actuallysparky/bearamin/field-guide/index.html

BEARAMINFIELD GUIDE / DEVICE EDITOR

YOUR BEARNot connected

USB MIDI or Bluetooth MIDI

Disconnected

Connect your Bearamin ↗

Small bear.
Big possibilities.

FIELD GUIDE / MIDI & GESTURESConnect to get started

LIVE FIELDⅡ

NearFar

X

—

Y

—

Z

—

○ PRESENCE○ SPANK

Connect to see your field.

ON BEIN’ BEAR

Wave a paw.
Bow closer.
Hold still.
Swat the air.

Connect to read your settings.

RevertSave to device ↗

Close
