actuallysparky/bearamin/field-guide/install.html

BEARAMIN / FIELD GUIDE ↗BEARAMIN FAMILY

SMALL BEAR. BIG POSSIBILITIES.

# A little motion. A lot of possibility.

A whole copse of Bearamin friends. Connect yours, find your sound, and make motion yours.

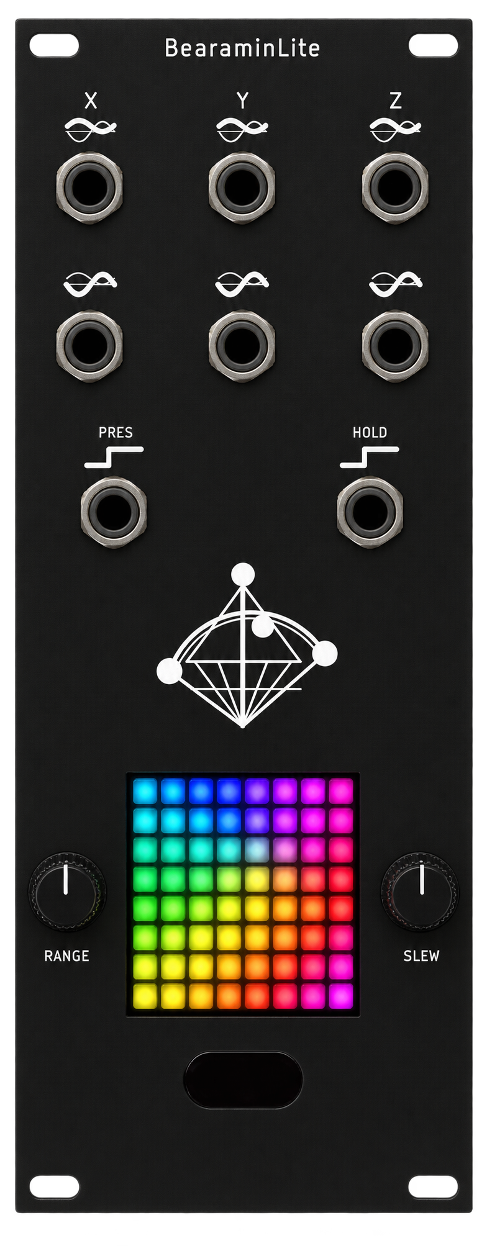
[picture p2: field-guide/panel.png]
Bearamin Lite panel


FIND YOUR FRIEND

## Welcome to the family.

Connect one Bearamin at a time by USB or Bluetooth MIDI, then choose Connect. We’ll find its firmware and show you the steps. For Bluetooth, connect it in your computer’s MIDI settings first.

Connect your Bearamin ↗

First time here?

First firmware update? Choose your Bearamin to get started.

Bearamin LiteBearamin Virtual

RIGHT HERE. READY TO PLAY.

## Your Bearamin is ready.

Let’s play ↗

Need a fresh start? Re-install firmware

LATEST BUILD

## Checking firmware…

Preparing your installation.

1. Open this page in desktop Chrome or Edge and connect Bearamin Lite with a USB data cable.
2. Close any app using its USB connection. Hold BOOT, press and release RESET, then release BOOT if the device does not appear.
3. Choose Install, select your Bearamin’s USB port, and follow the prompts. Keep it powered and connected until installation finishes.
4. Restart your Bearamin, then open Field Guide and choose Connect.

Install Bearamin LiteUse desktop Chrome or Edge to install by USB, or download the firmware below.Open this page using HTTPS to install.Open Field Guide ↗
