actuallysparky/bearamin/bearamin-virtual/hw/bearamin-virtual/Bearamin-Virtual_2040.kicad_pcb

## KiCad design bearamin-virtual/hw/bearamin-virtual/Bearamin-Virtual_2040.kicad_pcb (2026-10-14)

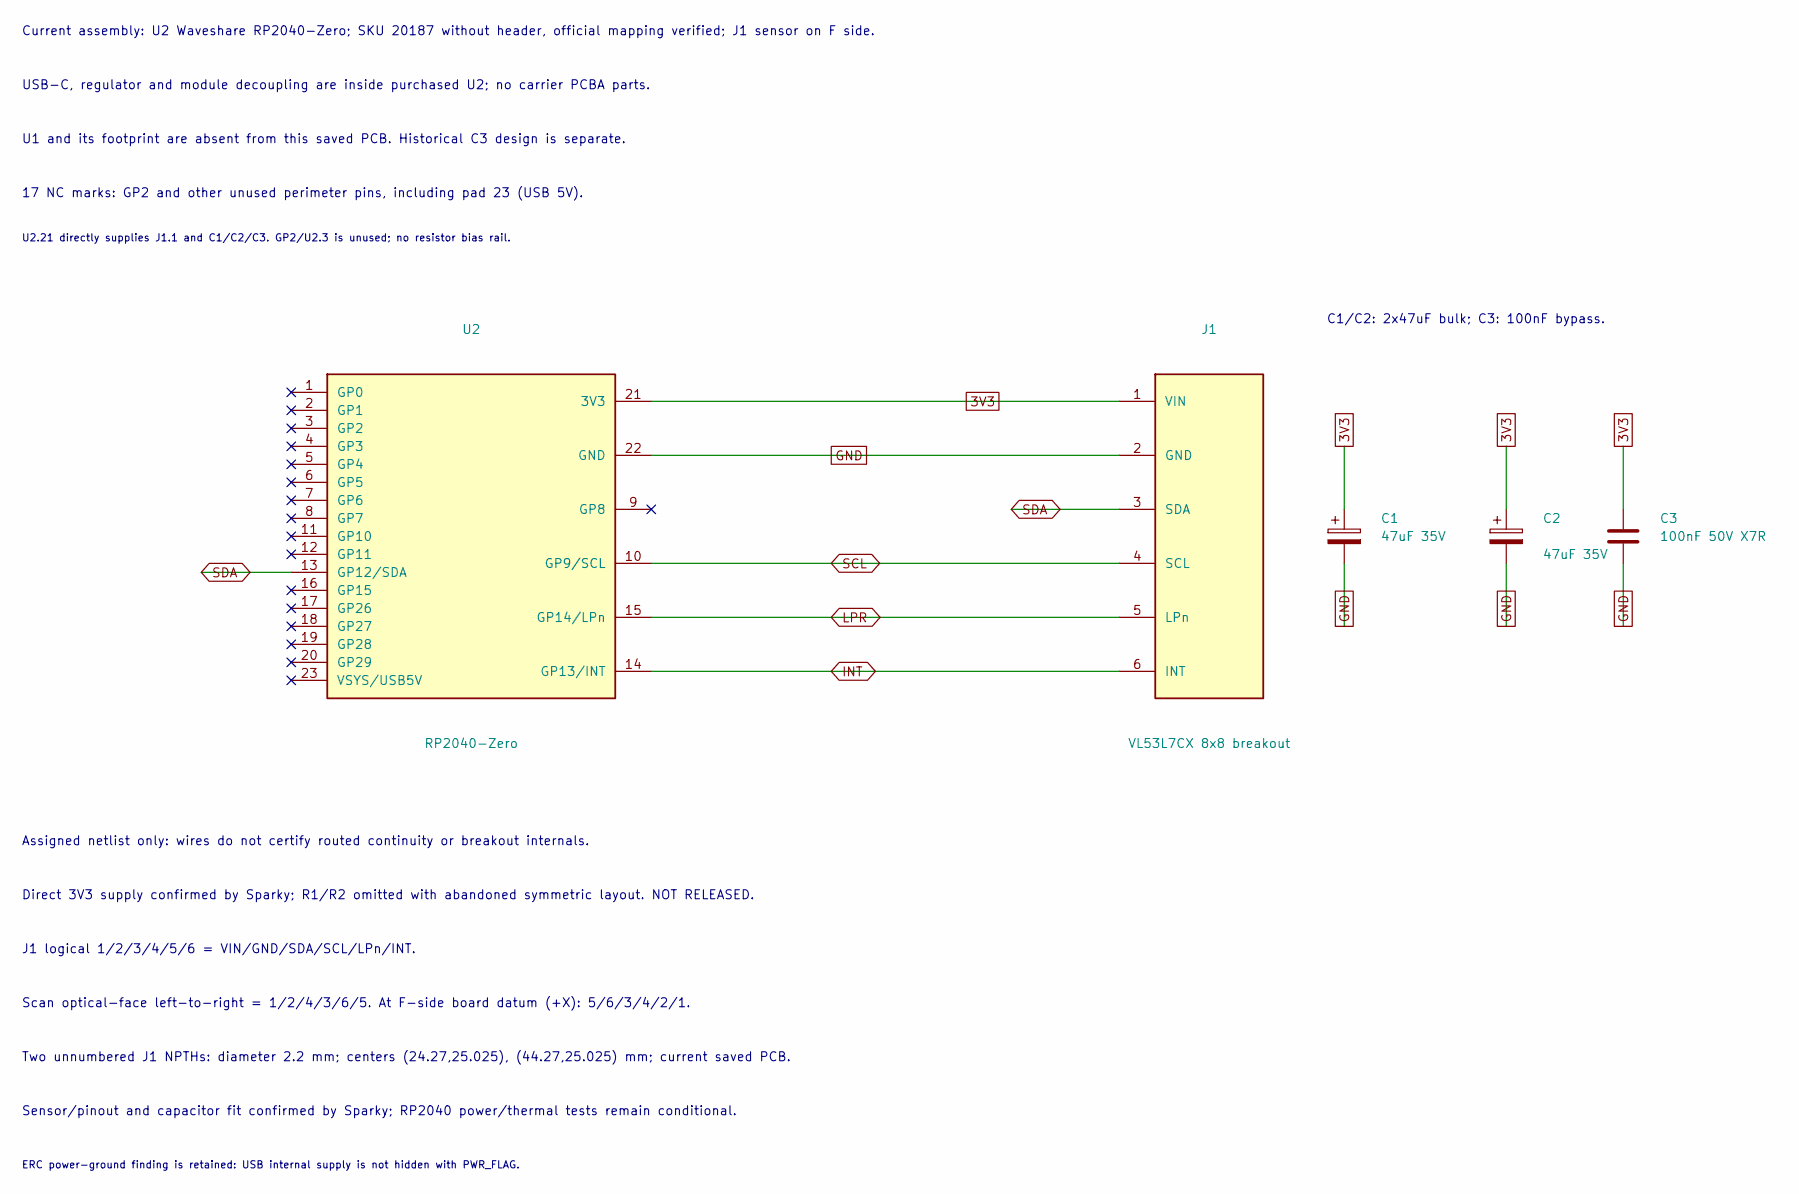
[picture p3: schematic Bearamin-Virtual_2040.kicad_sch, Bearamin Virtual - RP2040 review]

Parts:
C1, C2: 47uF 35V; CP_Radial_D5.0mm_P2.00mm; MPN 35ZLH47MEFC5X11
C3: 100nF 50V X7R; C_Disc_D5.0mm_W2.5mm_P5.00mm; MPN RDER71H104K0M1H03A
J1: VL53L7CX 8x8 breakout; VL53L7CX_8x8_J1_ScanMount
U2: RP2040-Zero; RP2040-Zero_1x23

Connections:
3V3: C1.1, C2.1, C3.1, J1.1 (VIN), U2.21 (3V3)
GND: C1.2, C2.2, C3.2, J1.2 (GND), U2.22 (GND)
INT: J1.6 (INT), U2.14 (GP13/INT)
LPR: J1.5 (LPn), U2.15 (GP14/LPn)
SCL: J1.4 (SCL), U2.10 (GP9/SCL)
SDA: J1.3 (SDA), U2.13 (GP12/SDA)

Notes on the sheet:
Current assembly: U2 Waveshare RP2040-Zero; SKU 20187 without header, official mapping verified; J1 sensor on F side.
USB-C, regulator and module decoupling are inside purchased U2; no carrier PCBA parts.
U1 and its footprint are absent from this saved PCB. Historical C3 design is separate.
17 NC marks: GP2 and other unused perimeter pins, including pad 23 (USB 5V).
Assigned netlist only: wires do not certify routed continuity or breakout internals.
Direct 3V3 supply confirmed by Sparky; R1/R2 omitted with abandoned symmetric layout. NOT RELEASED.
J1 logical 1/2/3/4/5/6 = VIN/GND/SDA/SCL/LPn/INT.
Scan optical-face left-to-right = 1/2/4/3/6/5. At F-side board datum (+X): 5/6/3/4/2/1.
Two unnumbered J1 NPTHs: diameter 2.2 mm; centers (24.27,25.025), (44.27,25.025) mm; current saved PCB.
Sensor/pinout and capacitor fit confirmed by Sparky; RP2040 power/thermal tests remain conditional.
ERC power-ground finding is retained: USB internal supply is not hidden with PWR_FLAG.
C1/C2: 2x47uF bulk; C3: 100nF bypass.
U2.21 directly supplies J1.1 and C1/C2/C3. GP2/U2.3 is unused; no resistor bias rail.

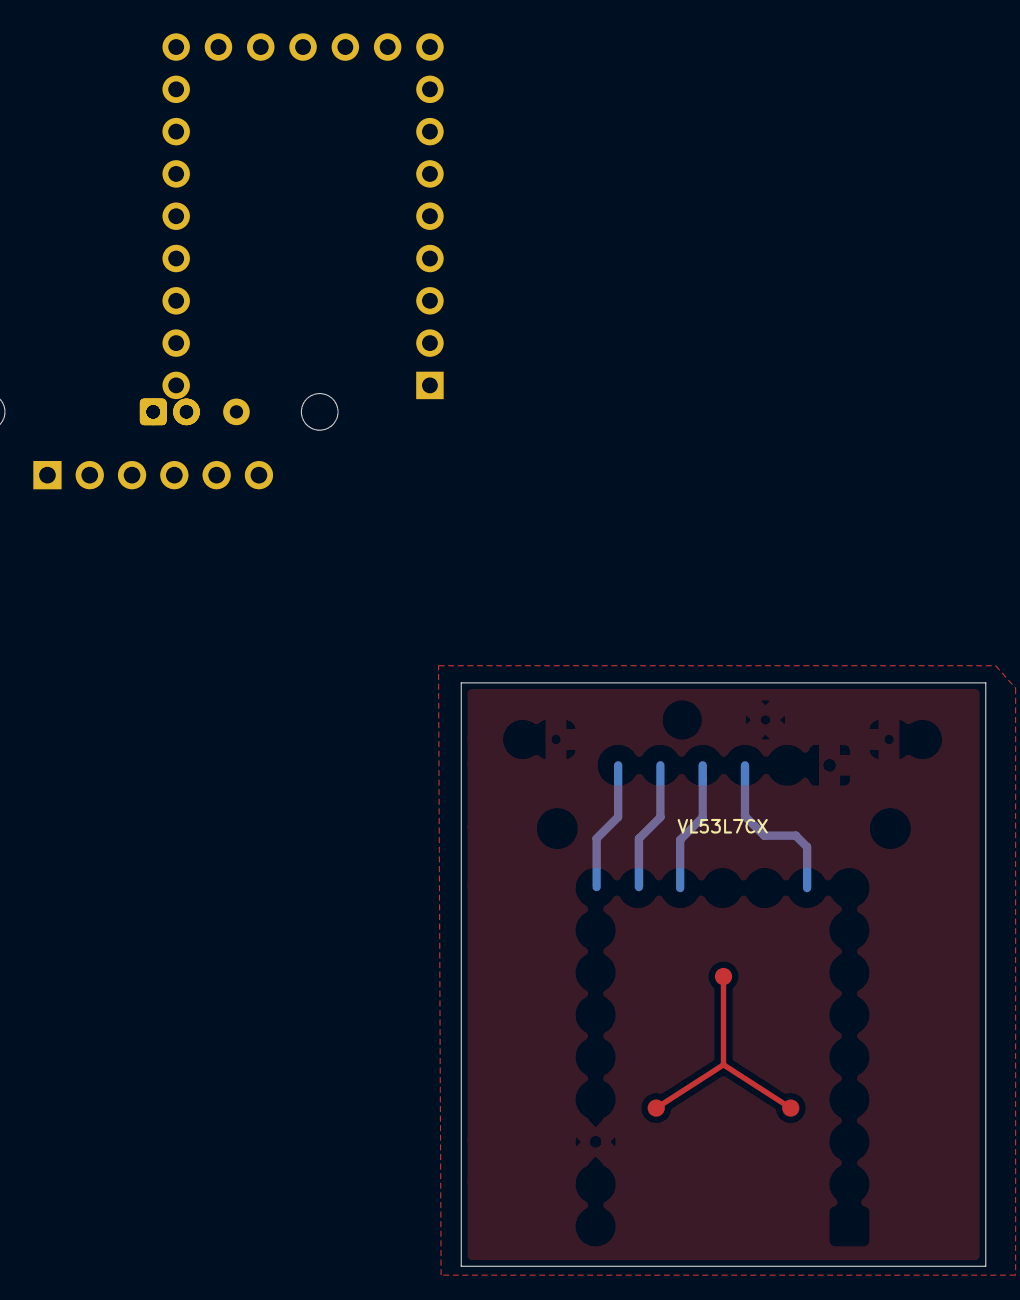
[picture p4: board Bearamin-Virtual_2040.kicad_pcb from above]

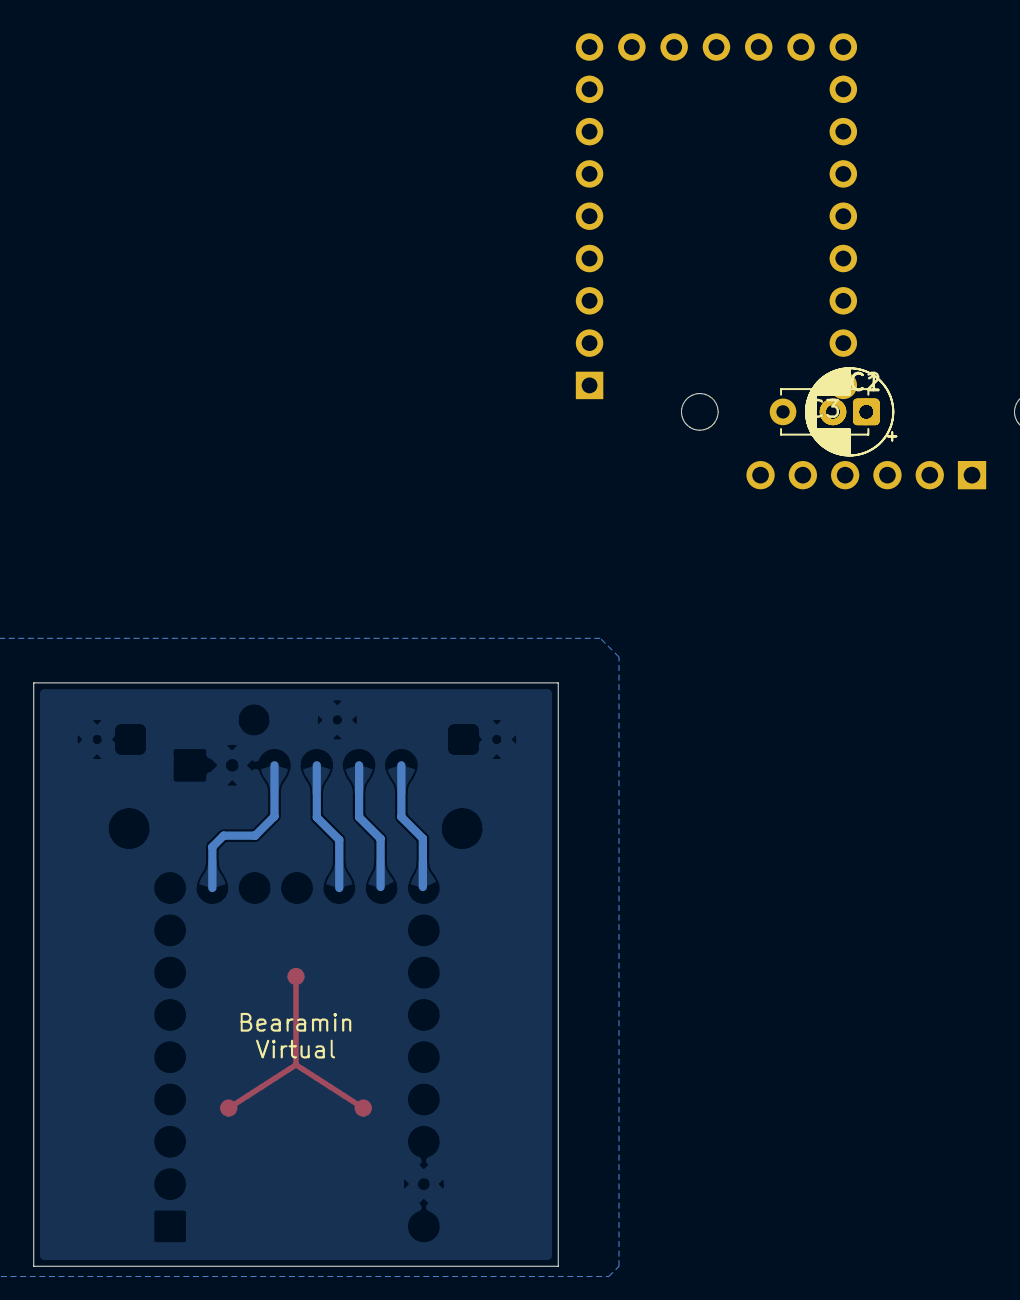
[picture p5: board Bearamin-Virtual_2040.kicad_pcb from below]

Board: 2 copper layers, 31.5 x 35.0 mm, 5 parts (4 on the bottom side), 6 nets.
