actuallysparky/bearamin/bearamin-lite/hw/bearcv-10hp/bearcv-10hp-main_dualMCP4728_routed_DRC_pinremap_revc.kicad_pcb

## KiCad design bearamin-lite/hw/bearcv-10hp/bearcv-10hp-main_dualMCP4728_routed_DRC_pinremap_revc.kicad_pcb (2026-10-14)

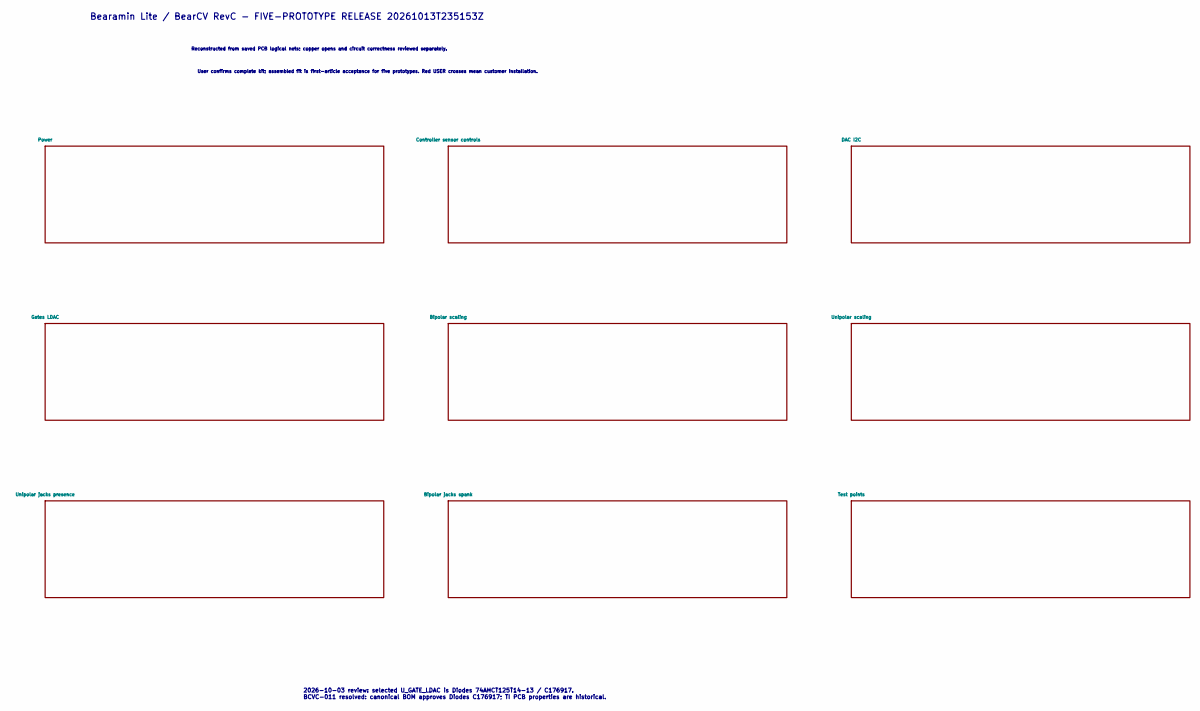
[picture p6: schematic bearcv-10hp-main_dualMCP4728_routed_DRC_pinremap_revc.kicad_sch]

Notes on the sheet:
Bearamin Lite / BearCV RevC - FIVE-PROTOTYPE RELEASE 20261013T235153Z
Reconstructed from saved PCB logical nets; copper opens and circuit correctness reviewed separately.
User confirms complete kit; assembled fit is first-article acceptance for five prototypes. Red USER crosses mean customer installation.
2026-10-03 review: selected U_GATE_LDAC is Diodes 74AHCT125T14-13 / C176917. BCVC-011 resolved: canonical BOM approves Diodes C176917; TI PCB properties are historical.

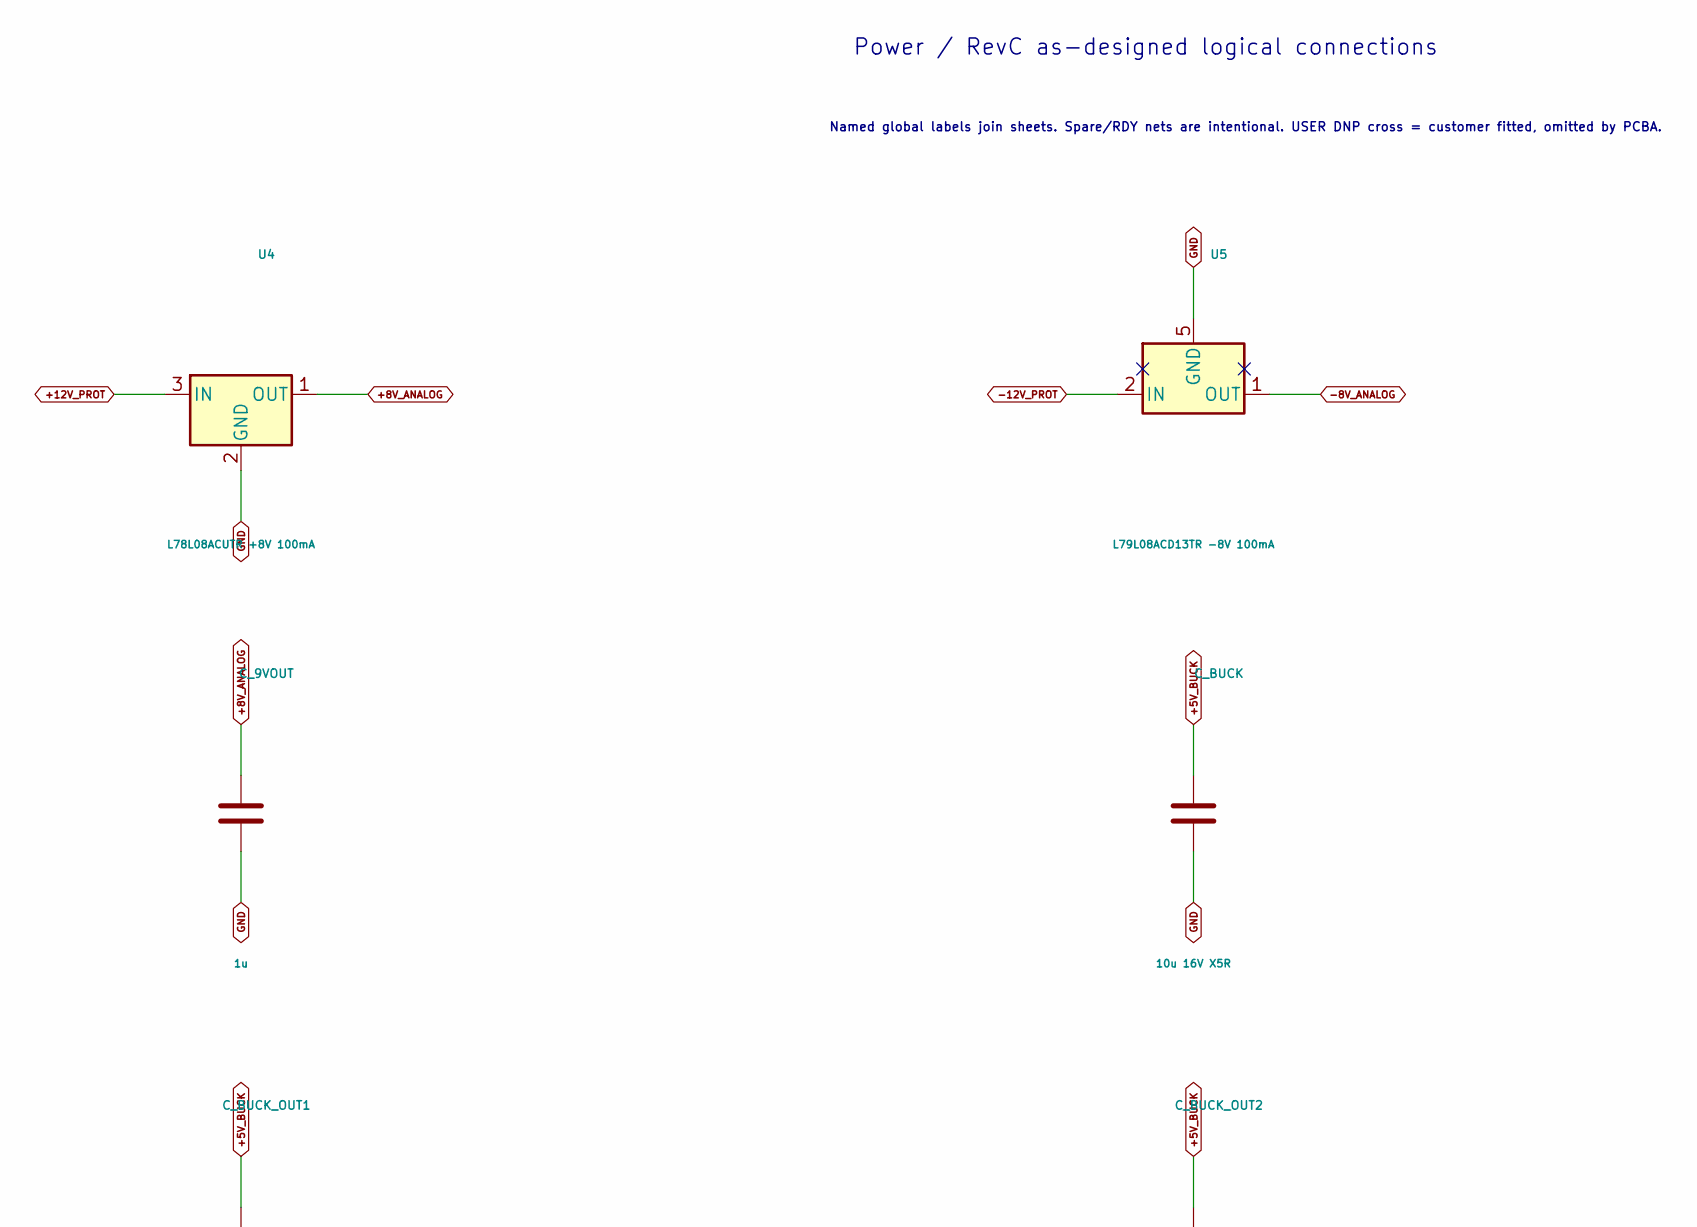
[picture p7: schematic bearcv-10hp-main_dualMCP4728_routed_DRC_pinremap_revc_Power.kicad_sch, part in row 1, column 1]

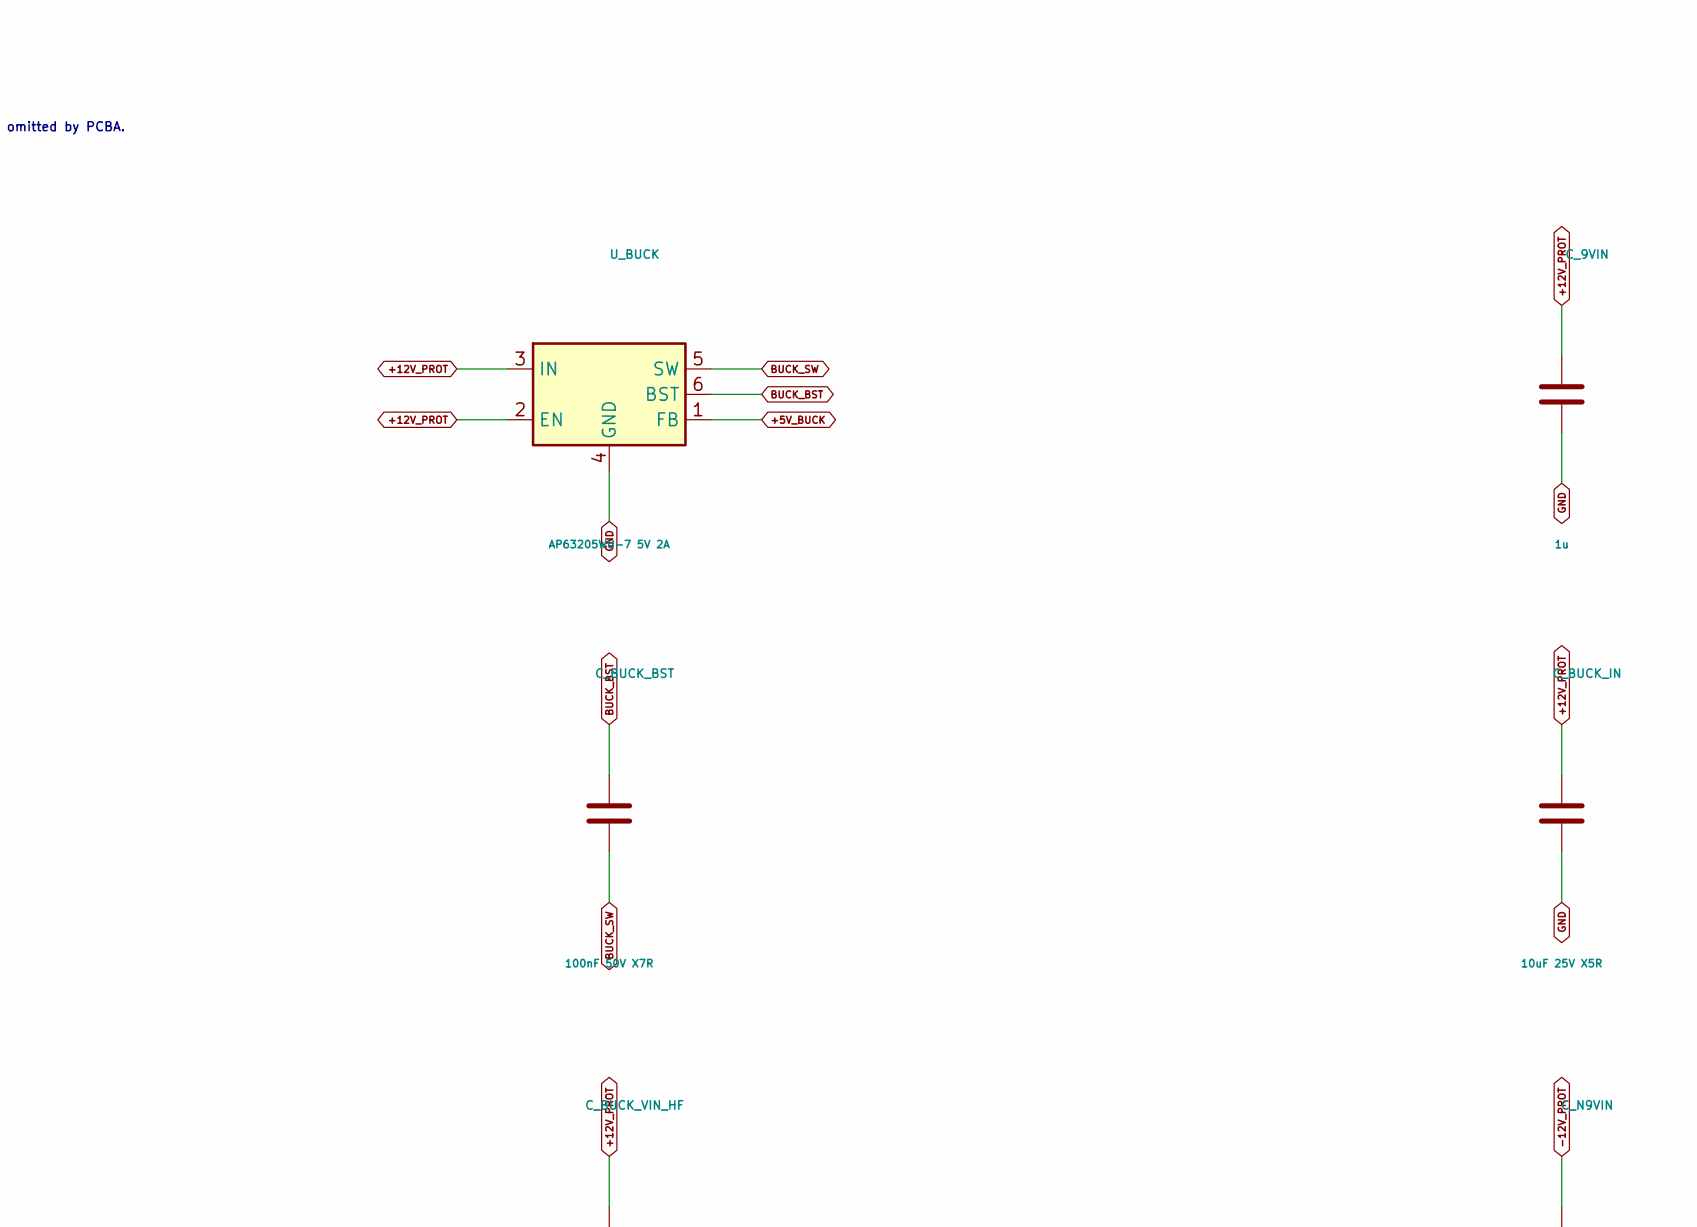
[picture p8: schematic bearcv-10hp-main_dualMCP4728_routed_DRC_pinremap_revc_Power.kicad_sch, part in row 1, column 2]

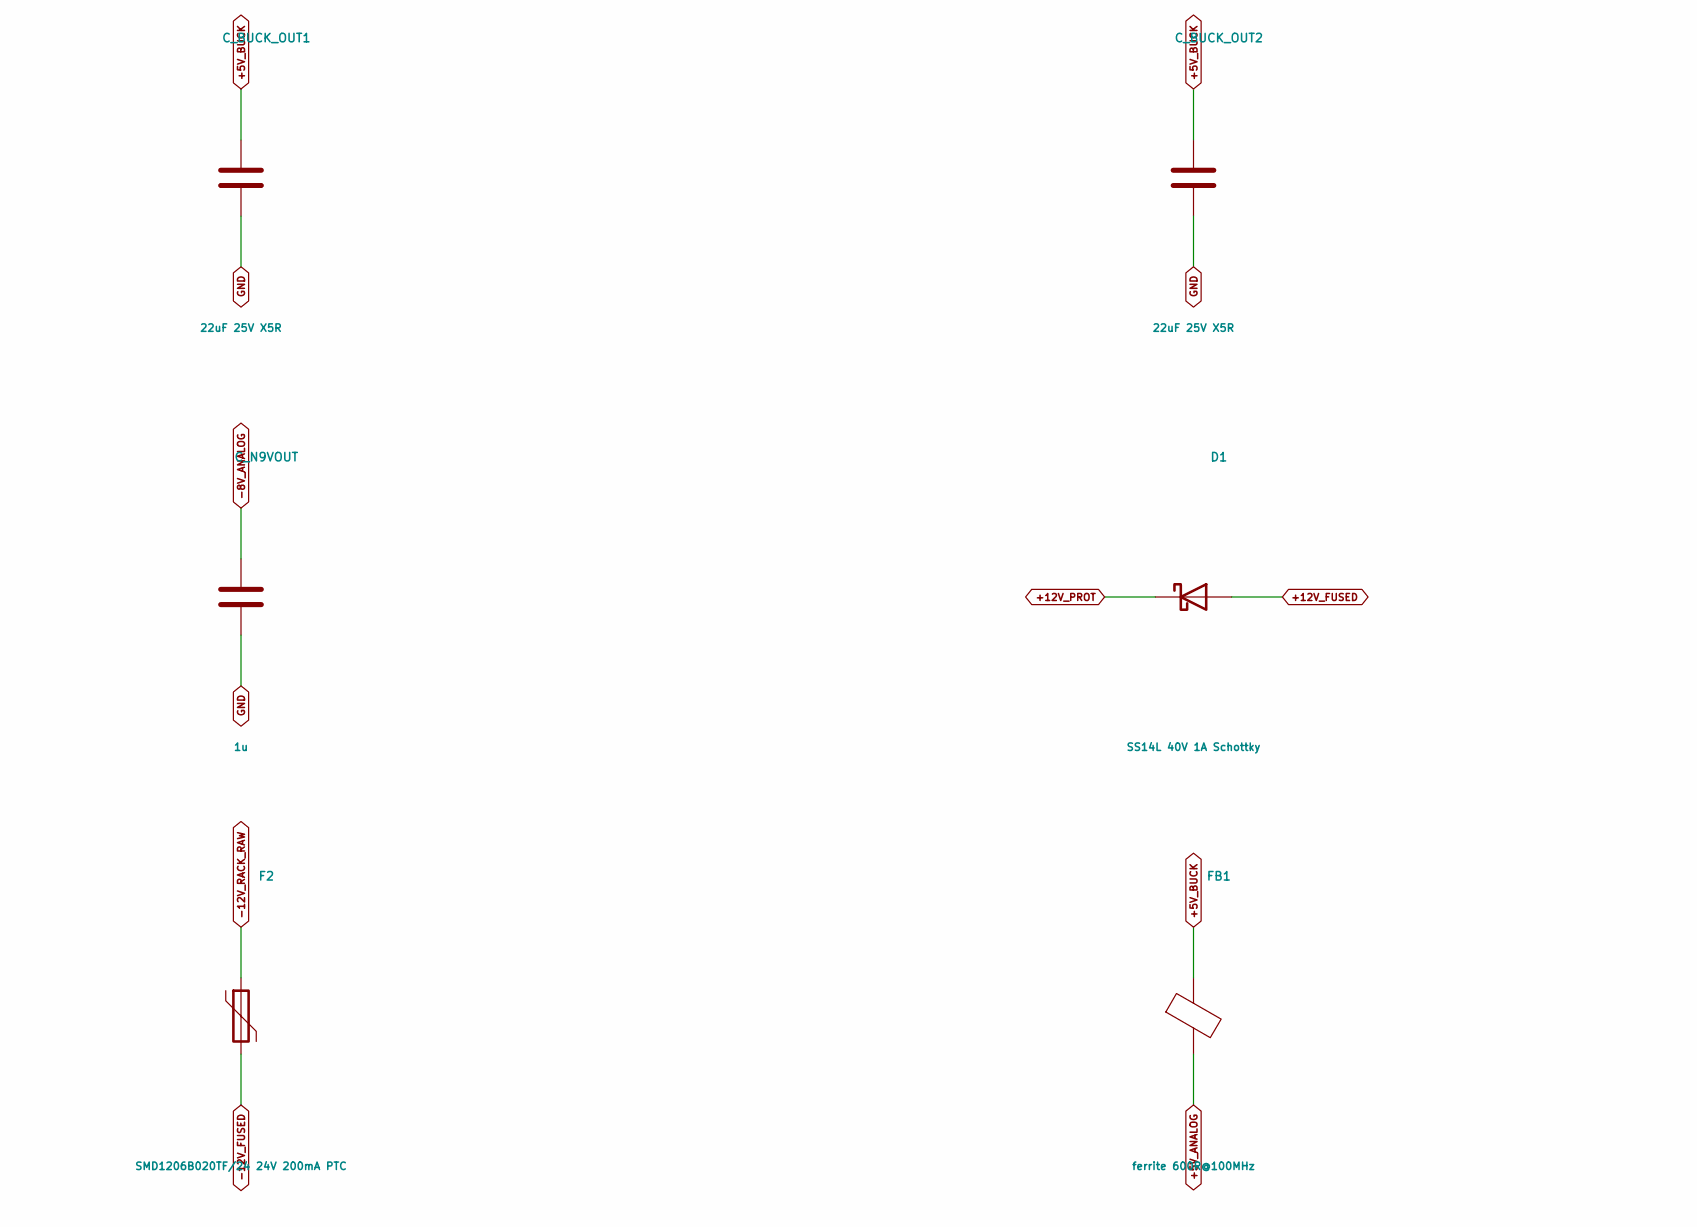
[picture p9: schematic bearcv-10hp-main_dualMCP4728_routed_DRC_pinremap_revc_Power.kicad_sch, part in row 2, column 1]

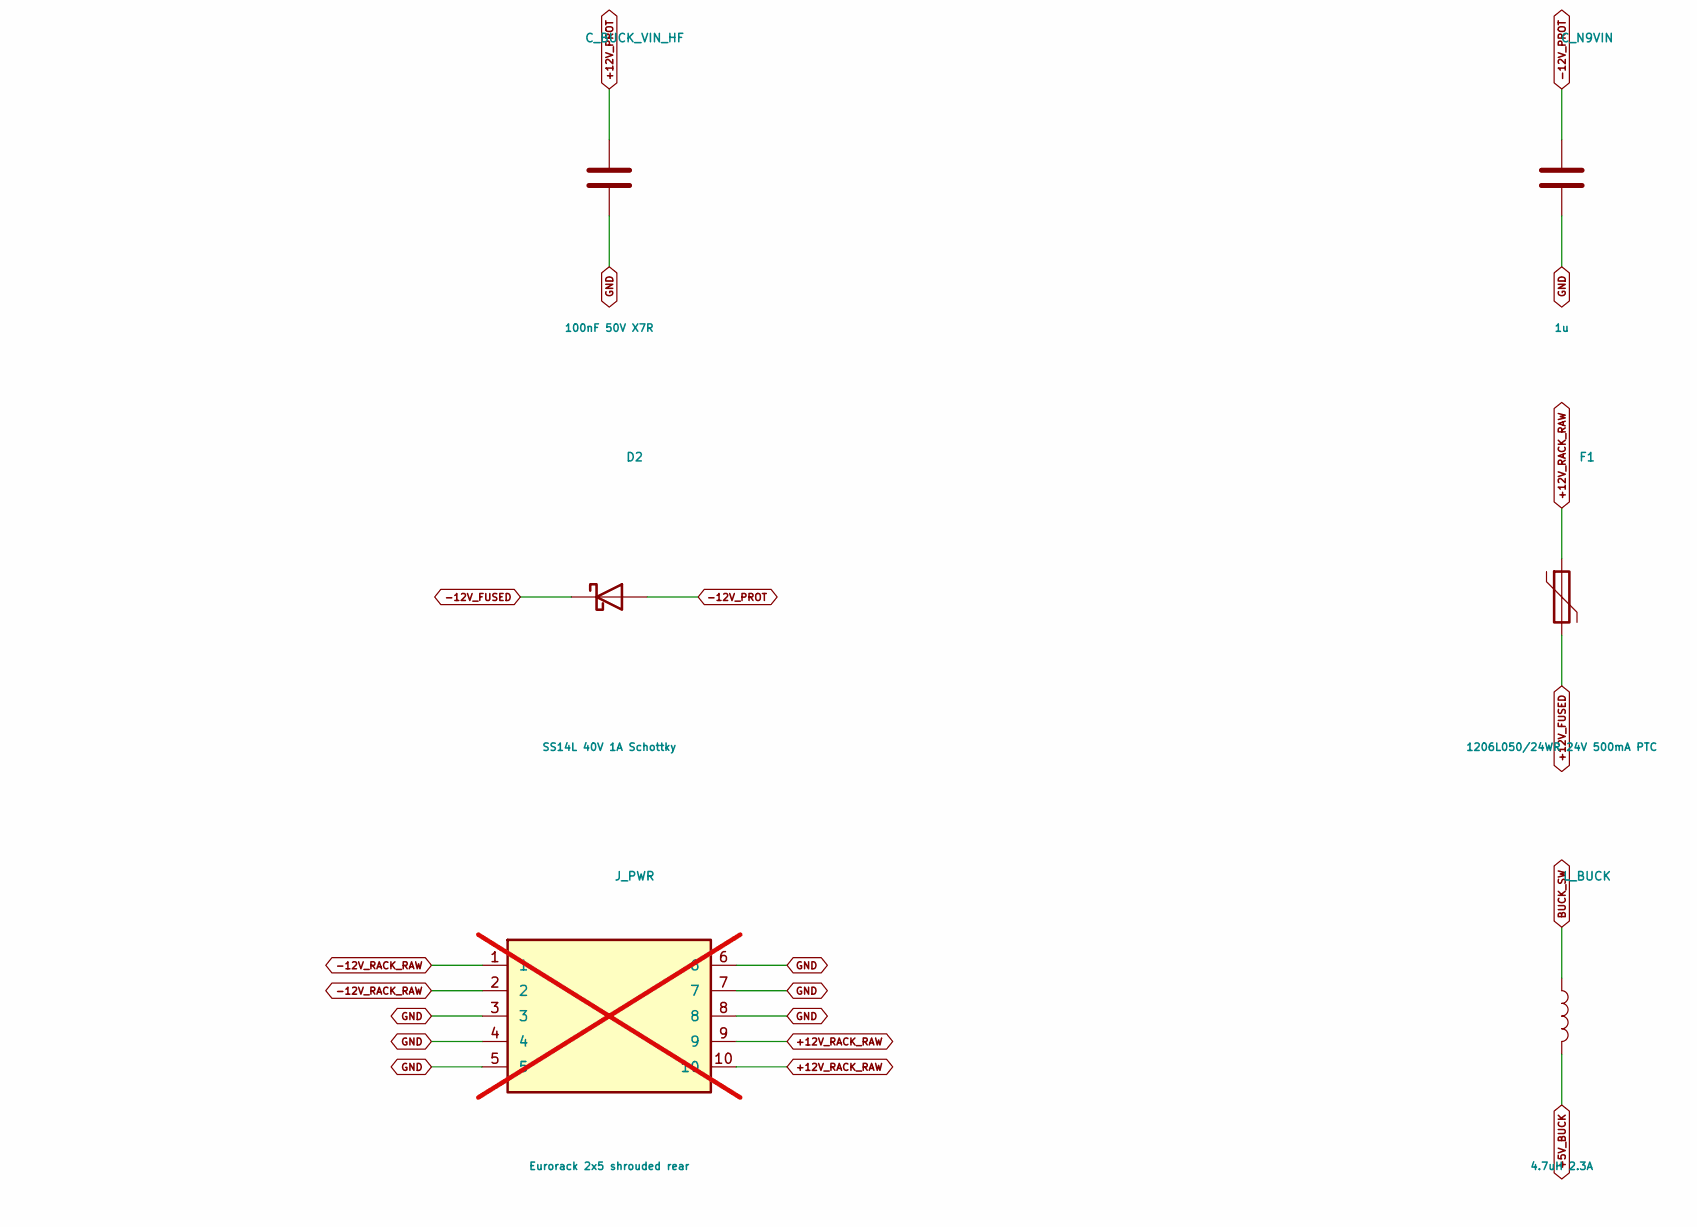
[picture p10: schematic bearcv-10hp-main_dualMCP4728_routed_DRC_pinremap_revc_Power.kicad_sch, part in row 2, column 2]

Parts:
C_9VIN, C_9VOUT: 1u; MPN CL10A105KB8NNNC; JLCPCB Part C15849
C_BUCK: 10u 16V X5R; MPN CL10A106MA8NRNC; JLCPCB Part C96446
C_BUCK_BST: 100nF 50V X7R; MPN CC0603KRX7R9BB104; JLCPCB Part C14663
C_BUCK_IN: 10uF 25V X5R; MPN CL21A106KAYNNNE; JLCPCB Part C15850
C_BUCK_OUT1, C_BUCK_OUT2: 22uF 25V X5R; MPN CL21A226MAQNNNE; JLCPCB Part C45783
C_BUCK_VIN_HF: 100nF 50V X7R; MPN CC0603KRX7R9BB104; JLCPCB Part C14663
C_N9VIN, C_N9VOUT: 1u; MPN CL10A105KB8NNNC; JLCPCB Part C15849
D1, D2: SS14L 40V 1A Schottky; MPN SS14L; JLCPCB Library Extended
F1: 1206L050/24WR 24V 500mA PTC; MPN 1206L050/24WR; JLCPCB Library Extended
F2: SMD1206B020TF/24 24V 200mA PTC; MPN SMD1206B020TF/24; JLCPCB Library Extended
FB1: ferrite 600R@100MHz; MPN GZ1608D601TF; JLCPCB Part C1002
J_PWR: Eurorack 2x5 shrouded rear; IDC-Header_2x05_P2.54mm_Vertical; MPN DNP; not fitted
L_BUCK: 4.7uH 2.3A; MPN SLW4020P4R7MST; JLCPCB Part C207886
U4: L78L08ACUTR +8V 100mA; MPN L78L08ACUTR; JLCPCB Library Extended
U5: L79L08ACD13TR -8V 100mA; MPN L79L08ACD13TR; JLCPCB Library Extended
U_BUCK: AP63205WU-7 5V 2A; MPN AP63205WU-7; JLCPCB Part C2071056

Connections:
+5V_ANALOG: FB1.2; also elsewhere on the board
+5V_BUCK: C_BUCK.1, C_BUCK_OUT1.1, C_BUCK_OUT2.1, FB1.1, L_BUCK.2, U_BUCK.1 (FB); also elsewhere on the board
+8V_ANALOG: C_9VOUT.1, U4.1 (OUT); also elsewhere on the board
+12V_FUSED: D1.2 (A), F1.2
+12V_PROT: C_9VIN.1, C_BUCK_IN.1, C_BUCK_VIN_HF.1, D1.1 (K), U4.3 (IN), U_BUCK.2 (EN), U_BUCK.3 (IN); also elsewhere on the board
+12V_RACK_RAW: F1.1, J_PWR.9, J_PWR.10
-8V_ANALOG: C_N9VOUT.1, U5.1 (OUT); also elsewhere on the board
-12V_FUSED: D2.1 (K), F2.2
-12V_PROT: C_N9VIN.1, D2.2 (A), U5.2 (IN), U5.3 (IN), U5.6 (IN), U5.7 (IN); also elsewhere on the board
-12V_RACK_RAW: F2.1, J_PWR.1, J_PWR.2
BUCK_BST: C_BUCK_BST.1, U_BUCK.6 (BST)
BUCK_SW: C_BUCK_BST.2, L_BUCK.1, U_BUCK.5 (SW)
GND: C_9VIN.2, C_9VOUT.2, C_BUCK.2, C_BUCK_IN.2, C_BUCK_OUT1.2, C_BUCK_OUT2.2, C_BUCK_VIN_HF.2, C_N9VIN.2, C_N9VOUT.2, J_PWR.3, J_PWR.4, J_PWR.5, J_PWR.6, J_PWR.7, J_PWR.8, U4.2 (GND), U5.5 (GND), U_BUCK.4 (GND); also elsewhere on the board

Notes on the sheet:
Power / RevC as-designed logical connections
Named global labels join sheets. Spare/RDY nets are intentional. USER DNP cross = customer fitted, omitted by PCBA.

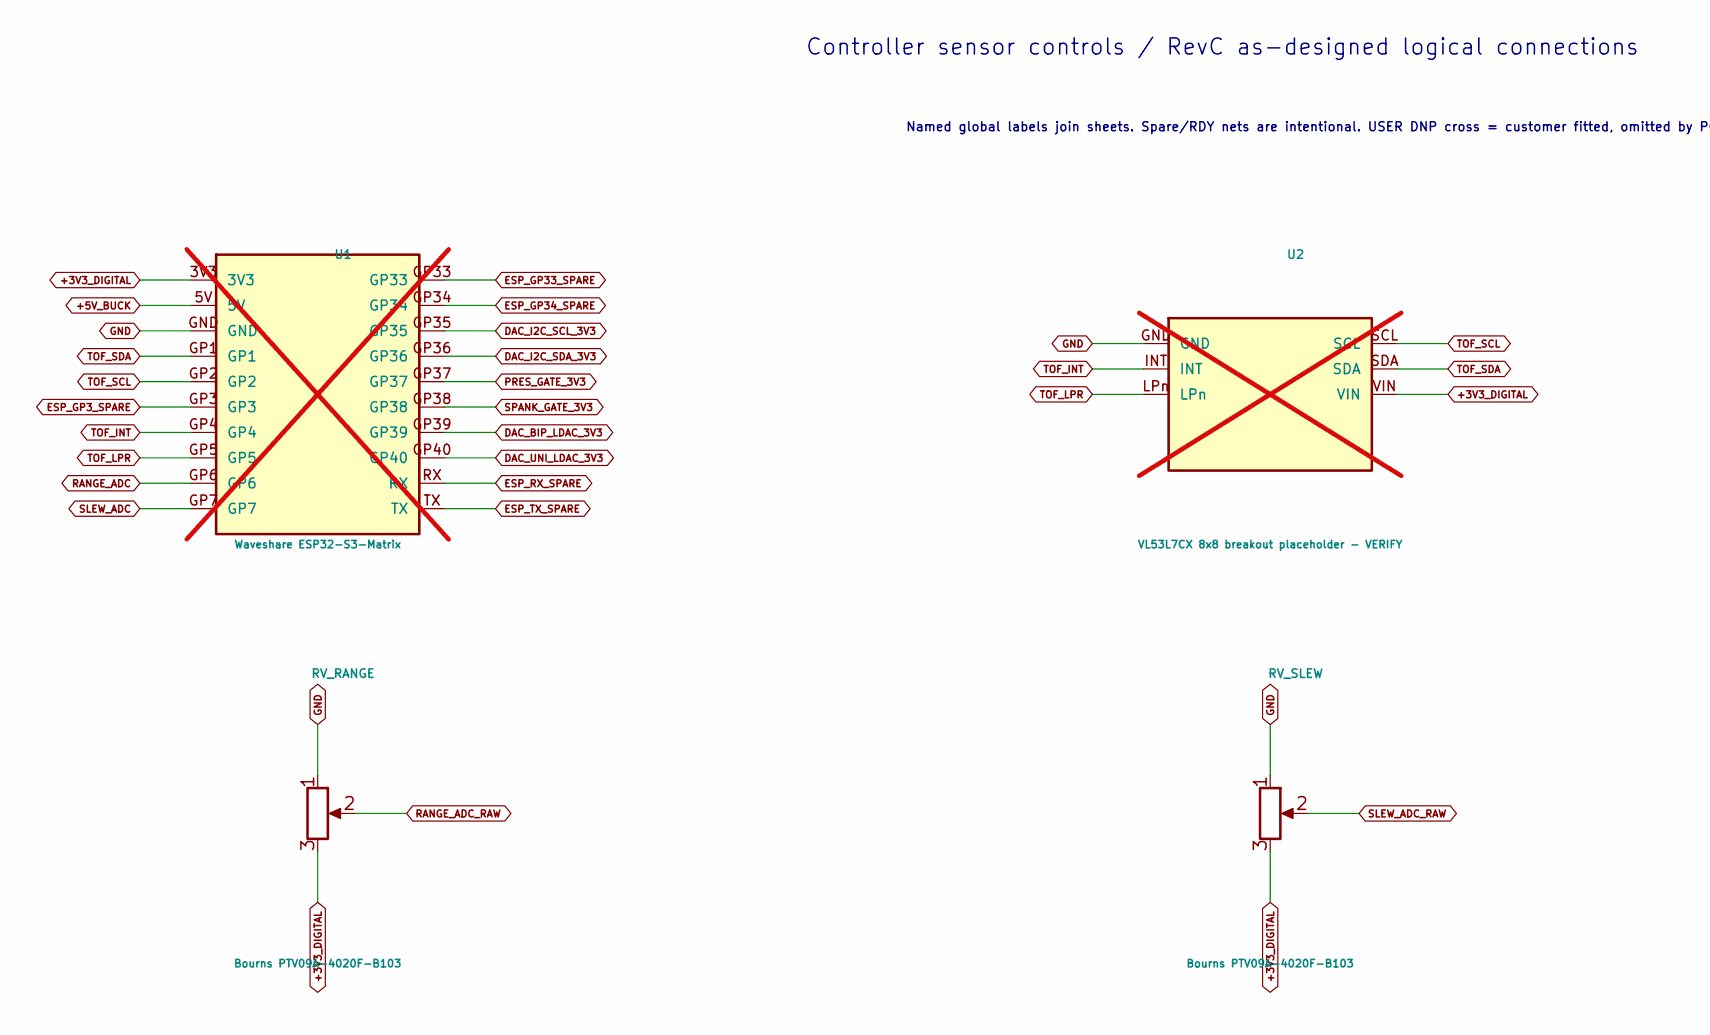
[picture p11: schematic bearcv-10hp-main_dualMCP4728_routed_DRC_pinremap_revc_Controller_sensor_controls.kicad_sch, part in row 1, column 1]

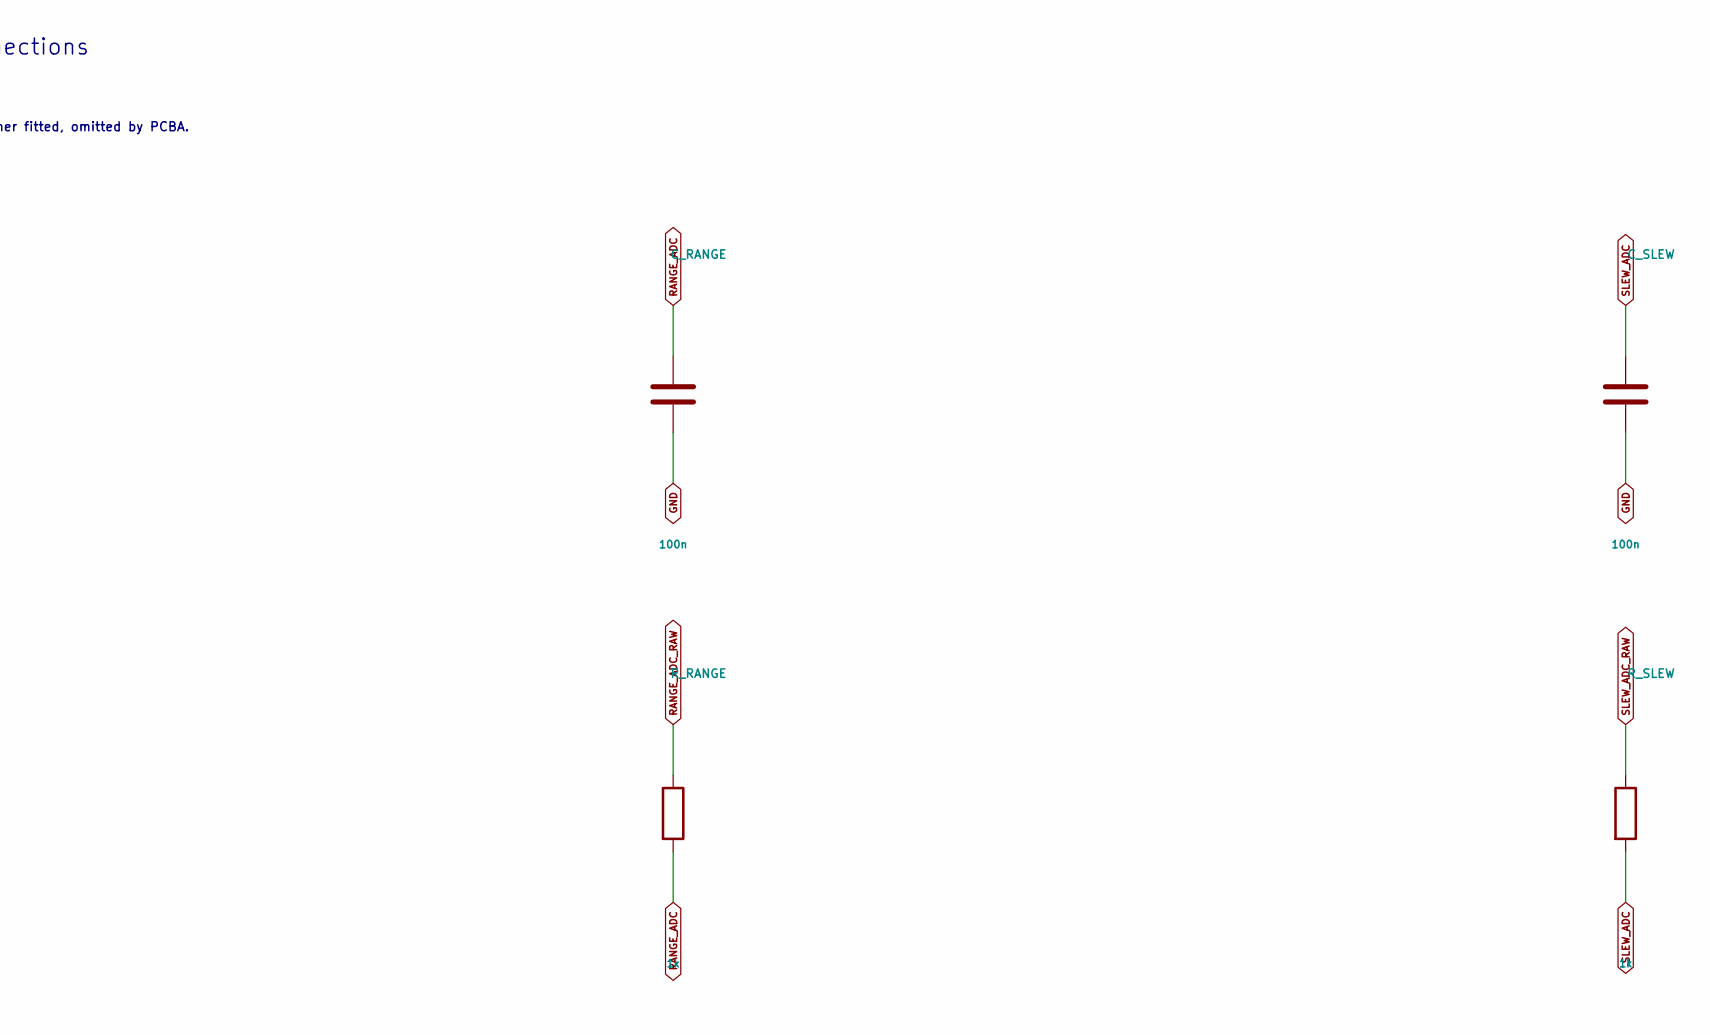
[picture p12: schematic bearcv-10hp-main_dualMCP4728_routed_DRC_pinremap_revc_Controller_sensor_controls.kicad_sch, part in row 1, column 2]

Parts:
C_RANGE: 100n; MPN CC0603KRX7R9BB104; JLCPCB Part C14663
C_SLEW: 100n; MPN CC0603KRX7R9BB104; JLCPCB Part C14663
RV_RANGE: Bourns PTV09A-4020F-B103; Potentiometer_Bourns_PTV09A-4F_L20mm_Horizontal_Rear; MPN PTV09A-4020F-B103
RV_SLEW: Bourns PTV09A-4020F-B103; Potentiometer_Bourns_PTV09A-4F_L20mm_Horizontal_Rear; MPN PTV09A-4020F-B103
R_RANGE: 1k; MPN 0603WAF1001T5E; JLCPCB Part C21190
R_SLEW: 1k; MPN 0603WAF1001T5E; JLCPCB Part C21190
U1: Waveshare ESP32-S3-Matrix; MPN DNP; not fitted
U2: VL53L7CX 8x8 breakout placeholder - VERIFY; MPN DNP; not fitted

Connections:
+3V3_DIGITAL: RV_RANGE.3, RV_SLEW.3, U1.3V3, U2.VIN; also elsewhere on the board
+5V_BUCK: U1.5V; also elsewhere on the board
DAC_BIP_LDAC_3V3: U1.GP39; also elsewhere on the board
DAC_I2C_SCL_3V3: U1.GP35; also elsewhere on the board
DAC_I2C_SDA_3V3: U1.GP36; also elsewhere on the board
DAC_UNI_LDAC_3V3: U1.GP40; also elsewhere on the board
ESP_GP3_SPARE: U1.GP3
ESP_GP33_SPARE: U1.GP33
ESP_GP34_SPARE: U1.GP34
ESP_RX_SPARE: U1.RX
ESP_TX_SPARE: U1.TX
GND: C_RANGE.2, C_SLEW.2, RV_RANGE.1, RV_SLEW.1, U1.GND, U2.GND; also elsewhere on the board
PRES_GATE_3V3: U1.GP37; also elsewhere on the board
RANGE_ADC: C_RANGE.1, R_RANGE.2, U1.GP6
RANGE_ADC_RAW: RV_RANGE.2, R_RANGE.1
SLEW_ADC: C_SLEW.1, R_SLEW.2, U1.GP7
SLEW_ADC_RAW: RV_SLEW.2, R_SLEW.1
SPANK_GATE_3V3: U1.GP38; also elsewhere on the board
TOF_INT: U1.GP4, U2.INT
TOF_LPR: U1.GP5, U2.LPn
TOF_SCL: U1.GP2, U2.SCL
TOF_SDA: U1.GP1, U2.SDA

Notes on the sheet:
Controller sensor controls / RevC as-designed logical connections
Named global labels join sheets. Spare/RDY nets are intentional. USER DNP cross = customer fitted, omitted by PCBA.
