actuallysparky/bearamin/bearamin-lite/hw/bearcv-10hp/bearcv-10hp-main_dualMCP4728_routed_DRC_pinremap_revc.kicad_pcb

## KiCad design bearamin-lite/hw/bearcv-10hp/bearcv-10hp-main_dualMCP4728_routed_DRC_pinremap_revc.kicad_pcb (continued)

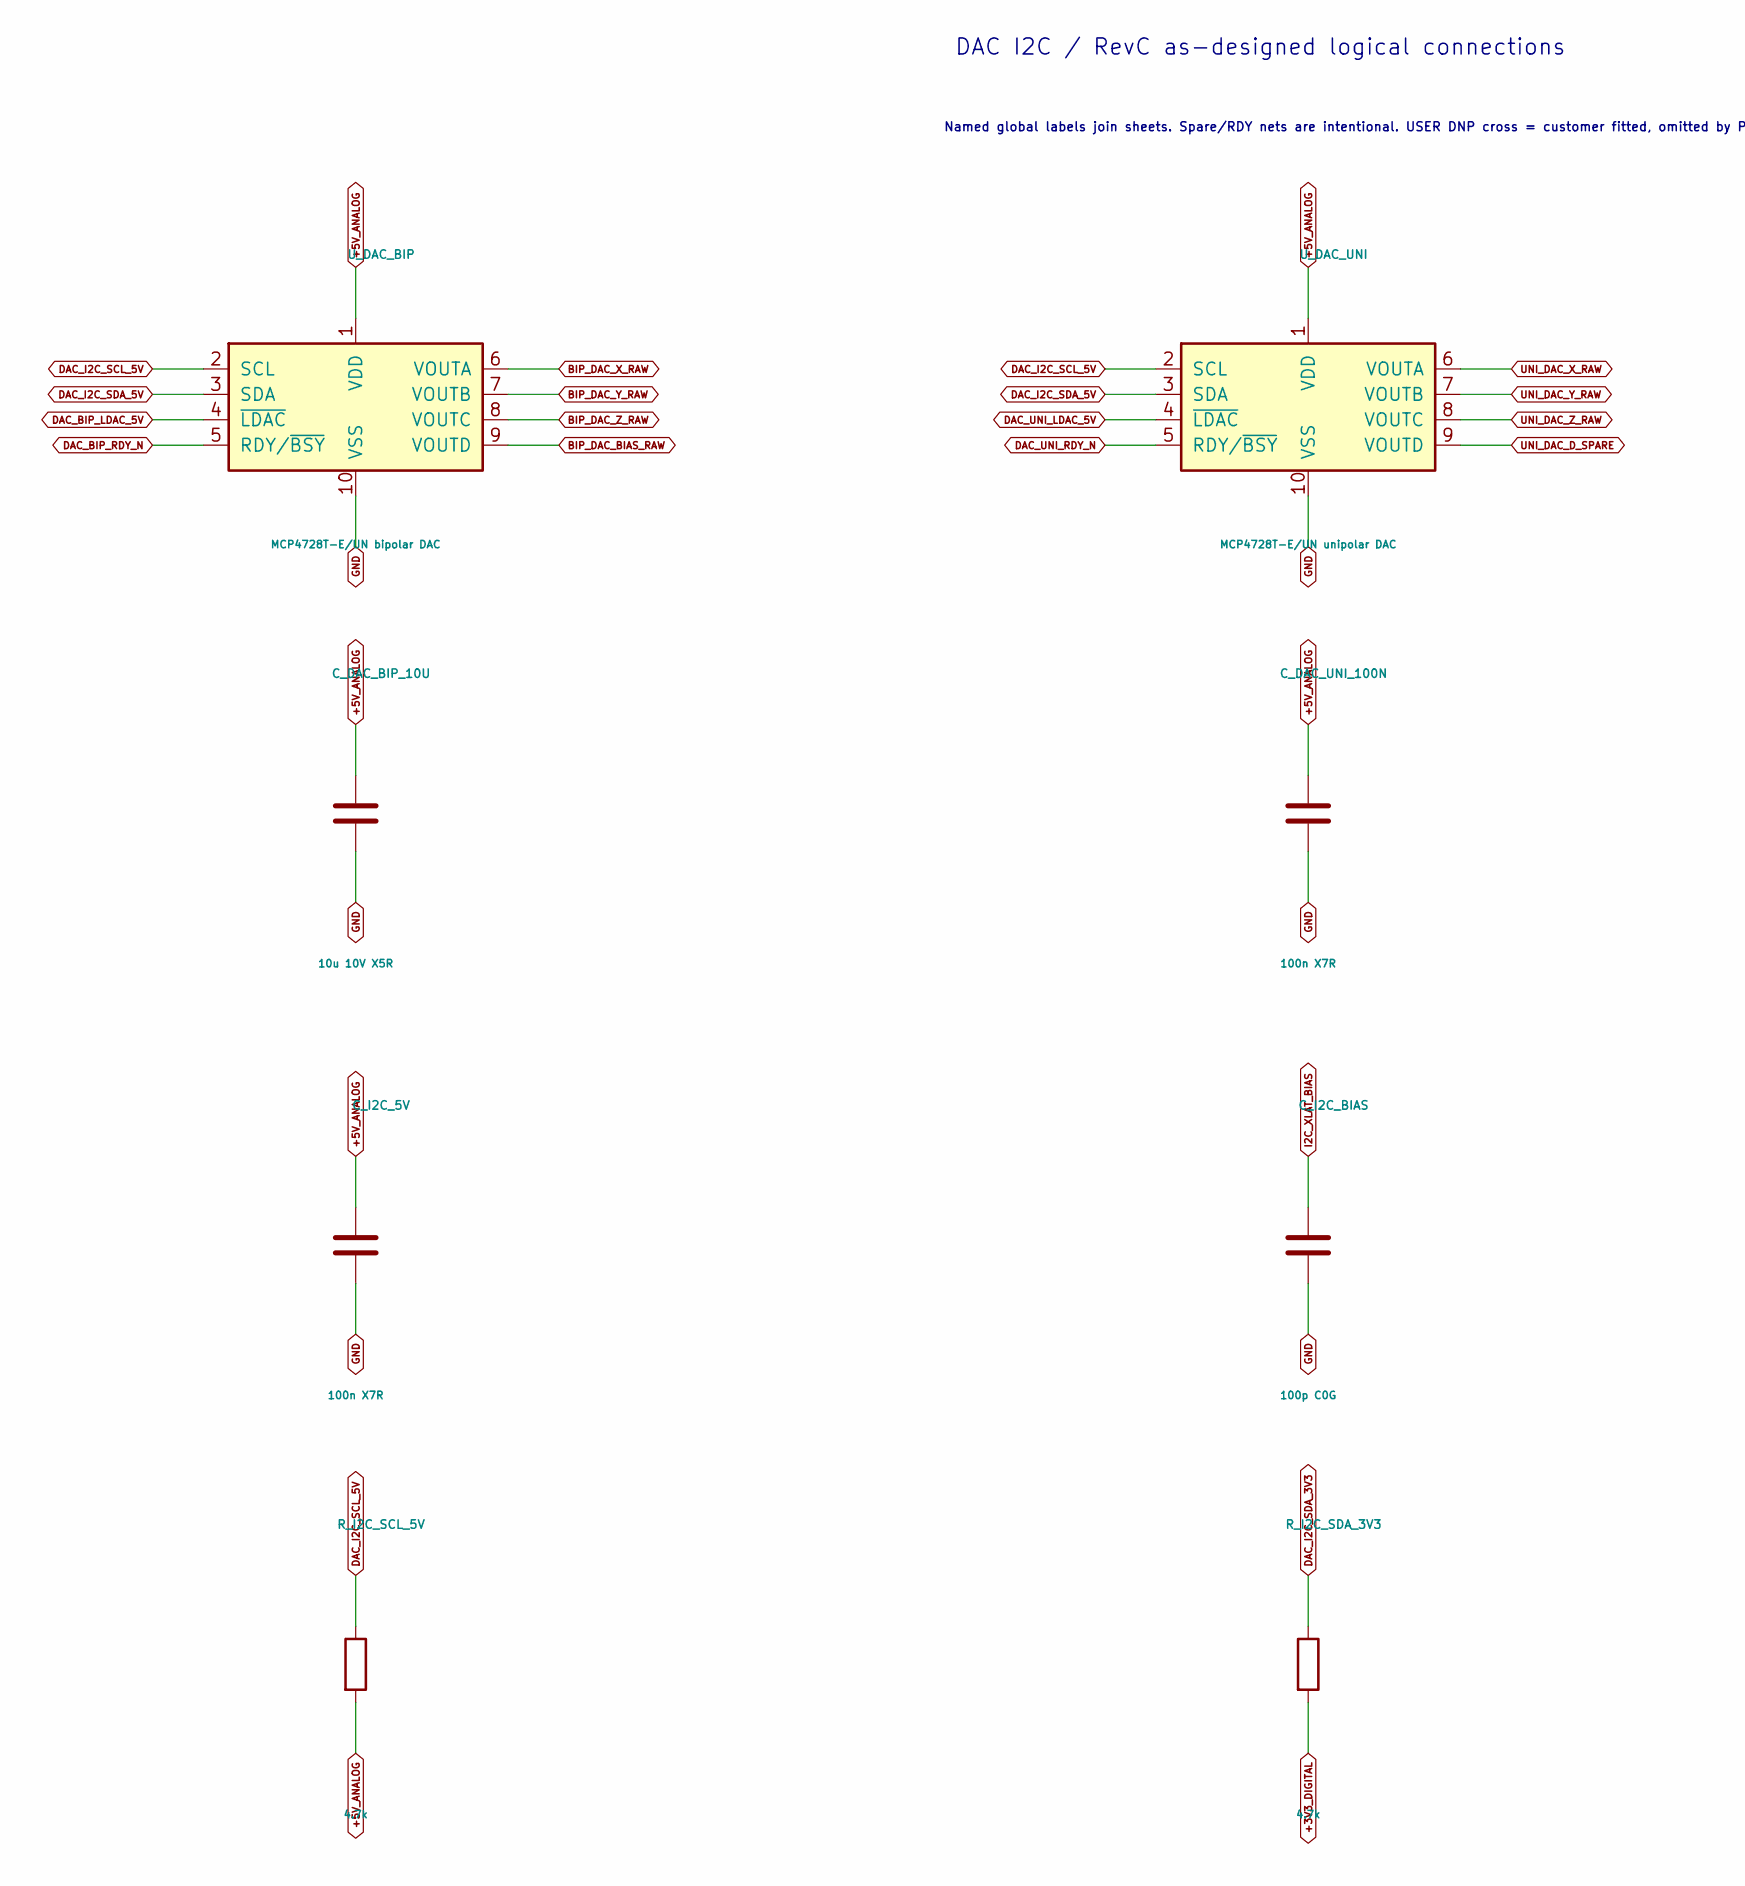
[picture p13: schematic bearcv-10hp-main_dualMCP4728_routed_DRC_pinremap_revc_DAC_I2C.kicad_sch, part in row 1, column 1]

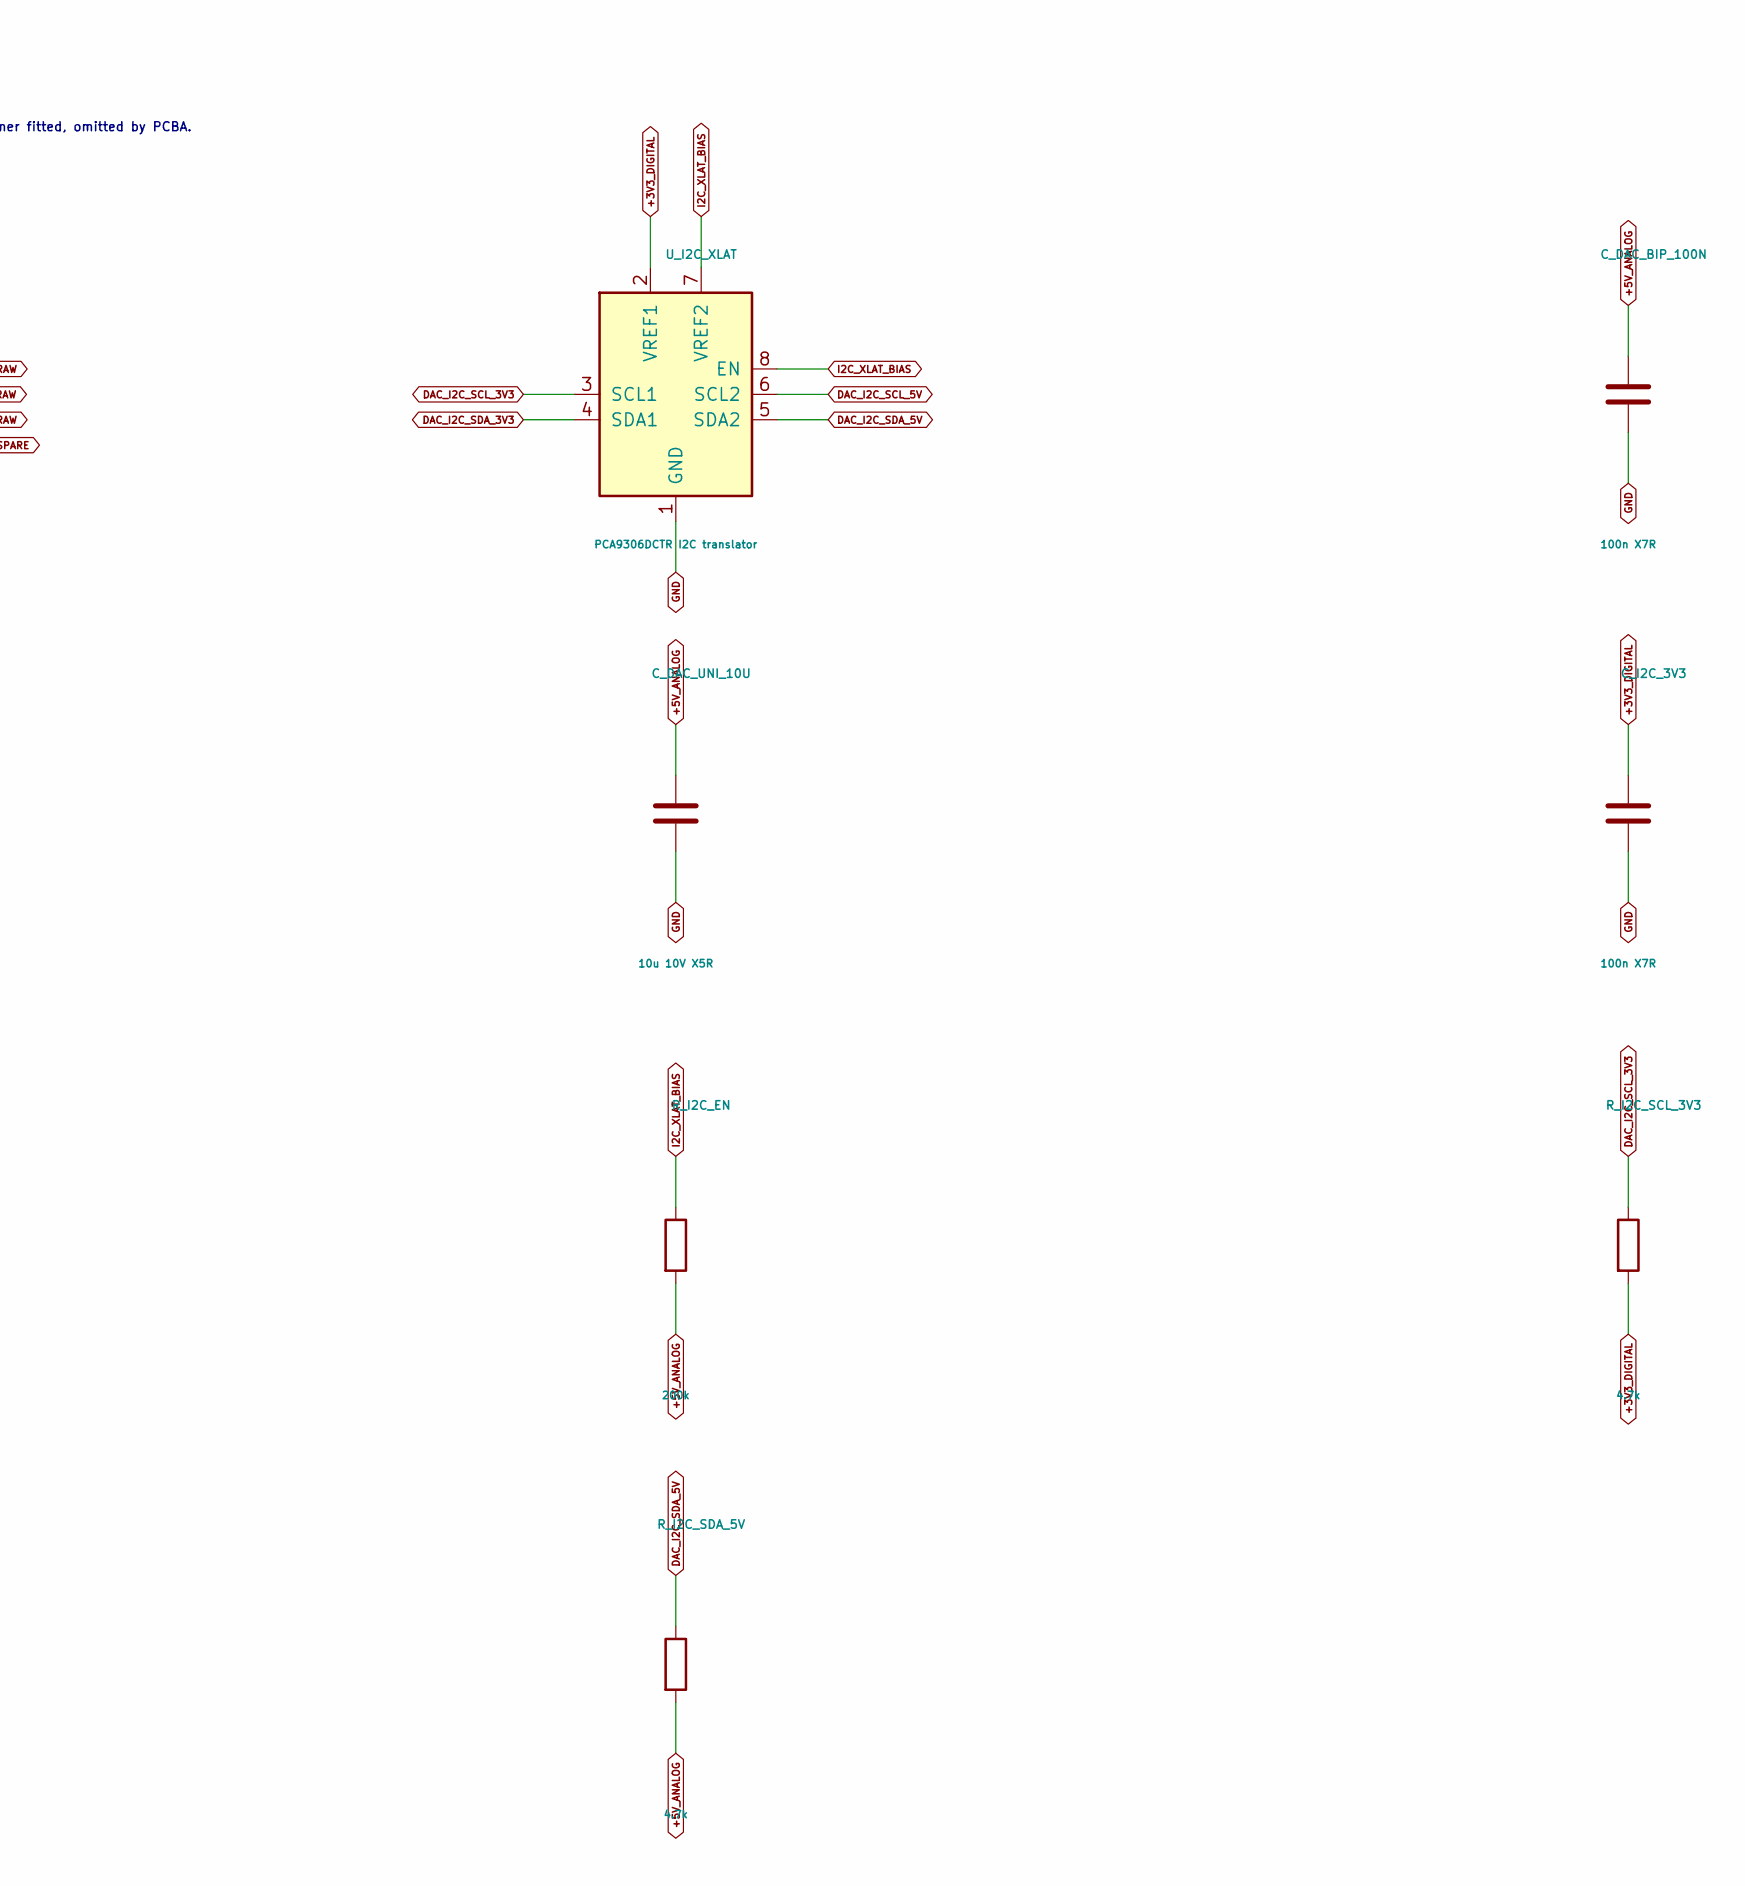
[picture p14: schematic bearcv-10hp-main_dualMCP4728_routed_DRC_pinremap_revc_DAC_I2C.kicad_sch, part in row 1, column 2]

Parts:
C_DAC_BIP_10U: 10u 10V X5R; MPN CL10A106MA8NRNC; JLCPCB Part C96446
C_DAC_BIP_100N: 100n X7R; MPN CC0603KRX7R9BB104; JLCPCB Part C14663
C_DAC_UNI_10U: 10u 10V X5R; MPN CL10A106MA8NRNC; JLCPCB Part C96446
C_DAC_UNI_100N: 100n X7R; MPN CC0603KRX7R9BB104; JLCPCB Part C14663
C_I2C_3V3, C_I2C_5V: 100n X7R; MPN CC0603KRX7R9BB104; JLCPCB Part C14663
C_I2C_BIAS: 100p C0G; MPN CL10C101JB8NNNC; JLCPCB Part C14858
R_I2C_EN: 200k; MPN 0603WAF2003T5E; JLCPCB Part C25811
R_I2C_SCL_3V3, R_I2C_SCL_5V, R_I2C_SDA_3V3, R_I2C_SDA_5V: 4.7k; MPN 0603WAF4701T5E; JLCPCB Part C23162
U_DAC_BIP: MCP4728T-E/UN bipolar DAC; MPN MCP4728T-E/UN; JLCPCB Part C478093
U_DAC_UNI: MCP4728T-E/UN unipolar DAC; MPN MCP4728T-E/UN; JLCPCB Part C478093
U_I2C_XLAT: PCA9306DCTR I2C translator; MPN PCA9306DCTR; JLCPCB Part C123752

Connections:
+3V3_DIGITAL: C_I2C_3V3.1, R_I2C_SCL_3V3.2, R_I2C_SDA_3V3.2, U_I2C_XLAT.2 (VREF1); also elsewhere on the board
+5V_ANALOG: C_DAC_BIP_10U.1, C_DAC_BIP_100N.1, C_DAC_UNI_10U.1, C_DAC_UNI_100N.1, C_I2C_5V.1, R_I2C_EN.2, R_I2C_SCL_5V.2, R_I2C_SDA_5V.2, U_DAC_BIP.1 (VDD), U_DAC_UNI.1 (VDD); also elsewhere on the board
BIP_DAC_BIAS_RAW: U_DAC_BIP.9 (VOUTD); also elsewhere on the board
BIP_DAC_X_RAW: U_DAC_BIP.6 (VOUTA); also elsewhere on the board
BIP_DAC_Y_RAW: U_DAC_BIP.7 (VOUTB); also elsewhere on the board
BIP_DAC_Z_RAW: U_DAC_BIP.8 (VOUTC); also elsewhere on the board
DAC_BIP_LDAC_5V: U_DAC_BIP.4 (~LDAC); also elsewhere on the board
DAC_BIP_RDY_N: U_DAC_BIP.5 (RDY/~BSY)
DAC_I2C_SCL_3V3: R_I2C_SCL_3V3.1, U_I2C_XLAT.3 (SCL1); also elsewhere on the board
DAC_I2C_SCL_5V: R_I2C_SCL_5V.1, U_DAC_BIP.2 (SCL), U_DAC_UNI.2 (SCL), U_I2C_XLAT.6 (SCL2); also elsewhere on the board
DAC_I2C_SDA_3V3: R_I2C_SDA_3V3.1, U_I2C_XLAT.4 (SDA1); also elsewhere on the board
DAC_I2C_SDA_5V: R_I2C_SDA_5V.1, U_DAC_BIP.3 (SDA), U_DAC_UNI.3 (SDA), U_I2C_XLAT.5 (SDA2); also elsewhere on the board
DAC_UNI_LDAC_5V: U_DAC_UNI.4 (~LDAC); also elsewhere on the board
DAC_UNI_RDY_N: U_DAC_UNI.5 (RDY/~BSY)
GND: C_DAC_BIP_10U.2, C_DAC_BIP_100N.2, C_DAC_UNI_10U.2, C_DAC_UNI_100N.2, C_I2C_3V3.2, C_I2C_5V.2, C_I2C_BIAS.2, U_DAC_BIP.10 (VSS), U_DAC_UNI.10 (VSS), U_I2C_XLAT.1 (GND); also elsewhere on the board
I2C_XLAT_BIAS: C_I2C_BIAS.1, R_I2C_EN.1, U_I2C_XLAT.7 (VREF2), U_I2C_XLAT.8 (EN)
UNI_DAC_D_SPARE: U_DAC_UNI.9 (VOUTD); also elsewhere on the board
UNI_DAC_X_RAW: U_DAC_UNI.6 (VOUTA); also elsewhere on the board
UNI_DAC_Y_RAW: U_DAC_UNI.7 (VOUTB); also elsewhere on the board
UNI_DAC_Z_RAW: U_DAC_UNI.8 (VOUTC); also elsewhere on the board

Notes on the sheet:
DAC I2C / RevC as-designed logical connections
Named global labels join sheets. Spare/RDY nets are intentional. USER DNP cross = customer fitted, omitted by PCBA.

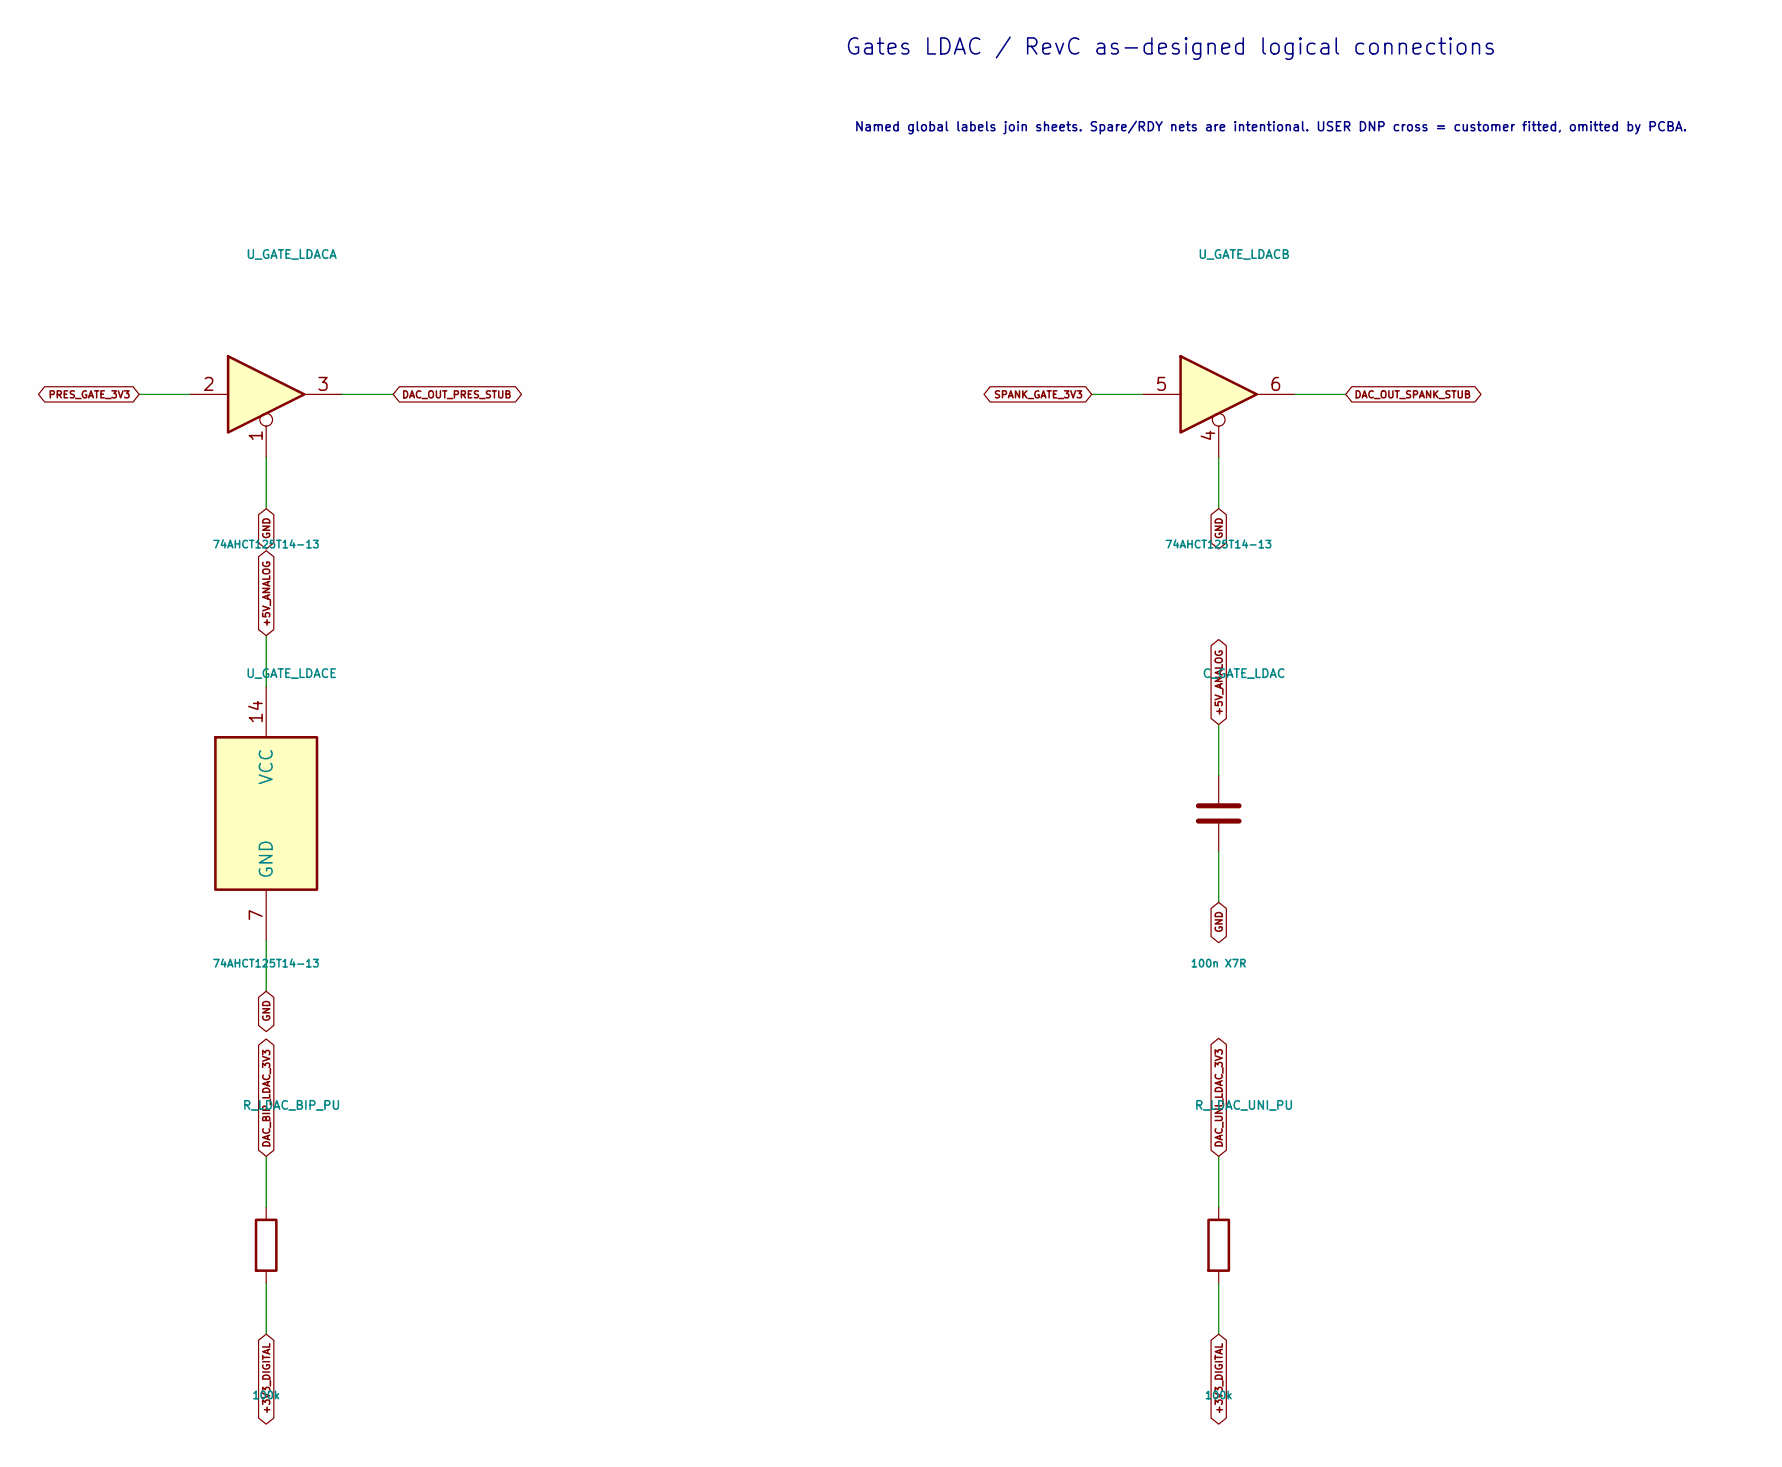
[picture p15: schematic bearcv-10hp-main_dualMCP4728_routed_DRC_pinremap_revc_Gates_LDAC.kicad_sch, part in row 1, column 1]

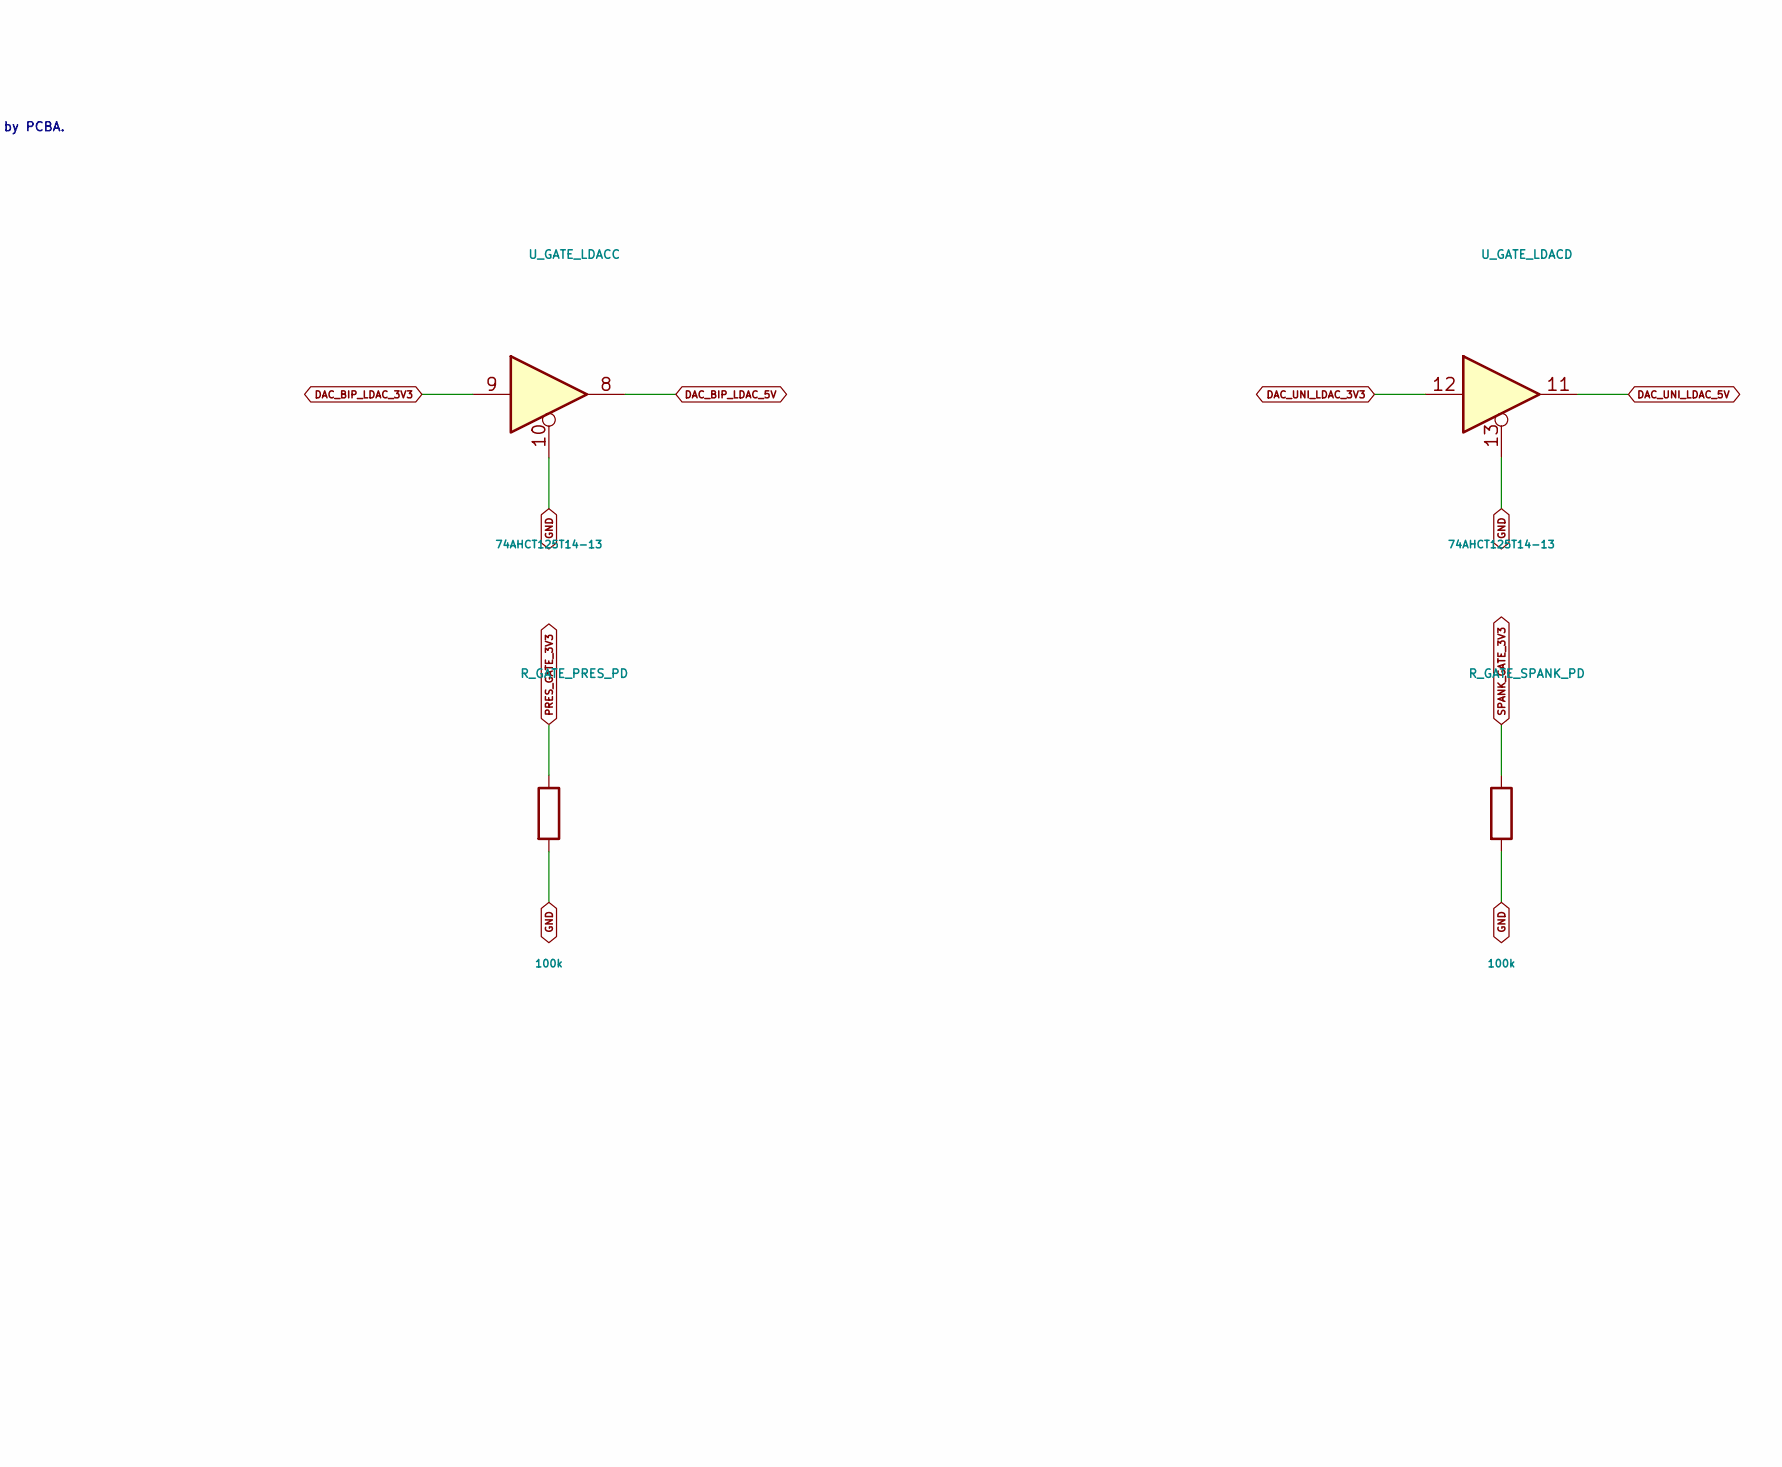
[picture p16: schematic bearcv-10hp-main_dualMCP4728_routed_DRC_pinremap_revc_Gates_LDAC.kicad_sch, part in row 1, column 2]

Parts:
C_GATE_LDAC: 100n X7R; MPN CC0603KRX7R9BB104; JLCPCB Part C14663
R_GATE_PRES_PD: 100k; MPN 0603WAF1003T5E; JLCPCB Part C25803
R_GATE_SPANK_PD: 100k; MPN 0603WAF1003T5E; JLCPCB Part C25803
R_LDAC_BIP_PU: 100k; MPN 0603WAF1003T5E; JLCPCB Part C25803
R_LDAC_UNI_PU: 100k; MPN 0603WAF1003T5E; JLCPCB Part C25803
U_GATE_LDAC: 74AHCT125T14-13; MPN 74AHCT125T14-13; JLCPCB Part C176917

Connections:
+3V3_DIGITAL: R_LDAC_BIP_PU.2, R_LDAC_UNI_PU.2; also elsewhere on the board
+5V_ANALOG: C_GATE_LDAC.1, U_GATE_LDAC.14 (VCC); also elsewhere on the board
DAC_BIP_LDAC_3V3: R_LDAC_BIP_PU.1, U_GATE_LDAC.9; also elsewhere on the board
DAC_BIP_LDAC_5V: U_GATE_LDAC.8; also elsewhere on the board
DAC_OUT_PRES_STUB: U_GATE_LDAC.3; also elsewhere on the board
DAC_OUT_SPANK_STUB: U_GATE_LDAC.6; also elsewhere on the board
DAC_UNI_LDAC_3V3: R_LDAC_UNI_PU.1, U_GATE_LDAC.12; also elsewhere on the board
DAC_UNI_LDAC_5V: U_GATE_LDAC.11; also elsewhere on the board
GND: C_GATE_LDAC.2, R_GATE_PRES_PD.2, R_GATE_SPANK_PD.2, U_GATE_LDAC.1, U_GATE_LDAC.4, U_GATE_LDAC.7 (GND), U_GATE_LDAC.10, U_GATE_LDAC.13; also elsewhere on the board
PRES_GATE_3V3: R_GATE_PRES_PD.1, U_GATE_LDAC.2; also elsewhere on the board
SPANK_GATE_3V3: R_GATE_SPANK_PD.1, U_GATE_LDAC.5; also elsewhere on the board

Notes on the sheet:
Gates LDAC / RevC as-designed logical connections
Named global labels join sheets. Spare/RDY nets are intentional. USER DNP cross = customer fitted, omitted by PCBA.
