actuallysparky/bearamin/bearamin-lite/hw/bearcv-10hp/bearcv-10hp-main_dualMCP4728_routed_DRC_pinremap_revc.kicad_pcb

## KiCad design bearamin-lite/hw/bearcv-10hp/bearcv-10hp-main_dualMCP4728_routed_DRC_pinremap_revc.kicad_pcb (continued)

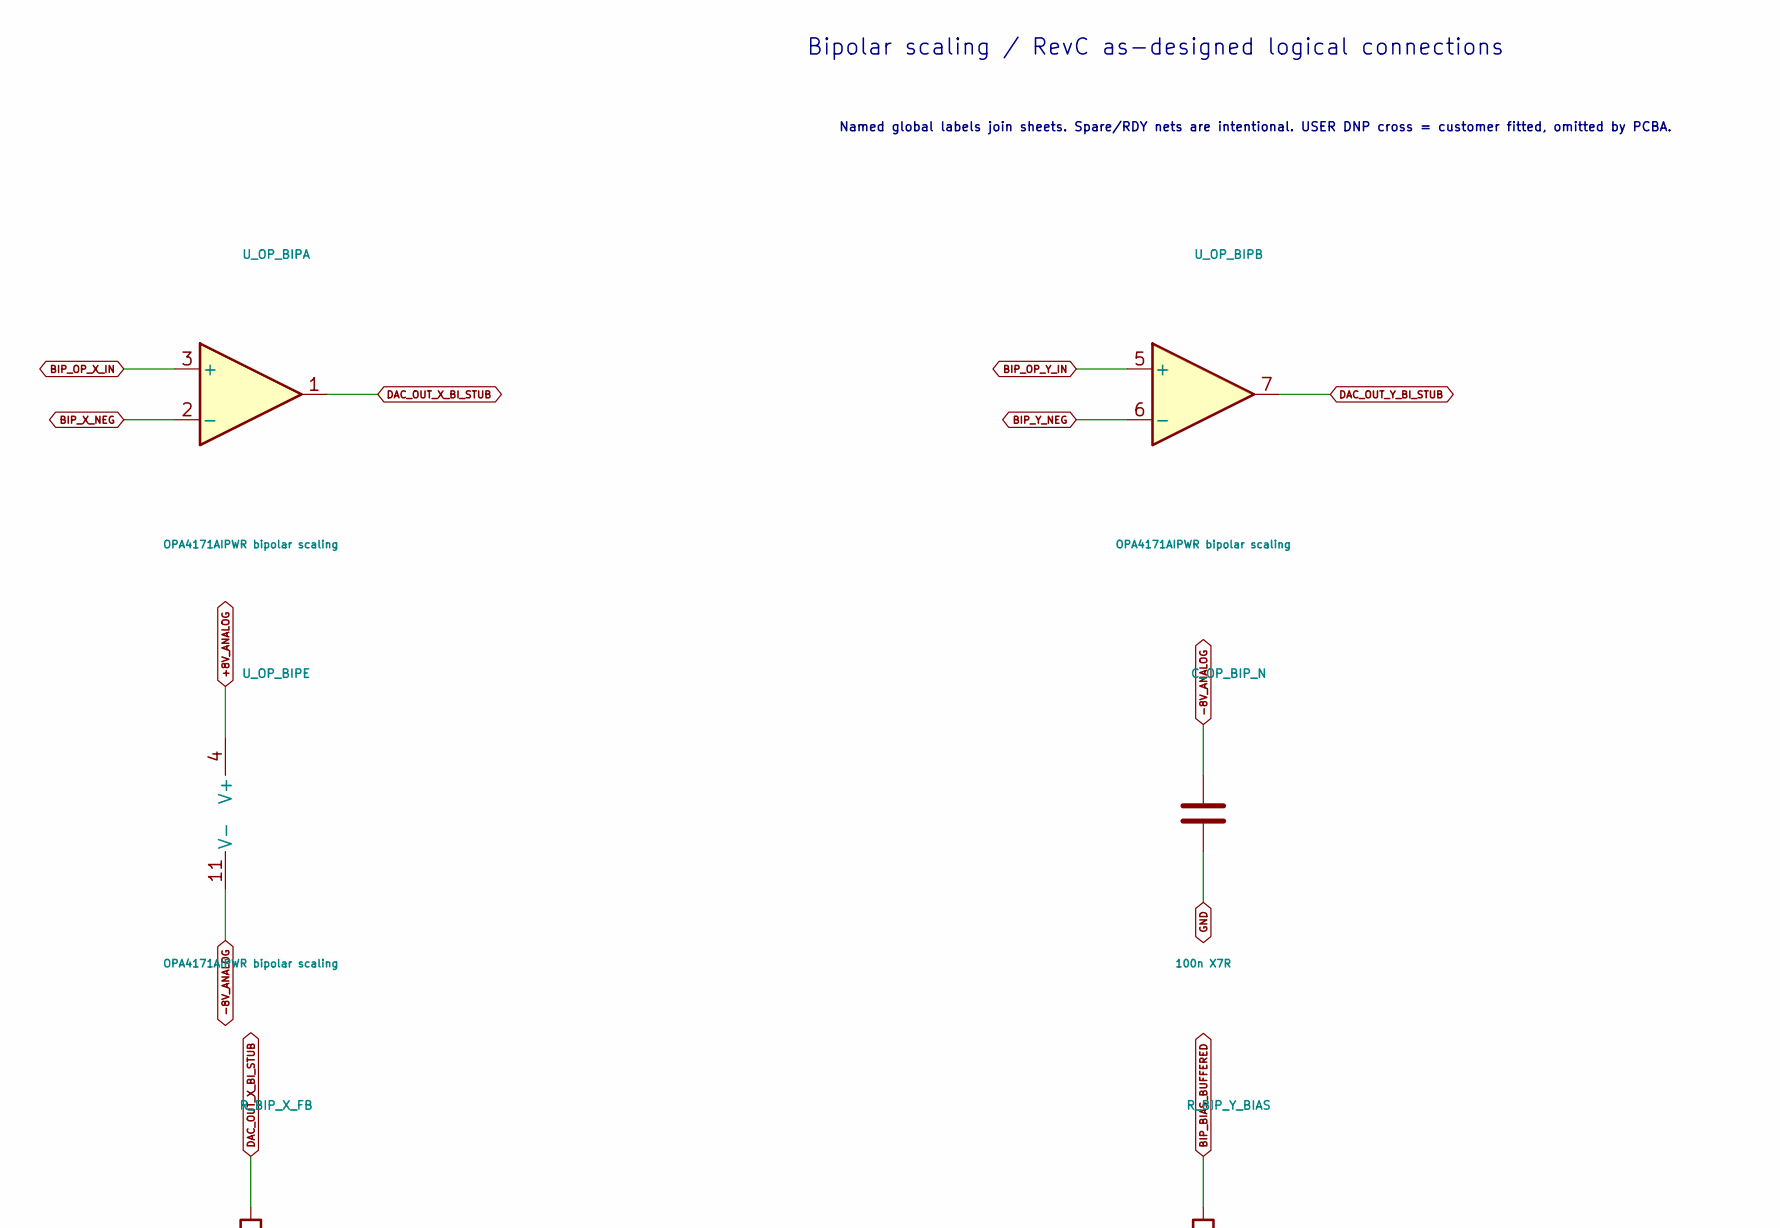
[picture p17: schematic bearcv-10hp-main_dualMCP4728_routed_DRC_pinremap_revc_Bipolar_scaling.kicad_sch, part in row 1, column 1]

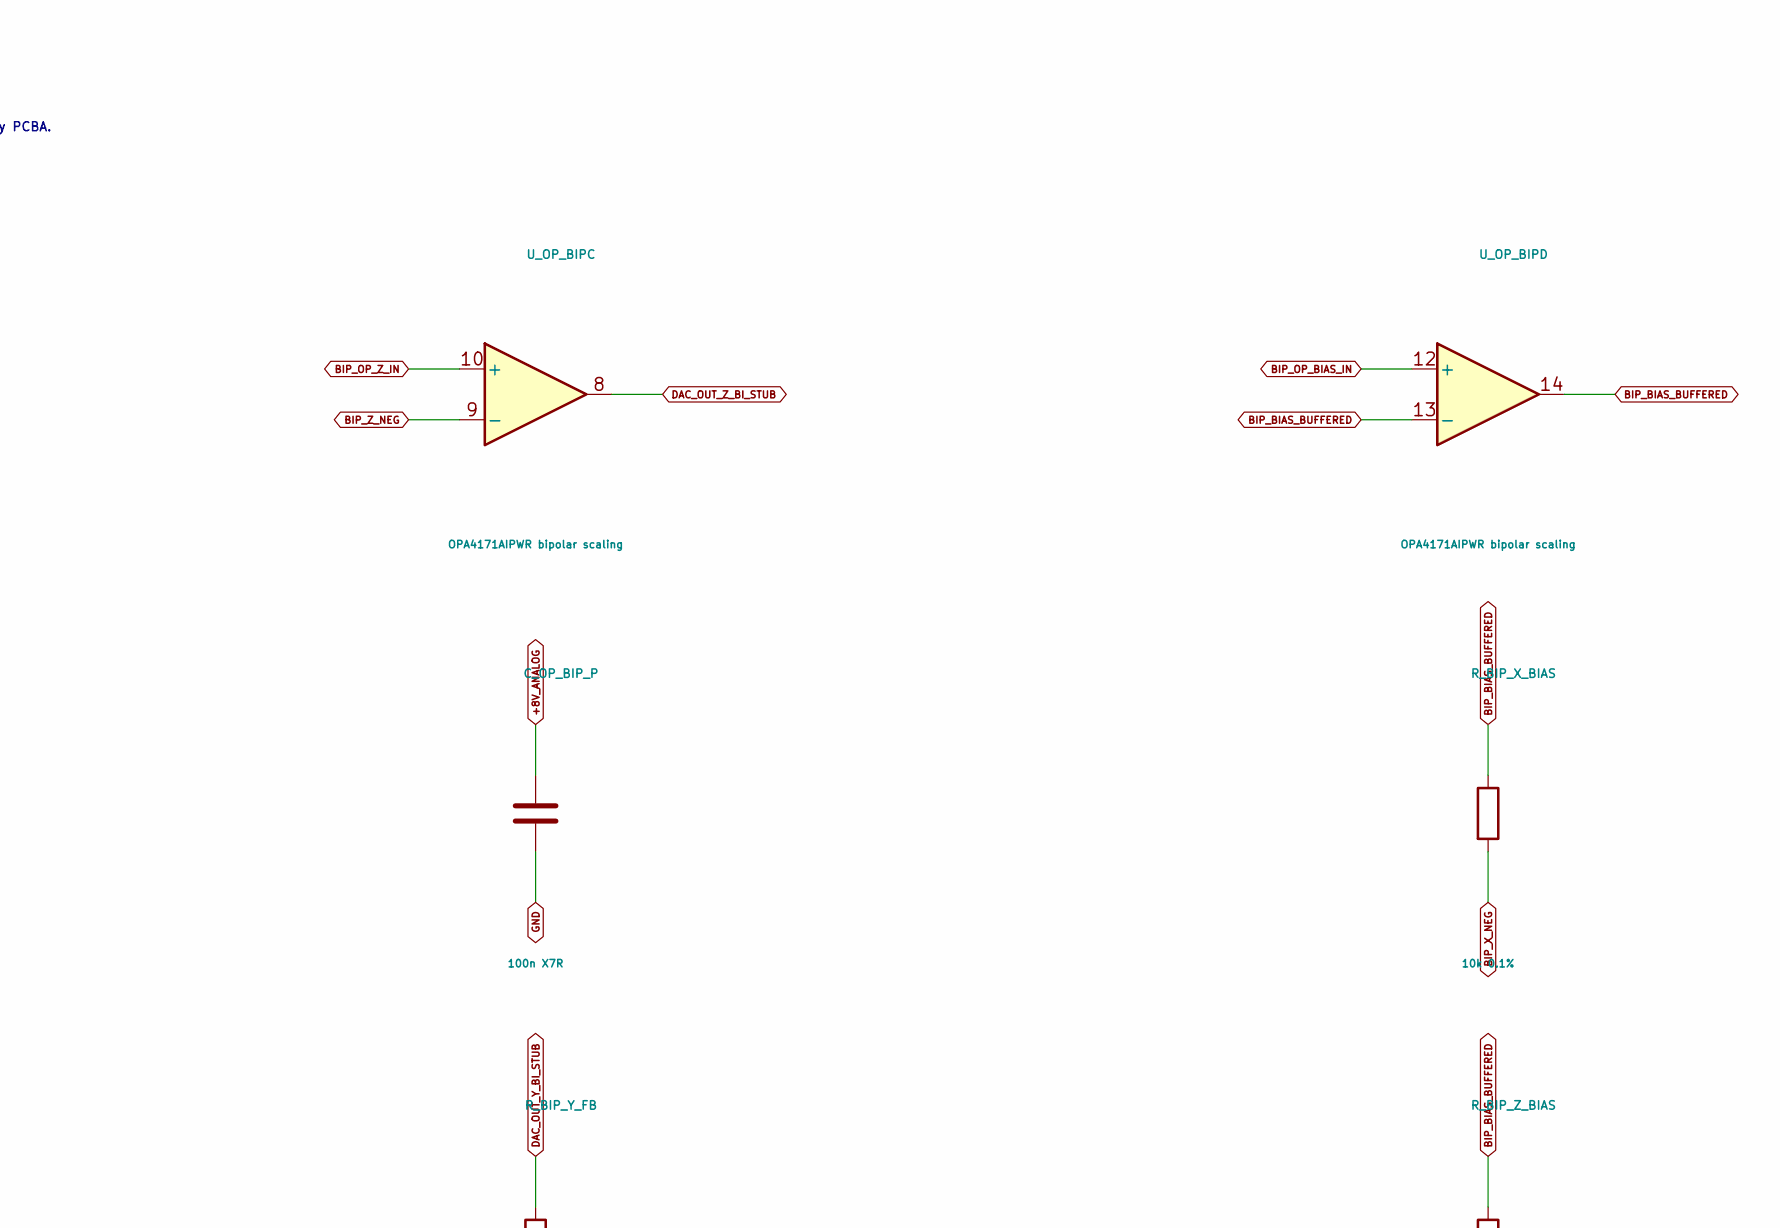
[picture p18: schematic bearcv-10hp-main_dualMCP4728_routed_DRC_pinremap_revc_Bipolar_scaling.kicad_sch, part in row 1, column 2]

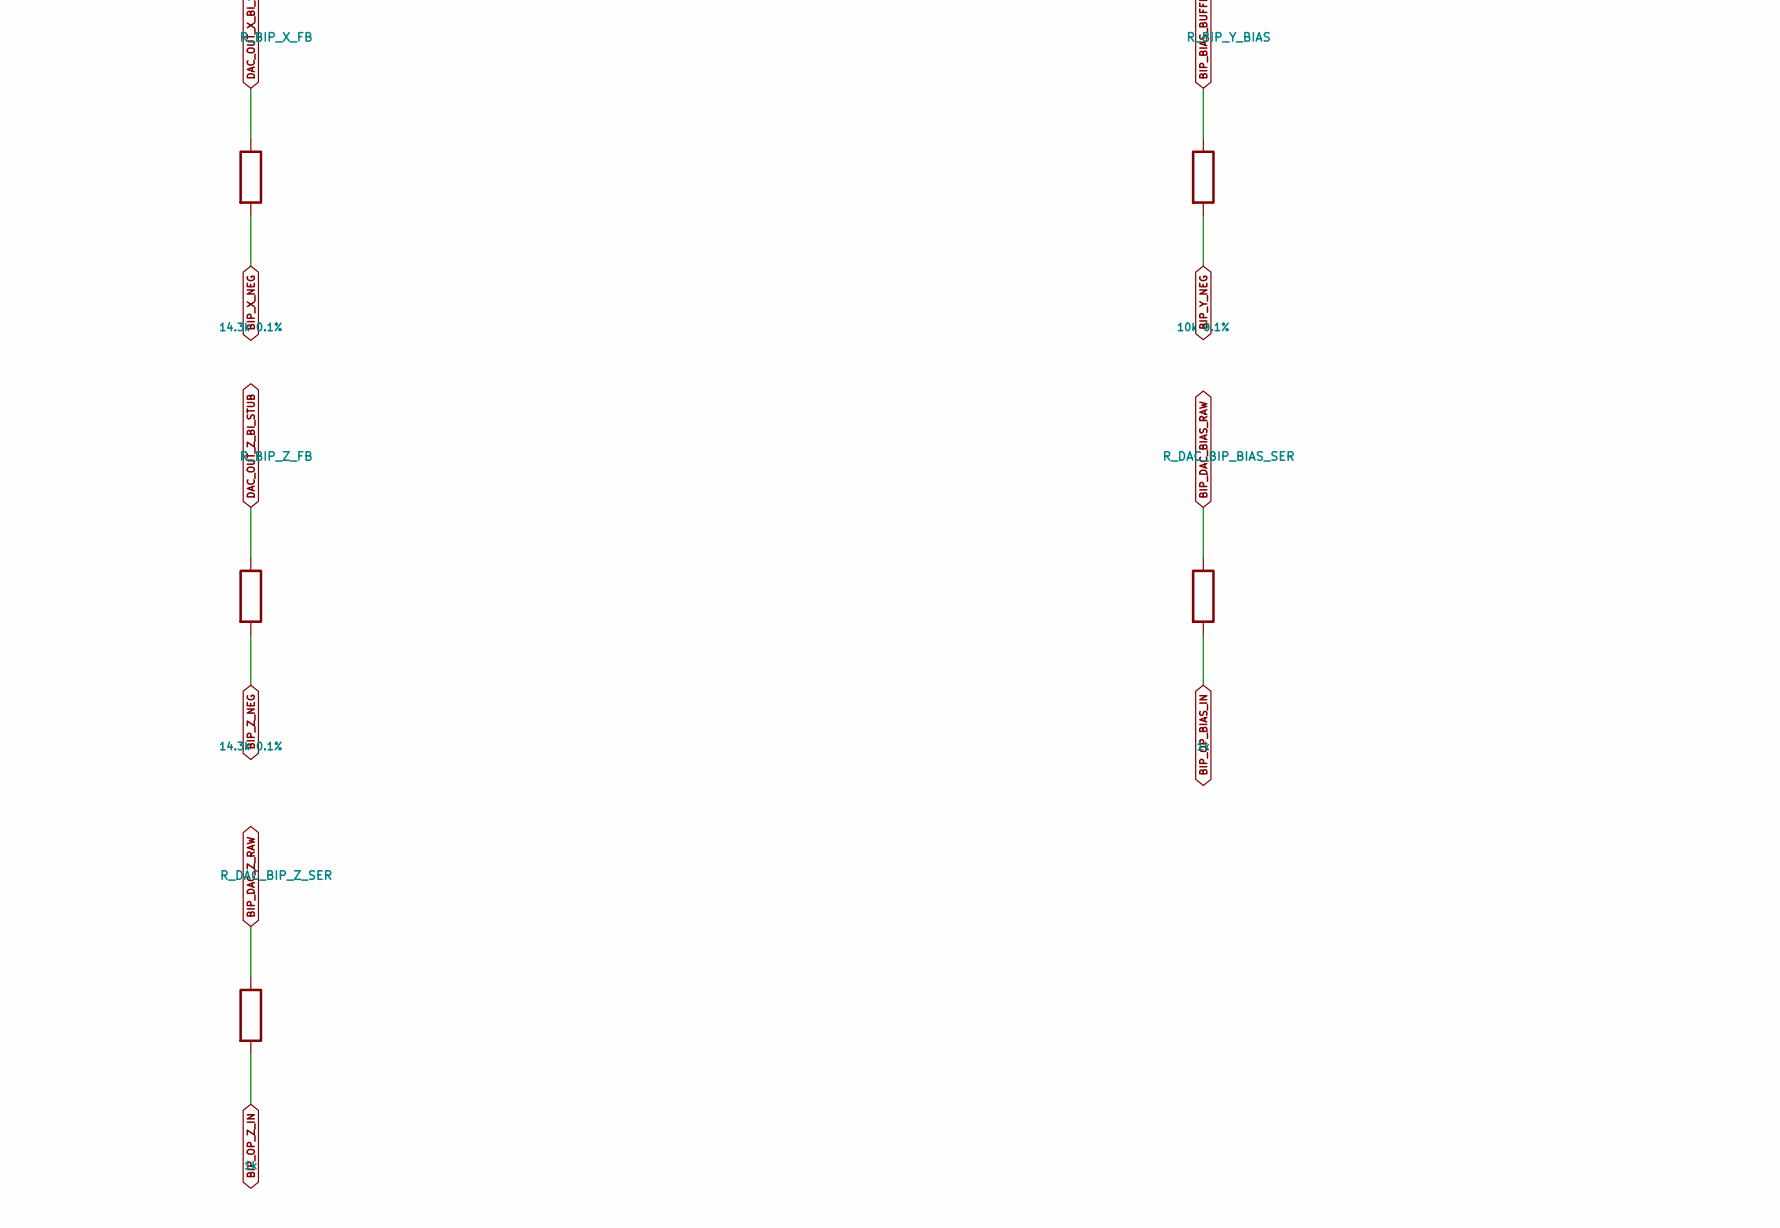
[picture p19: schematic bearcv-10hp-main_dualMCP4728_routed_DRC_pinremap_revc_Bipolar_scaling.kicad_sch, part in row 2, column 1]

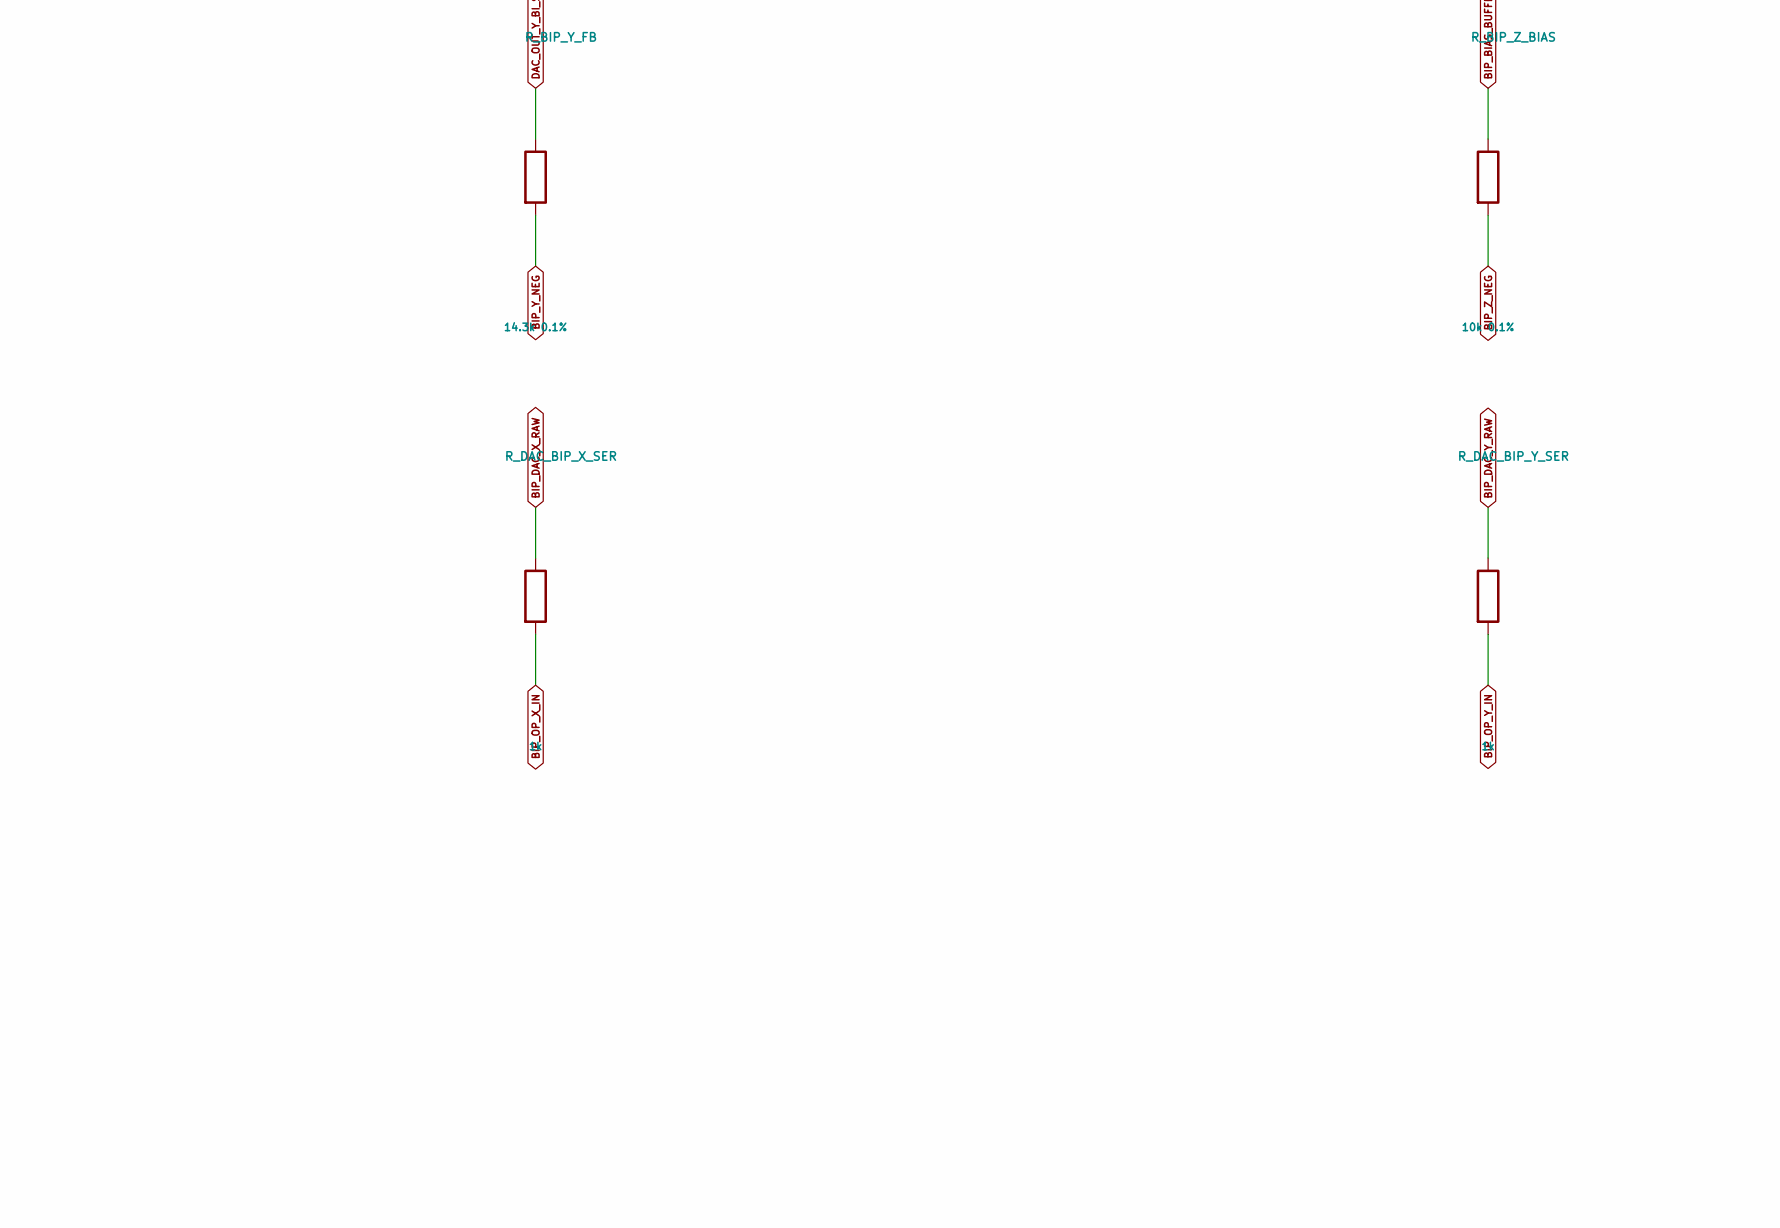
[picture p20: schematic bearcv-10hp-main_dualMCP4728_routed_DRC_pinremap_revc_Bipolar_scaling.kicad_sch, part in row 2, column 2]

Parts:
C_OP_BIP_N: 100n X7R; MPN CC0603KRX7R9BB104; JLCPCB Part C14663
C_OP_BIP_P: 100n X7R; MPN CC0603KRX7R9BB104; JLCPCB Part C14663
R_BIP_X_BIAS: 10k 0.1%; MPN RT0603BRD0710KL; JLCPCB Library Extended
R_BIP_X_FB: 14.3k 0.1%; MPN RT0603BRE0714K3L; JLCPCB Library Extended
R_BIP_Y_BIAS: 10k 0.1%; MPN RT0603BRD0710KL; JLCPCB Library Extended
R_BIP_Y_FB: 14.3k 0.1%; MPN RT0603BRE0714K3L; JLCPCB Library Extended
R_BIP_Z_BIAS: 10k 0.1%; MPN RT0603BRD0710KL; JLCPCB Library Extended
R_BIP_Z_FB: 14.3k 0.1%; MPN RT0603BRE0714K3L; JLCPCB Library Extended
R_DAC_BIP_BIAS_SER: 1k; MPN 0603WAF1001T5E; JLCPCB Part C21190
R_DAC_BIP_X_SER: 1k; MPN 0603WAF1001T5E; JLCPCB Part C21190
R_DAC_BIP_Y_SER: 1k; MPN 0603WAF1001T5E; JLCPCB Part C21190
R_DAC_BIP_Z_SER: 1k; MPN 0603WAF1001T5E; JLCPCB Part C21190
U_OP_BIP: OPA4171AIPWR bipolar scaling; MPN OPA4171AIPWR; JLCPCB Part C529553

Connections:
+8V_ANALOG: C_OP_BIP_P.1, U_OP_BIP.4 (V+); also elsewhere on the board
-8V_ANALOG: C_OP_BIP_N.1, U_OP_BIP.11 (V-); also elsewhere on the board
BIP_BIAS_BUFFERED: R_BIP_X_BIAS.1, R_BIP_Y_BIAS.1, R_BIP_Z_BIAS.1, U_OP_BIP.13 (-), U_OP_BIP.14
BIP_DAC_BIAS_RAW: R_DAC_BIP_BIAS_SER.1; also elsewhere on the board
BIP_DAC_X_RAW: R_DAC_BIP_X_SER.1; also elsewhere on the board
BIP_DAC_Y_RAW: R_DAC_BIP_Y_SER.1; also elsewhere on the board
BIP_DAC_Z_RAW: R_DAC_BIP_Z_SER.1; also elsewhere on the board
BIP_OP_BIAS_IN: R_DAC_BIP_BIAS_SER.2, U_OP_BIP.12 (+)
BIP_OP_X_IN: R_DAC_BIP_X_SER.2, U_OP_BIP.3 (+)
BIP_OP_Y_IN: R_DAC_BIP_Y_SER.2, U_OP_BIP.5 (+)
BIP_OP_Z_IN: R_DAC_BIP_Z_SER.2, U_OP_BIP.10 (+)
BIP_X_NEG: R_BIP_X_BIAS.2, R_BIP_X_FB.2, U_OP_BIP.2 (-)
BIP_Y_NEG: R_BIP_Y_BIAS.2, R_BIP_Y_FB.2, U_OP_BIP.6 (-)
BIP_Z_NEG: R_BIP_Z_BIAS.2, R_BIP_Z_FB.2, U_OP_BIP.9 (-)
DAC_OUT_X_BI_STUB: R_BIP_X_FB.1, U_OP_BIP.1; also elsewhere on the board
DAC_OUT_Y_BI_STUB: R_BIP_Y_FB.1, U_OP_BIP.7; also elsewhere on the board
DAC_OUT_Z_BI_STUB: R_BIP_Z_FB.1, U_OP_BIP.8; also elsewhere on the board
GND: C_OP_BIP_N.2, C_OP_BIP_P.2; also elsewhere on the board

Notes on the sheet:
Bipolar scaling / RevC as-designed logical connections
Named global labels join sheets. Spare/RDY nets are intentional. USER DNP cross = customer fitted, omitted by PCBA.

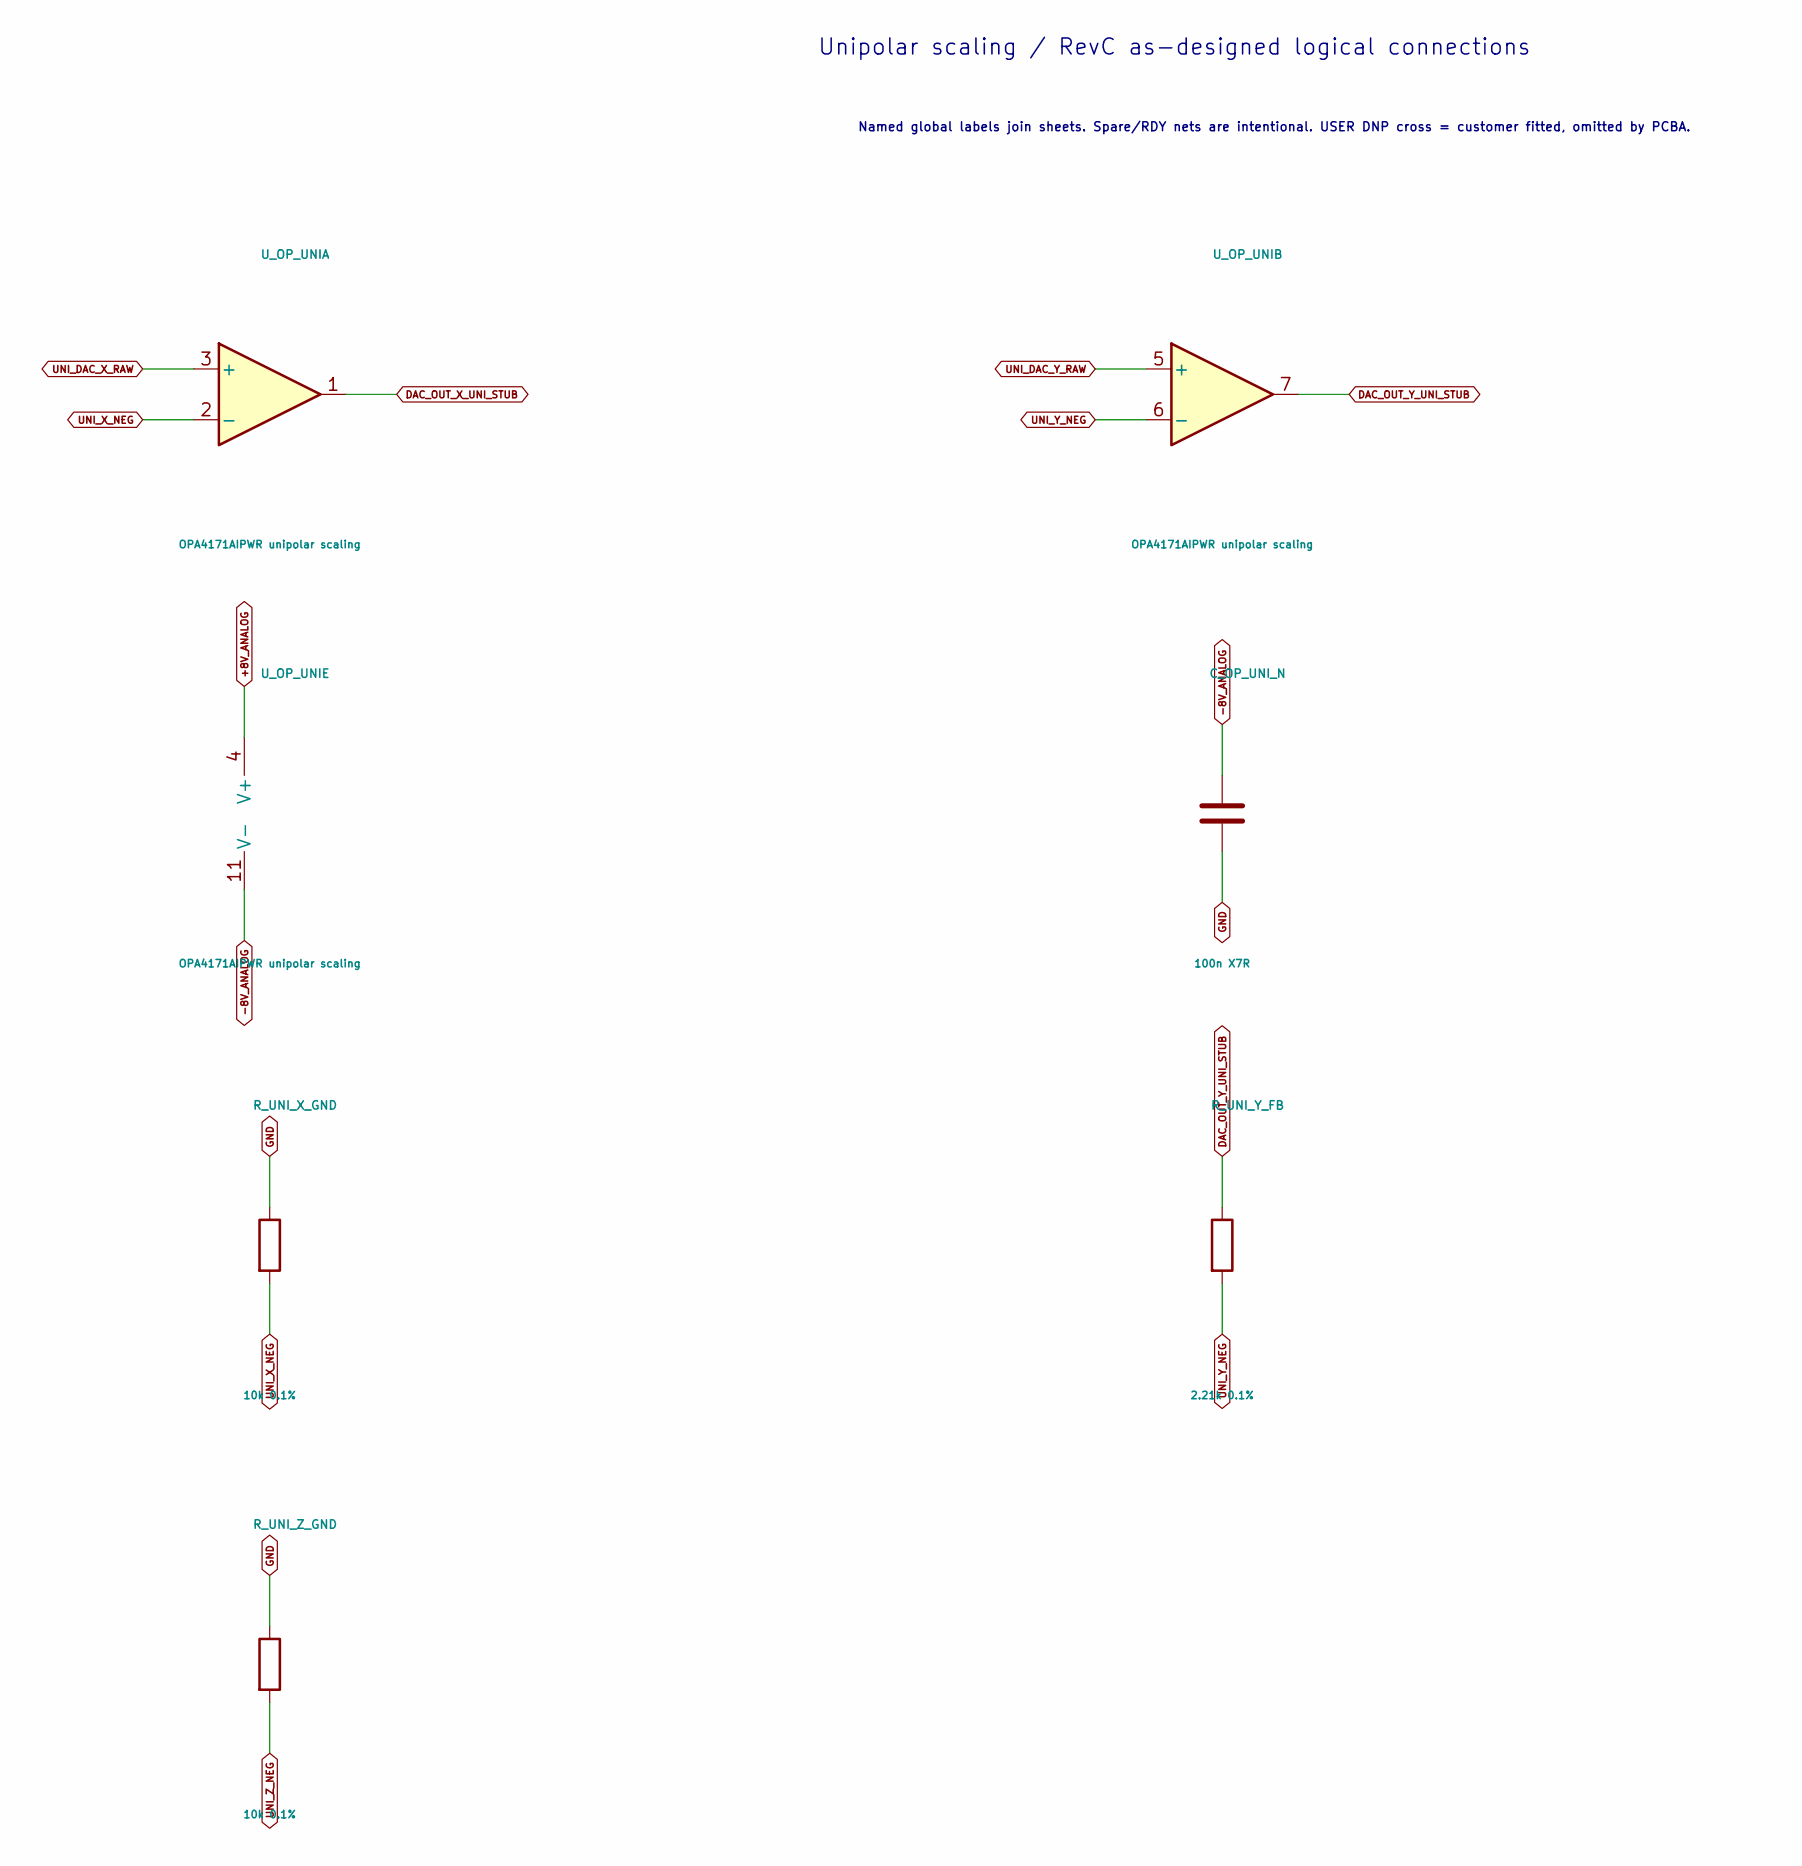
[picture p21: schematic bearcv-10hp-main_dualMCP4728_routed_DRC_pinremap_revc_Unipolar_scaling.kicad_sch, part in row 1, column 1]

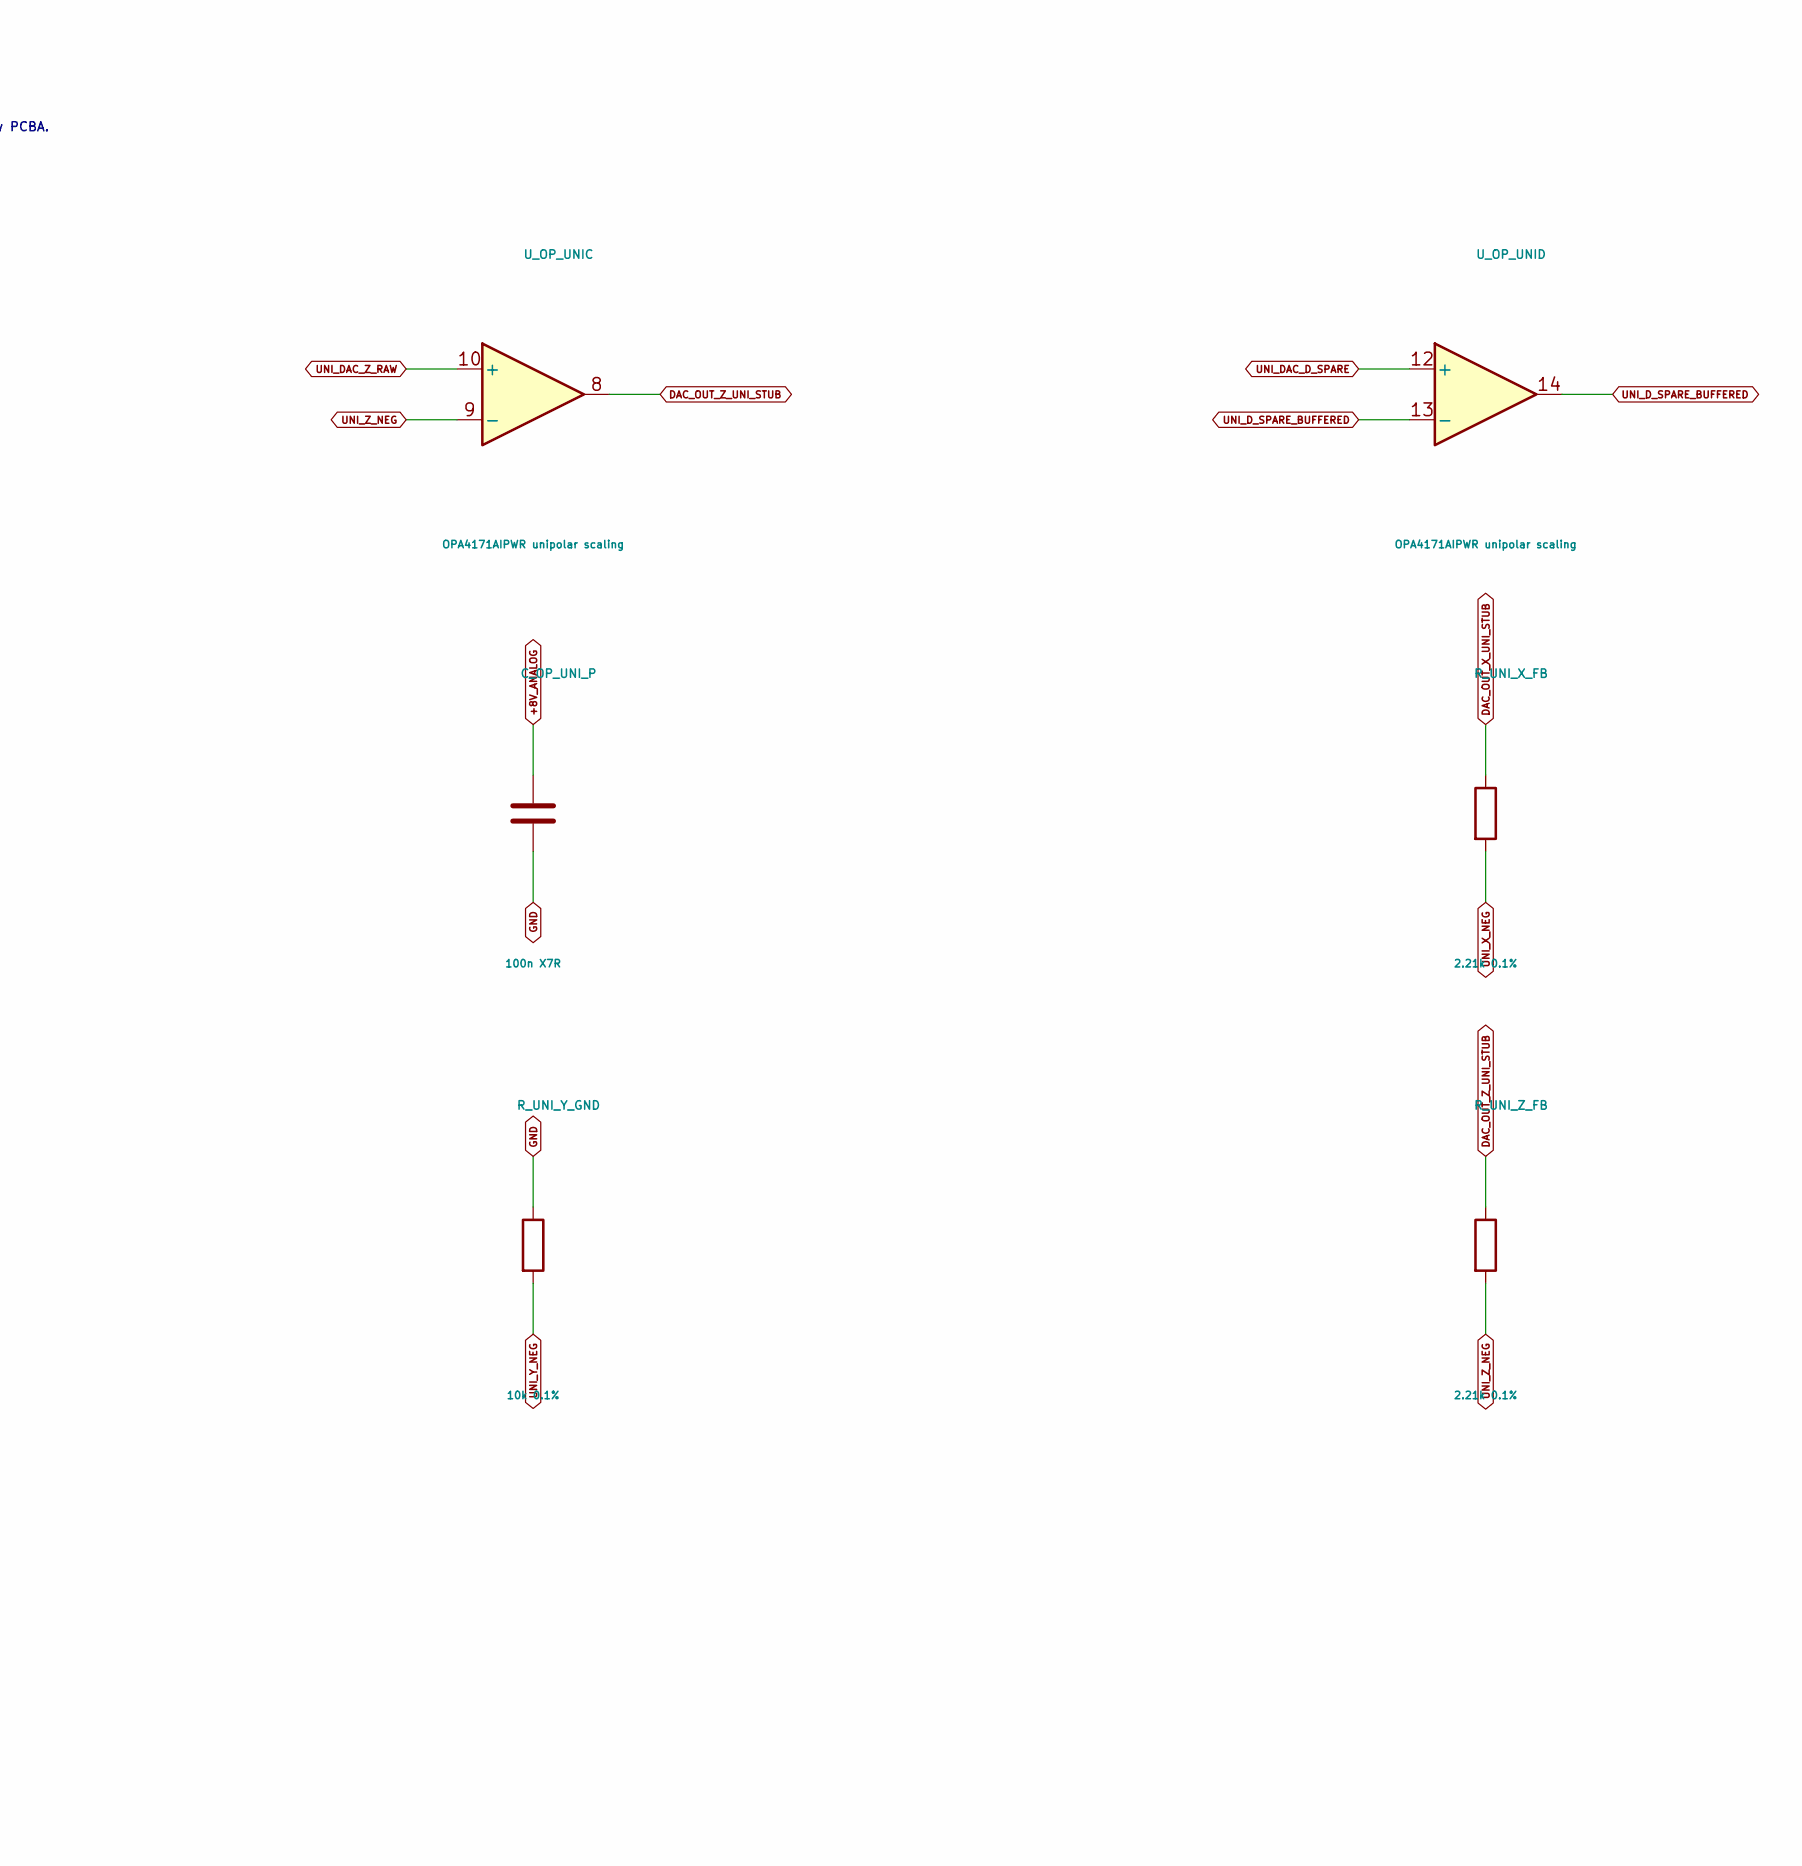
[picture p22: schematic bearcv-10hp-main_dualMCP4728_routed_DRC_pinremap_revc_Unipolar_scaling.kicad_sch, part in row 1, column 2]

Parts:
C_OP_UNI_N: 100n X7R; MPN CC0603KRX7R9BB104; JLCPCB Part C14663
C_OP_UNI_P: 100n X7R; MPN CC0603KRX7R9BB104; JLCPCB Part C14663
R_UNI_X_FB: 2.21k 0.1%; MPN RT0603BRD072K21L; JLCPCB Library Extended
R_UNI_X_GND: 10k 0.1%; MPN RT0603BRD0710KL; JLCPCB Library Extended
R_UNI_Y_FB: 2.21k 0.1%; MPN RT0603BRD072K21L; JLCPCB Library Extended
R_UNI_Y_GND: 10k 0.1%; MPN RT0603BRD0710KL; JLCPCB Library Extended
R_UNI_Z_FB: 2.21k 0.1%; MPN RT0603BRD072K21L; JLCPCB Library Extended
R_UNI_Z_GND: 10k 0.1%; MPN RT0603BRD0710KL; JLCPCB Library Extended
U_OP_UNI: OPA4171AIPWR unipolar scaling; MPN OPA4171AIPWR; JLCPCB Part C529553

Connections:
+8V_ANALOG: C_OP_UNI_P.1, U_OP_UNI.4 (V+); also elsewhere on the board
-8V_ANALOG: C_OP_UNI_N.1, U_OP_UNI.11 (V-); also elsewhere on the board
DAC_OUT_X_UNI_STUB: R_UNI_X_FB.1, U_OP_UNI.1; also elsewhere on the board
DAC_OUT_Y_UNI_STUB: R_UNI_Y_FB.1, U_OP_UNI.7; also elsewhere on the board
DAC_OUT_Z_UNI_STUB: R_UNI_Z_FB.1, U_OP_UNI.8; also elsewhere on the board
GND: C_OP_UNI_N.2, C_OP_UNI_P.2, R_UNI_X_GND.1, R_UNI_Y_GND.1, R_UNI_Z_GND.1; also elsewhere on the board
UNI_DAC_D_SPARE: U_OP_UNI.12 (+); also elsewhere on the board
UNI_DAC_X_RAW: U_OP_UNI.3 (+); also elsewhere on the board
UNI_DAC_Y_RAW: U_OP_UNI.5 (+); also elsewhere on the board
UNI_DAC_Z_RAW: U_OP_UNI.10 (+); also elsewhere on the board
UNI_D_SPARE_BUFFERED: U_OP_UNI.13 (-), U_OP_UNI.14
UNI_X_NEG: R_UNI_X_FB.2, R_UNI_X_GND.2, U_OP_UNI.2 (-)
UNI_Y_NEG: R_UNI_Y_FB.2, R_UNI_Y_GND.2, U_OP_UNI.6 (-)
UNI_Z_NEG: R_UNI_Z_FB.2, R_UNI_Z_GND.2, U_OP_UNI.9 (-)

Notes on the sheet:
Unipolar scaling / RevC as-designed logical connections
Named global labels join sheets. Spare/RDY nets are intentional. USER DNP cross = customer fitted, omitted by PCBA.
