actuallysparky/bearamin/bearamin-lite/hw/bearcv-10hp/bearcv-10hp-main_dualMCP4728_routed_DRC_pinremap_revc.kicad_pcb

## KiCad design bearamin-lite/hw/bearcv-10hp/bearcv-10hp-main_dualMCP4728_routed_DRC_pinremap_revc.kicad_pcb (continued)

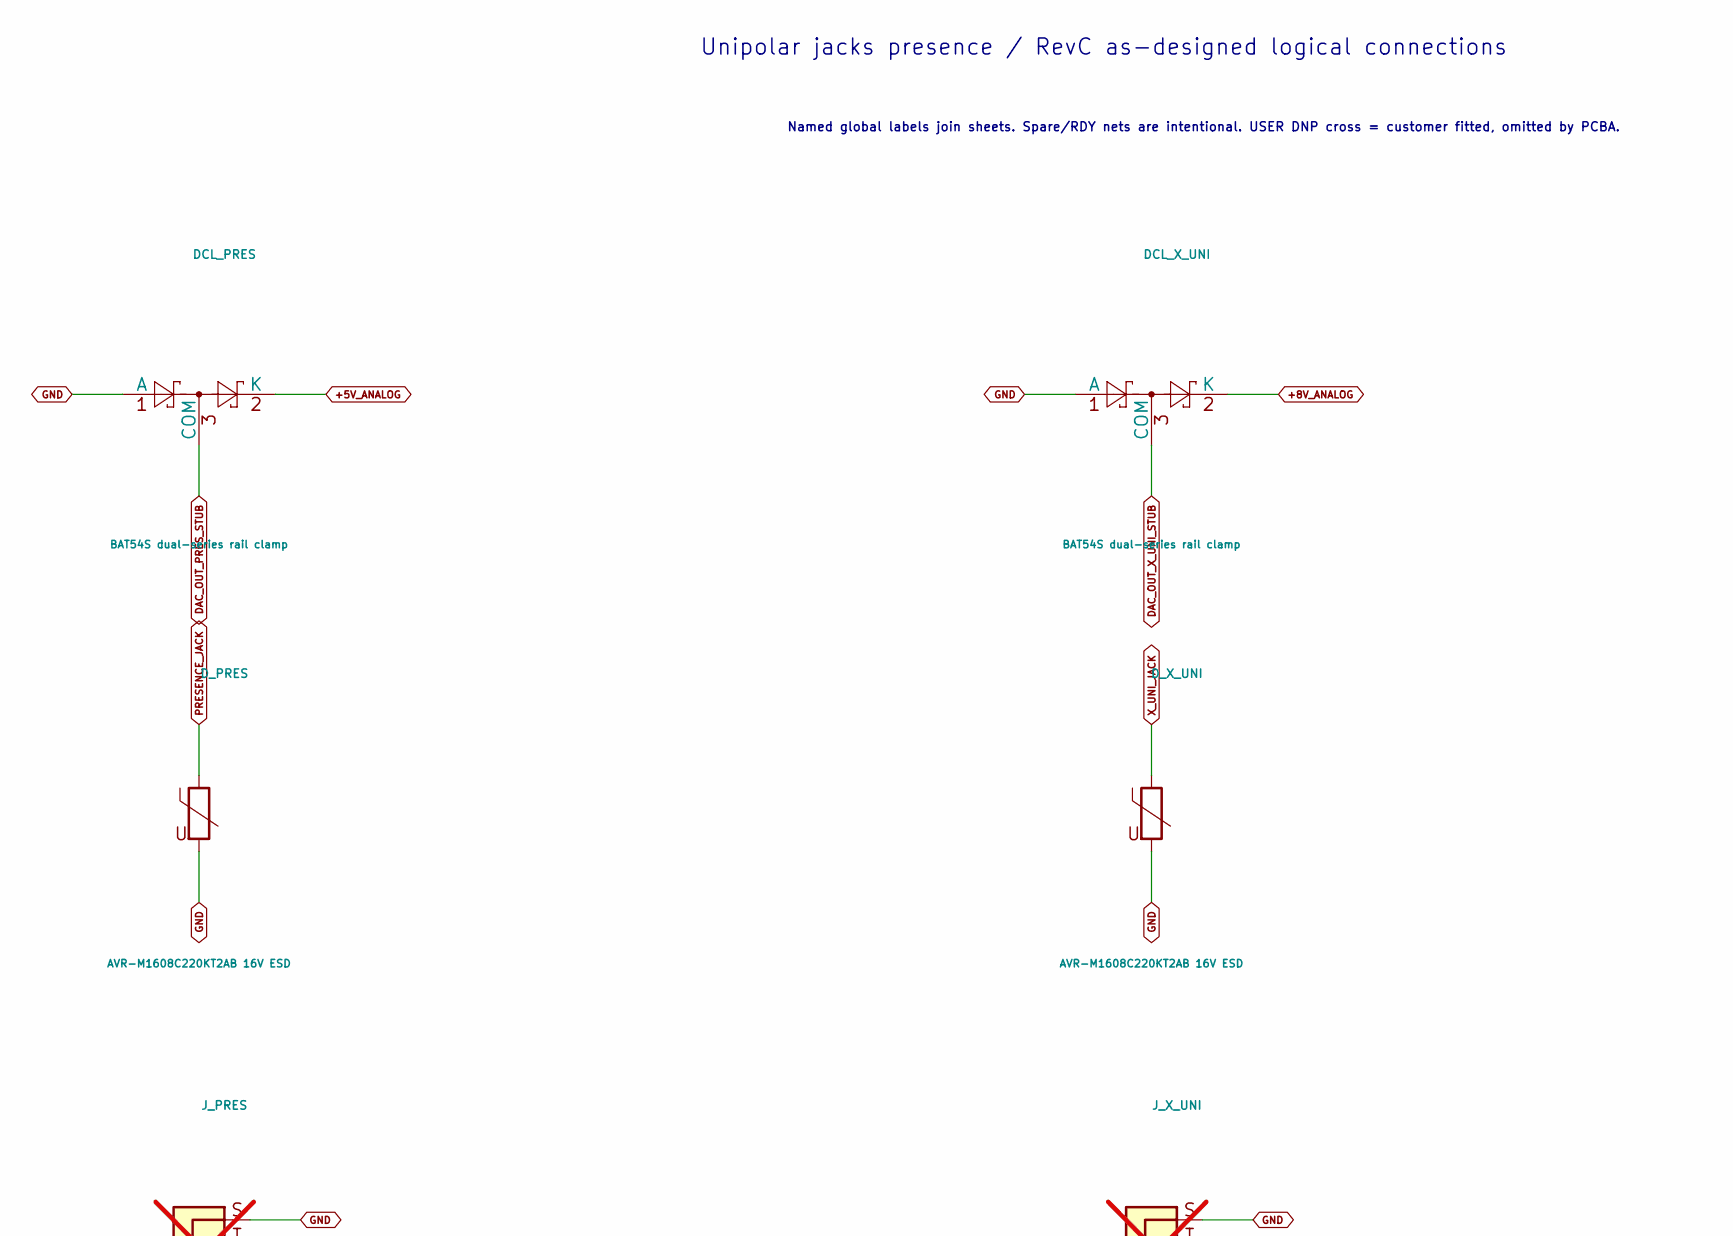
[picture p23: schematic bearcv-10hp-main_dualMCP4728_routed_DRC_pinremap_revc_Unipolar_jacks_presence.kicad_sch, part in row 1, column 1]

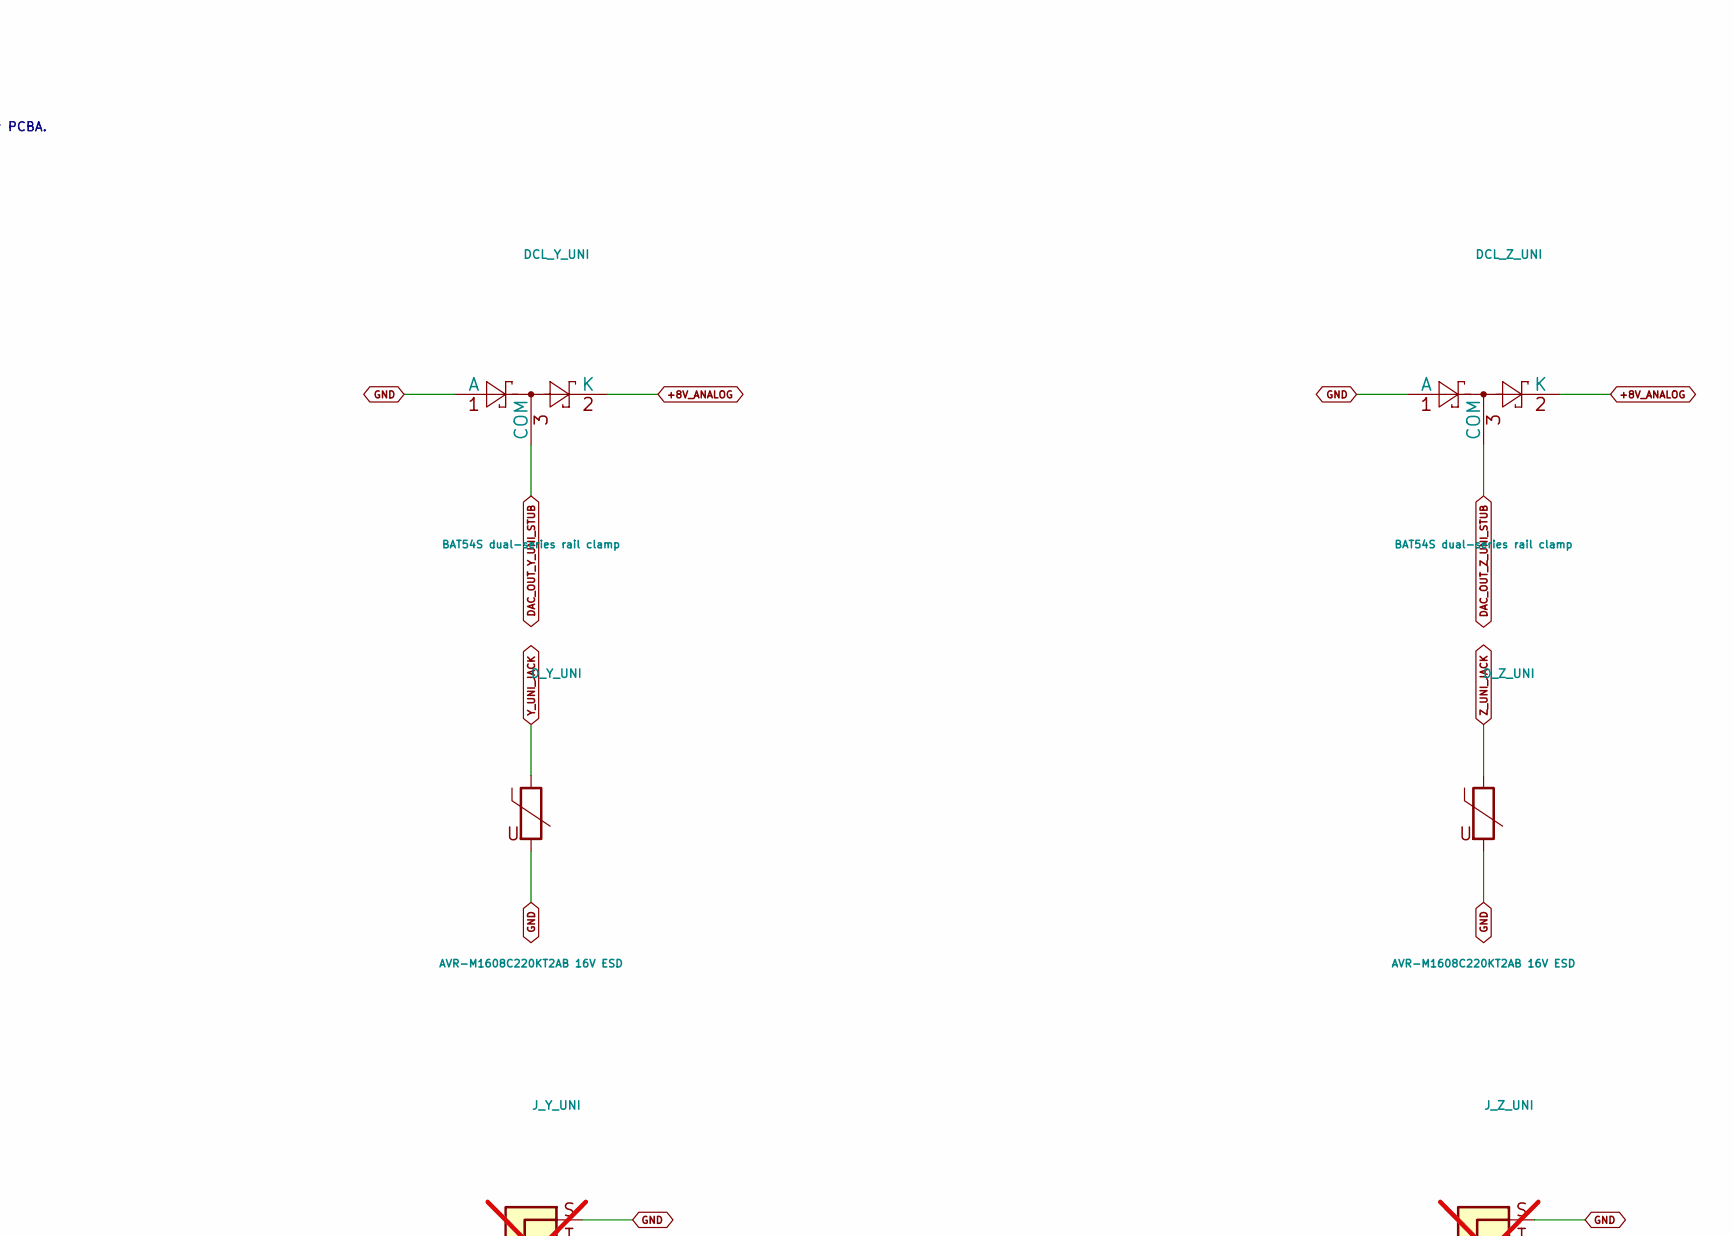
[picture p24: schematic bearcv-10hp-main_dualMCP4728_routed_DRC_pinremap_revc_Unipolar_jacks_presence.kicad_sch, part in row 1, column 2]

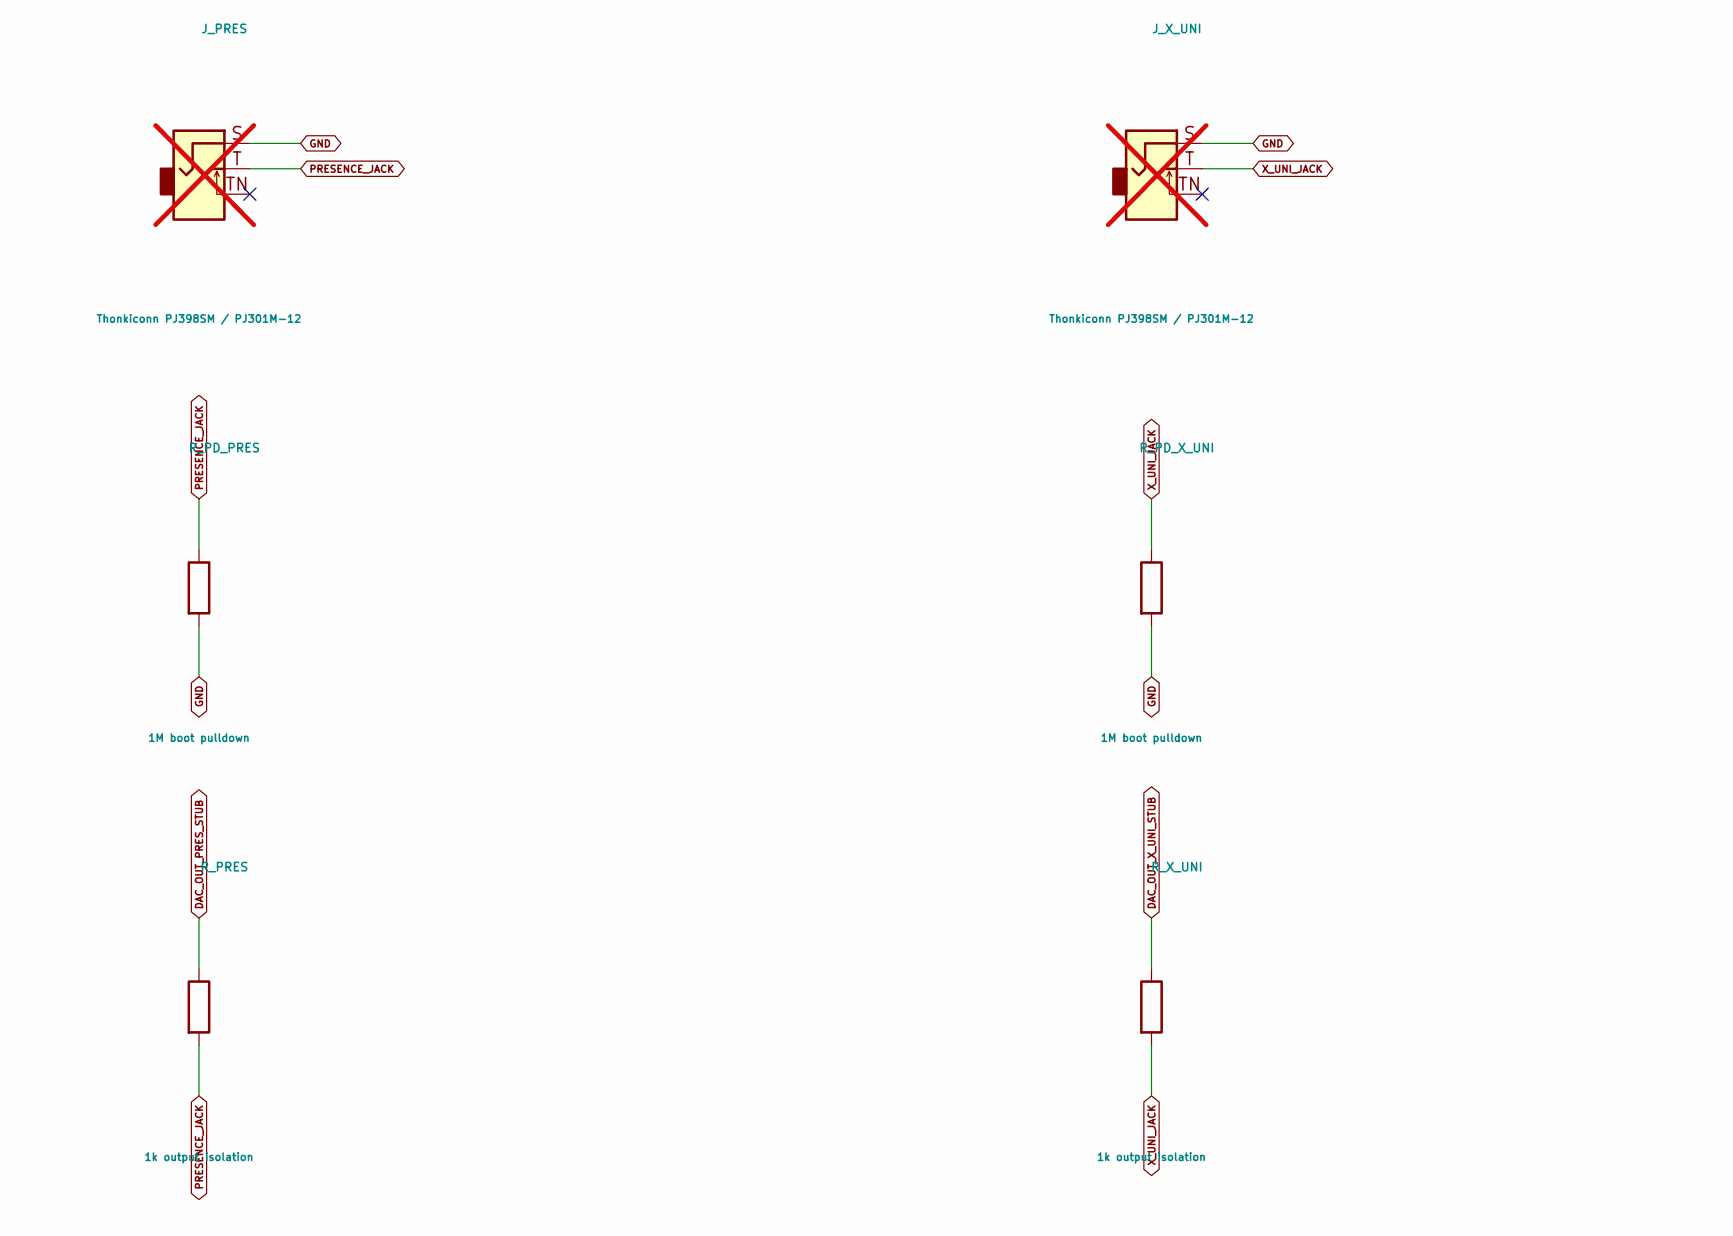
[picture p25: schematic bearcv-10hp-main_dualMCP4728_routed_DRC_pinremap_revc_Unipolar_jacks_presence.kicad_sch, part in row 2, column 1]

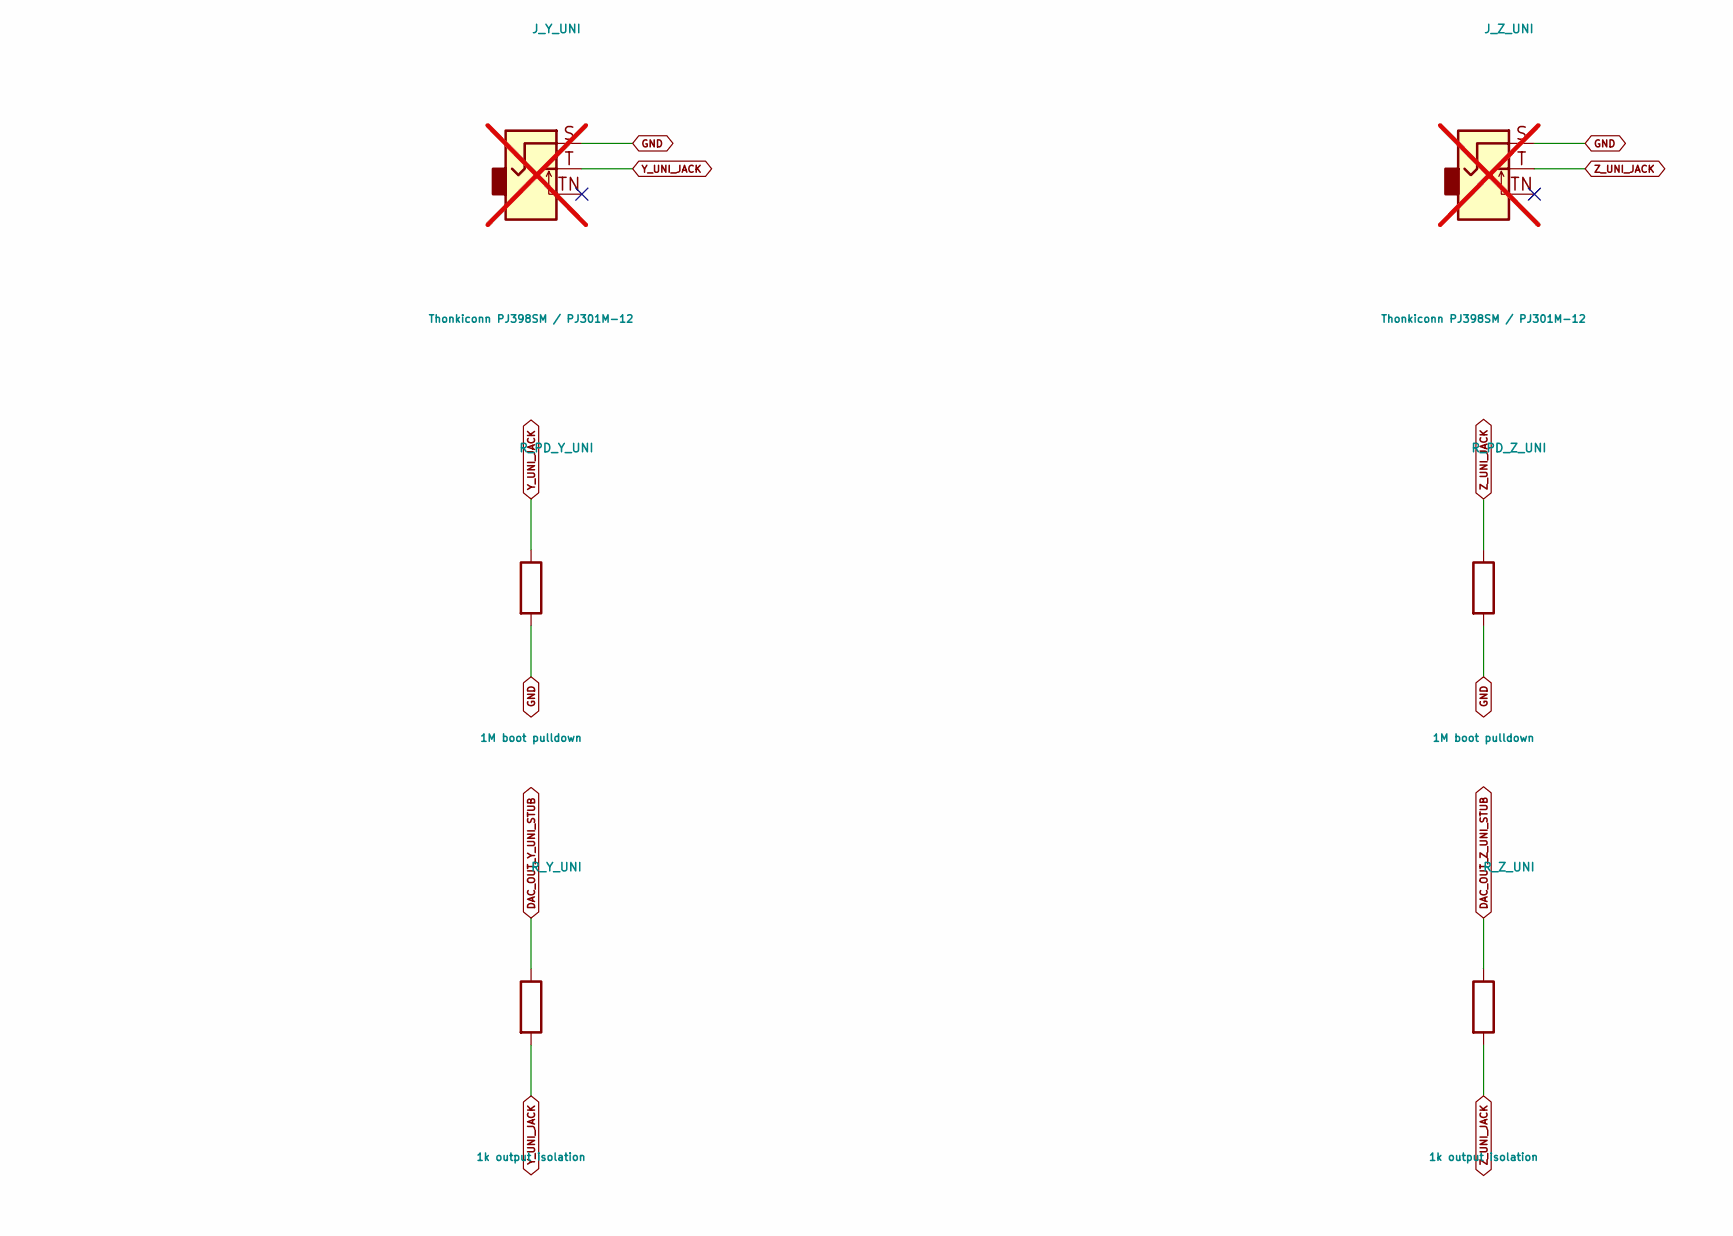
[picture p26: schematic bearcv-10hp-main_dualMCP4728_routed_DRC_pinremap_revc_Unipolar_jacks_presence.kicad_sch, part in row 2, column 2]

Parts:
DCL_PRES: BAT54S dual-series rail clamp; MPN BAT54S-7-F; JLCPCB Part C83574
DCL_X_UNI: BAT54S dual-series rail clamp; MPN BAT54S-7-F; JLCPCB Part C83574
DCL_Y_UNI: BAT54S dual-series rail clamp; MPN BAT54S-7-F; JLCPCB Part C83574
DCL_Z_UNI: BAT54S dual-series rail clamp; MPN BAT54S-7-F; JLCPCB Part C83574
D_PRES: AVR-M1608C220KT2AB 16V ESD; MPN AVR-M1608C220KT2AB; JLCPCB Library Extended
D_X_UNI: AVR-M1608C220KT2AB 16V ESD; MPN AVR-M1608C220KT2AB; JLCPCB Library Extended
D_Y_UNI: AVR-M1608C220KT2AB 16V ESD; MPN AVR-M1608C220KT2AB; JLCPCB Library Extended
D_Z_UNI: AVR-M1608C220KT2AB 16V ESD; MPN AVR-M1608C220KT2AB; JLCPCB Library Extended
J_PRES: Thonkiconn PJ398SM / PJ301M-12; Jack_3.5mm_QingPu_WQP-PJ398SM_Vertical_CircularHoles; MPN DNP; not fitted
J_X_UNI: Thonkiconn PJ398SM / PJ301M-12; Jack_3.5mm_QingPu_WQP-PJ398SM_Vertical_CircularHoles; MPN DNP; not fitted
J_Y_UNI: Thonkiconn PJ398SM / PJ301M-12; Jack_3.5mm_QingPu_WQP-PJ398SM_Vertical_CircularHoles; MPN DNP; not fitted
J_Z_UNI: Thonkiconn PJ398SM / PJ301M-12; Jack_3.5mm_QingPu_WQP-PJ398SM_Vertical_CircularHoles; MPN DNP; not fitted
R_PD_PRES: 1M boot pulldown; MPN 0603WAF1004T5E; JLCPCB Part C22935
R_PD_X_UNI: 1M boot pulldown; MPN 0603WAF1004T5E; JLCPCB Part C22935
R_PD_Y_UNI: 1M boot pulldown; MPN 0603WAF1004T5E; JLCPCB Part C22935
R_PD_Z_UNI: 1M boot pulldown; MPN 0603WAF1004T5E; JLCPCB Part C22935
R_PRES: 1k output isolation; MPN 0603WAF1001T5E; JLCPCB Part C21190
R_X_UNI: 1k output isolation; MPN 0603WAF1001T5E; JLCPCB Part C21190
R_Y_UNI: 1k output isolation; MPN 0603WAF1001T5E; JLCPCB Part C21190
R_Z_UNI: 1k output isolation; MPN 0603WAF1001T5E; JLCPCB Part C21190

Connections:
+5V_ANALOG: DCL_PRES.2 (K); also elsewhere on the board
+8V_ANALOG: DCL_X_UNI.2 (K), DCL_Y_UNI.2 (K), DCL_Z_UNI.2 (K); also elsewhere on the board
DAC_OUT_PRES_STUB: DCL_PRES.3 (COM), R_PRES.1; also elsewhere on the board
DAC_OUT_X_UNI_STUB: DCL_X_UNI.3 (COM), R_X_UNI.1; also elsewhere on the board
DAC_OUT_Y_UNI_STUB: DCL_Y_UNI.3 (COM), R_Y_UNI.1; also elsewhere on the board
DAC_OUT_Z_UNI_STUB: DCL_Z_UNI.3 (COM), R_Z_UNI.1; also elsewhere on the board
GND: DCL_PRES.1 (A), DCL_X_UNI.1 (A), DCL_Y_UNI.1 (A), DCL_Z_UNI.1 (A), D_PRES.2, D_X_UNI.2, D_Y_UNI.2, D_Z_UNI.2, J_PRES.S, J_X_UNI.S, J_Y_UNI.S, J_Z_UNI.S, R_PD_PRES.2, R_PD_X_UNI.2, R_PD_Y_UNI.2, R_PD_Z_UNI.2; also elsewhere on the board
PRESENCE_JACK: D_PRES.1, J_PRES.T, R_PD_PRES.1, R_PRES.2
X_UNI_JACK: D_X_UNI.1, J_X_UNI.T, R_PD_X_UNI.1, R_X_UNI.2
Y_UNI_JACK: D_Y_UNI.1, J_Y_UNI.T, R_PD_Y_UNI.1, R_Y_UNI.2
Z_UNI_JACK: D_Z_UNI.1, J_Z_UNI.T, R_PD_Z_UNI.1, R_Z_UNI.2

Notes on the sheet:
Unipolar jacks presence / RevC as-designed logical connections
Named global labels join sheets. Spare/RDY nets are intentional. USER DNP cross = customer fitted, omitted by PCBA.

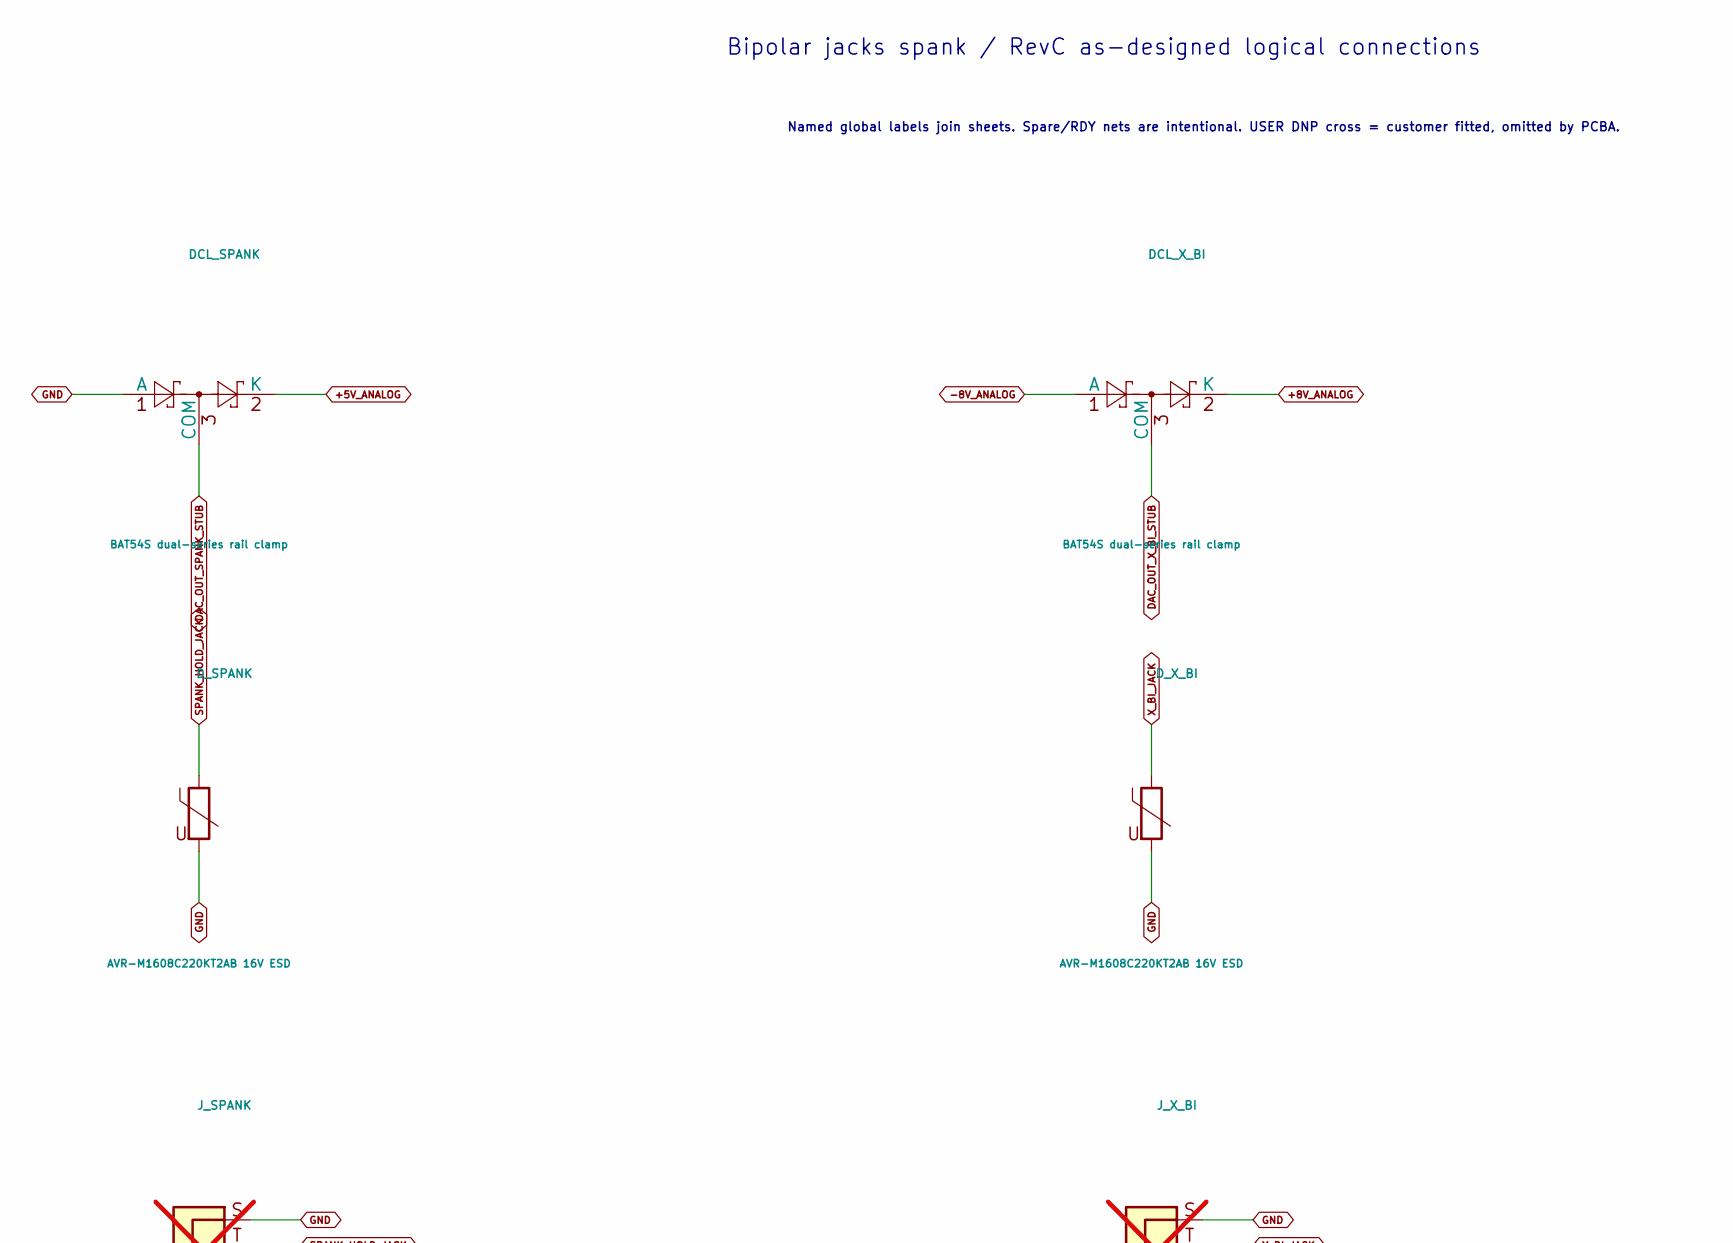
[picture p27: schematic bearcv-10hp-main_dualMCP4728_routed_DRC_pinremap_revc_Bipolar_jacks_spank.kicad_sch, part in row 1, column 1]

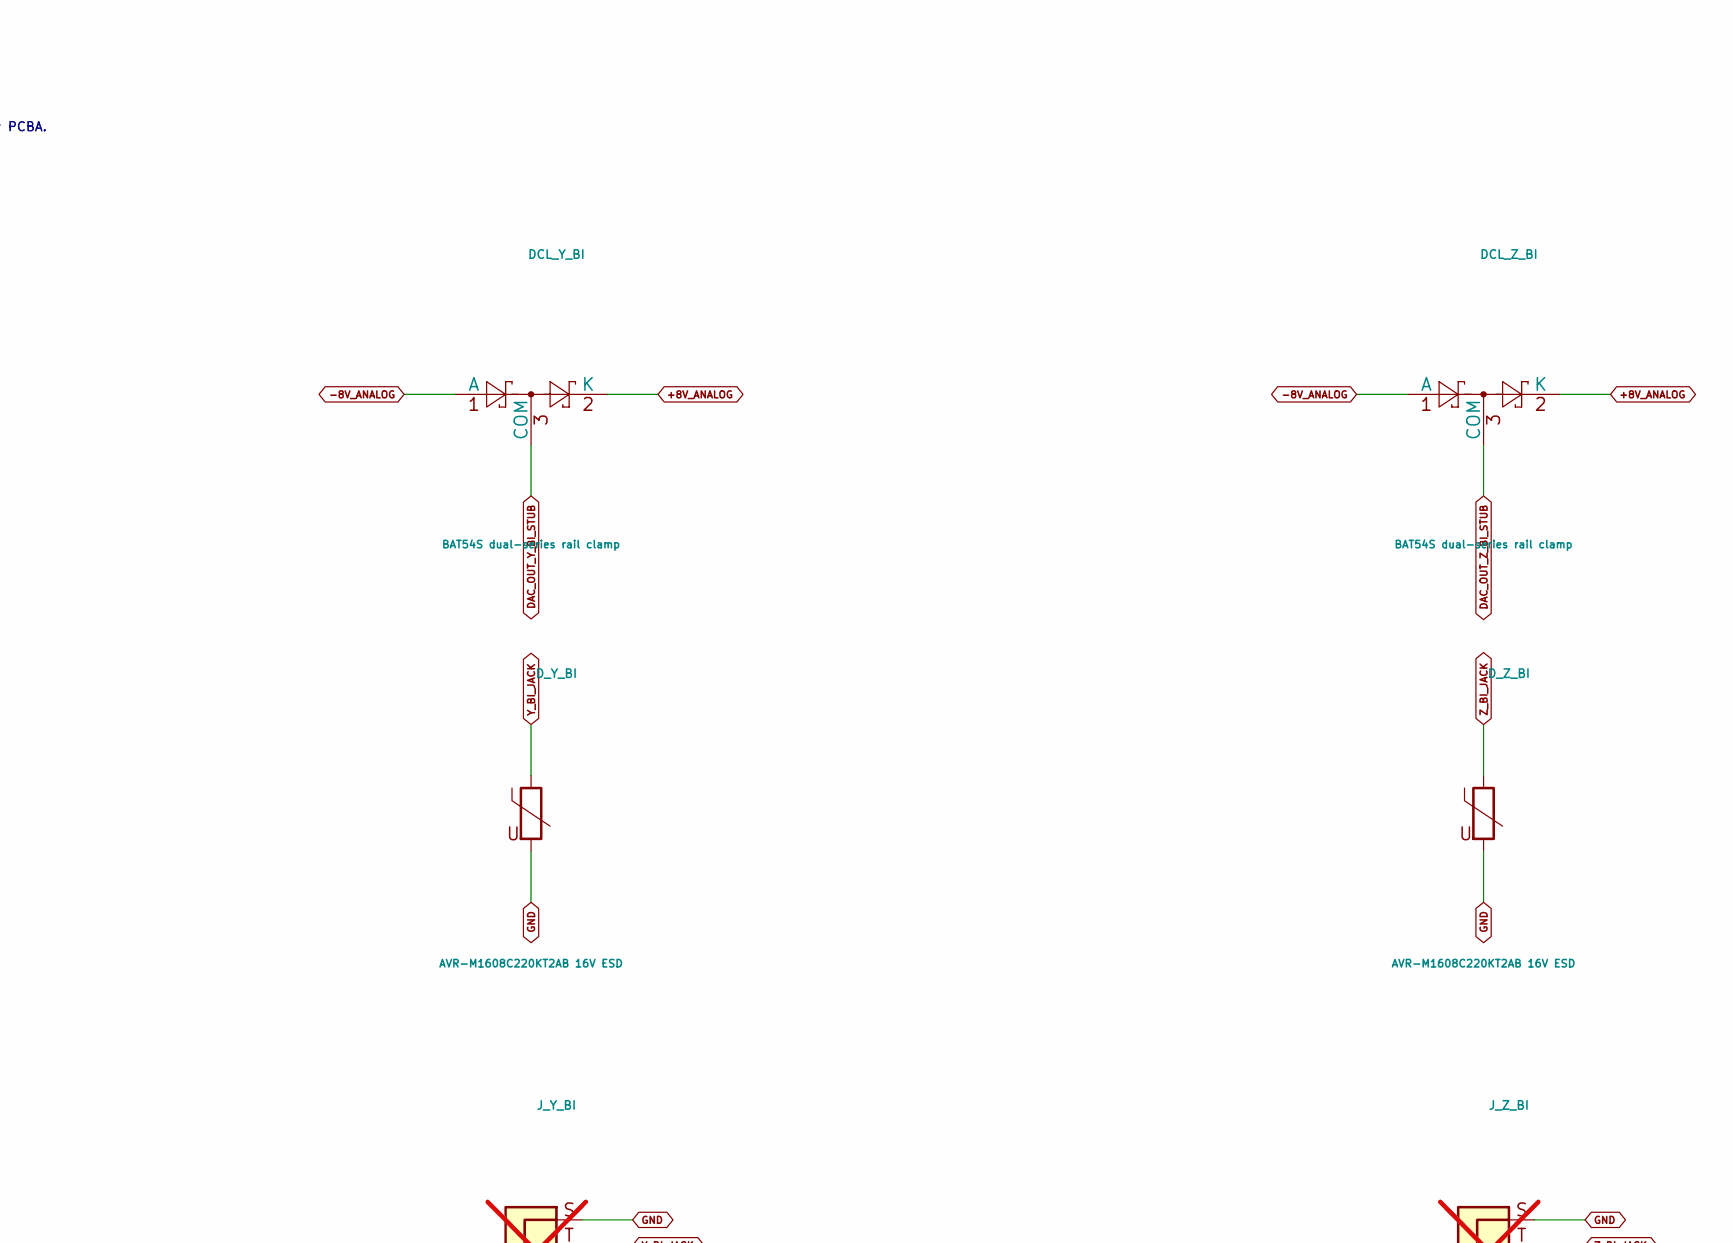
[picture p28: schematic bearcv-10hp-main_dualMCP4728_routed_DRC_pinremap_revc_Bipolar_jacks_spank.kicad_sch, part in row 1, column 2]

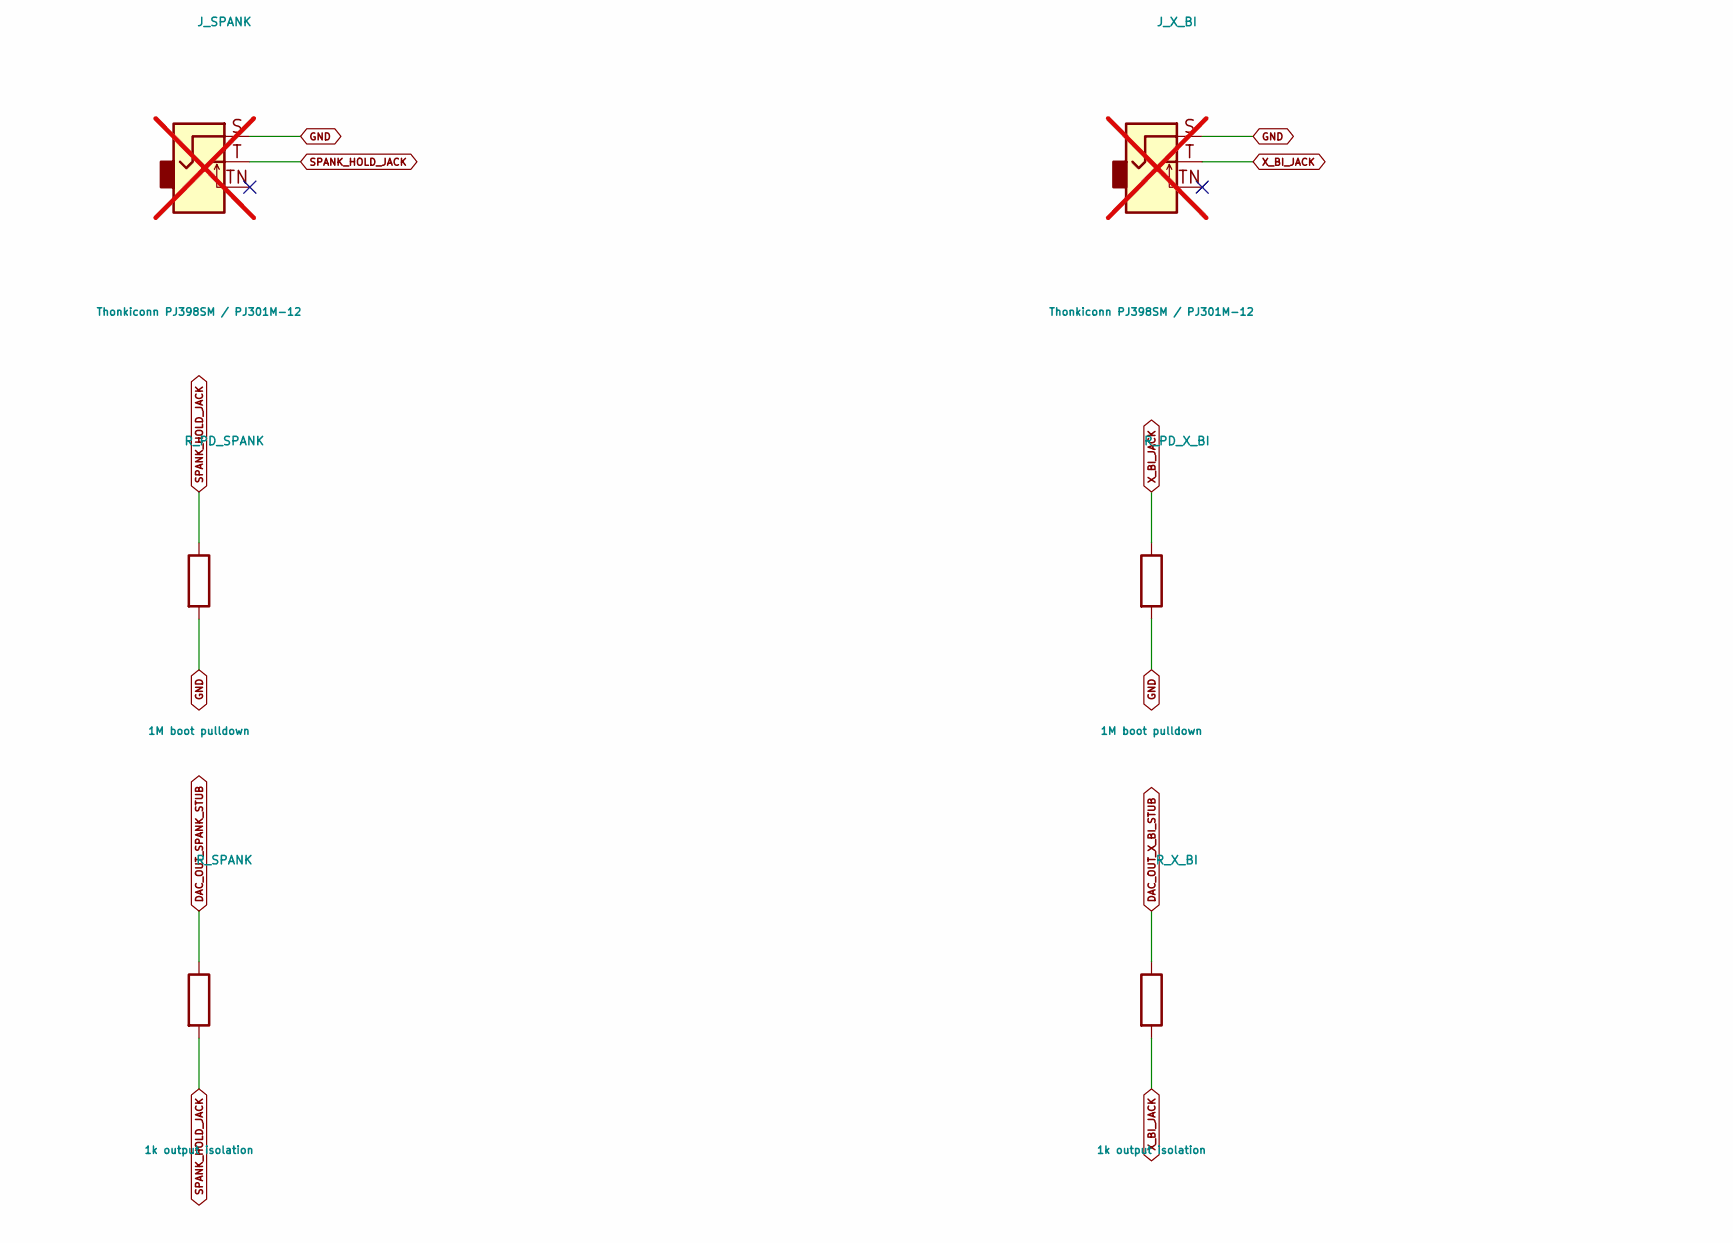
[picture p29: schematic bearcv-10hp-main_dualMCP4728_routed_DRC_pinremap_revc_Bipolar_jacks_spank.kicad_sch, part in row 2, column 1]

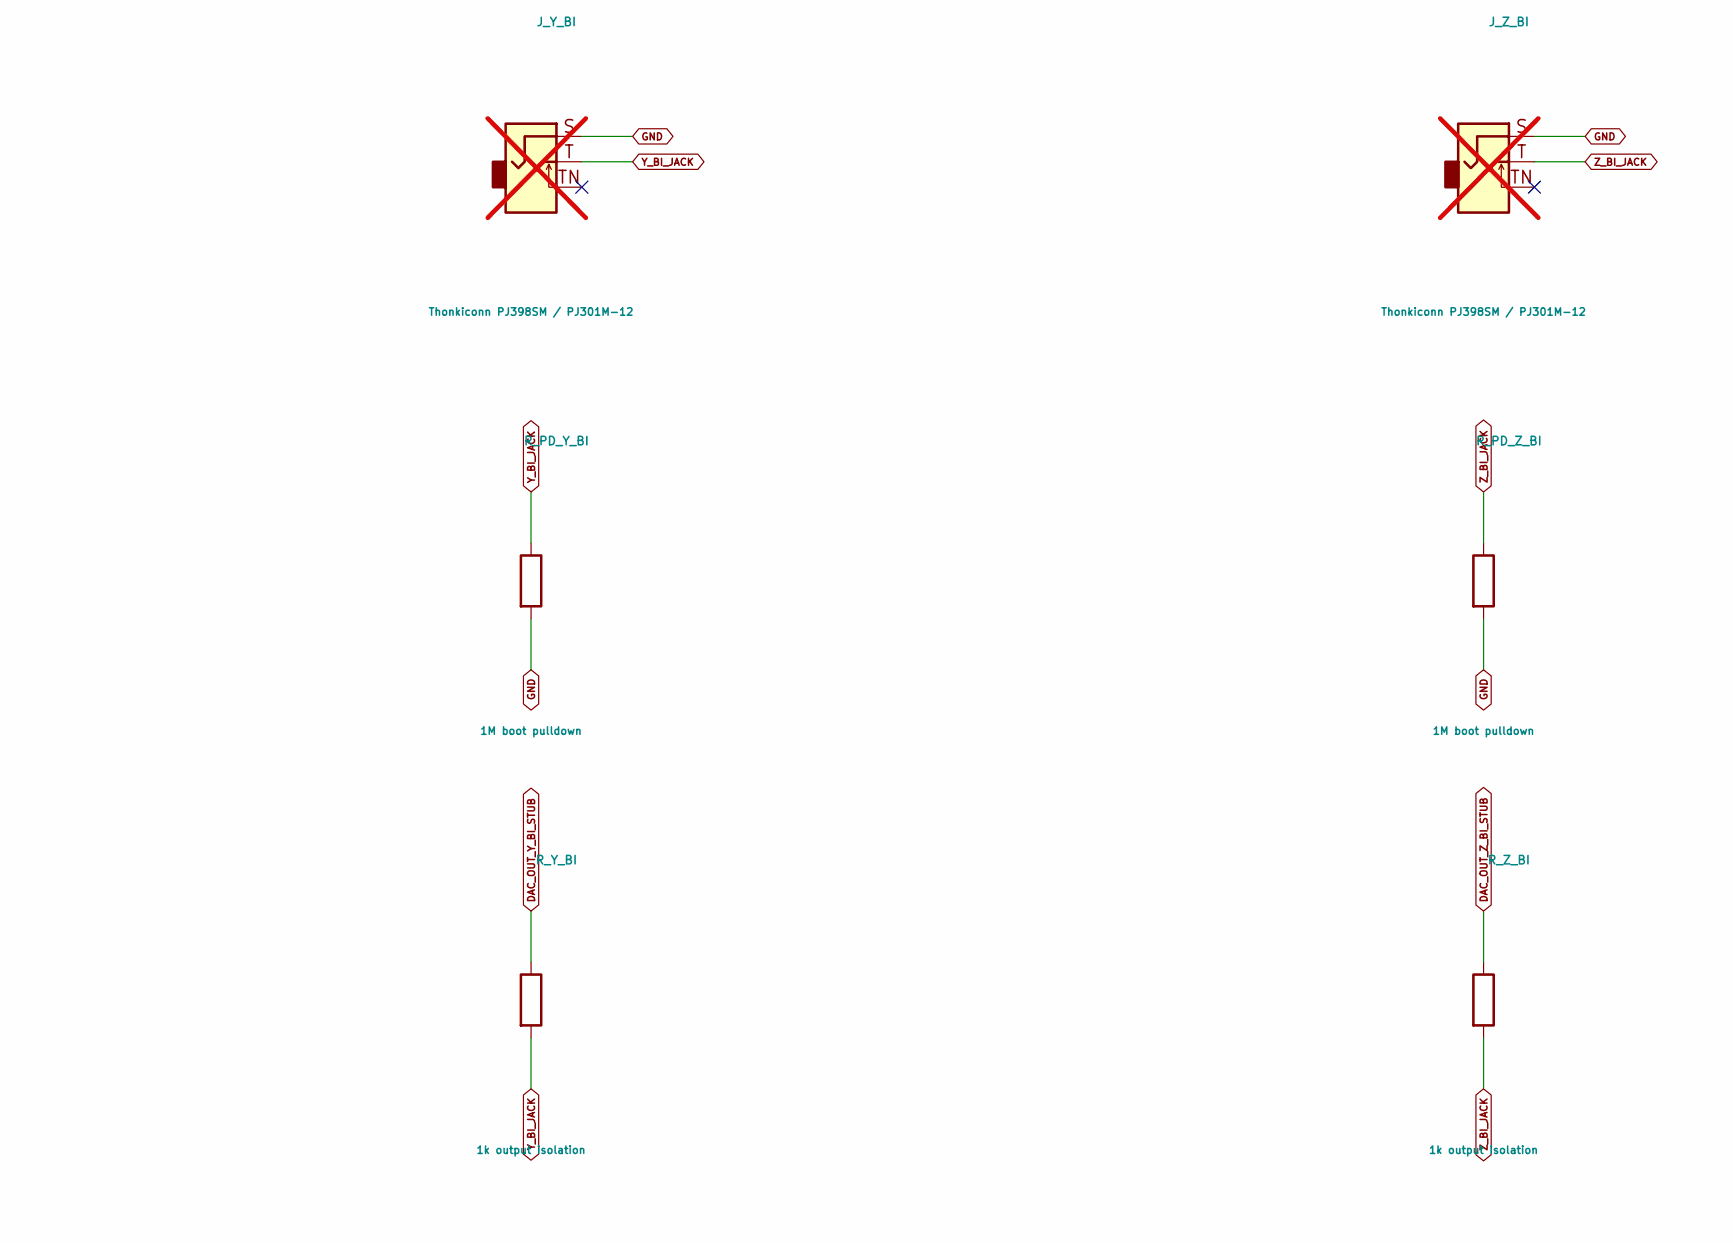
[picture p30: schematic bearcv-10hp-main_dualMCP4728_routed_DRC_pinremap_revc_Bipolar_jacks_spank.kicad_sch, part in row 2, column 2]

Parts:
DCL_SPANK: BAT54S dual-series rail clamp; MPN BAT54S-7-F; JLCPCB Part C83574
DCL_X_BI: BAT54S dual-series rail clamp; MPN BAT54S-7-F; JLCPCB Part C83574
DCL_Y_BI: BAT54S dual-series rail clamp; MPN BAT54S-7-F; JLCPCB Part C83574
DCL_Z_BI: BAT54S dual-series rail clamp; MPN BAT54S-7-F; JLCPCB Part C83574
D_SPANK: AVR-M1608C220KT2AB 16V ESD; MPN AVR-M1608C220KT2AB; JLCPCB Library Extended
D_X_BI: AVR-M1608C220KT2AB 16V ESD; MPN AVR-M1608C220KT2AB; JLCPCB Library Extended
D_Y_BI: AVR-M1608C220KT2AB 16V ESD; MPN AVR-M1608C220KT2AB; JLCPCB Library Extended
D_Z_BI: AVR-M1608C220KT2AB 16V ESD; MPN AVR-M1608C220KT2AB; JLCPCB Library Extended
J_SPANK: Thonkiconn PJ398SM / PJ301M-12; Jack_3.5mm_QingPu_WQP-PJ398SM_Vertical_CircularHoles; MPN DNP; not fitted
J_X_BI: Thonkiconn PJ398SM / PJ301M-12; Jack_3.5mm_QingPu_WQP-PJ398SM_Vertical_CircularHoles; MPN DNP; not fitted
J_Y_BI: Thonkiconn PJ398SM / PJ301M-12; Jack_3.5mm_QingPu_WQP-PJ398SM_Vertical_CircularHoles; MPN DNP; not fitted
J_Z_BI: Thonkiconn PJ398SM / PJ301M-12; Jack_3.5mm_QingPu_WQP-PJ398SM_Vertical_CircularHoles; MPN DNP; not fitted
R_PD_SPANK: 1M boot pulldown; MPN 0603WAF1004T5E; JLCPCB Part C22935
R_PD_X_BI: 1M boot pulldown; MPN 0603WAF1004T5E; JLCPCB Part C22935
R_PD_Y_BI: 1M boot pulldown; MPN 0603WAF1004T5E; JLCPCB Part C22935
R_PD_Z_BI: 1M boot pulldown; MPN 0603WAF1004T5E; JLCPCB Part C22935
R_SPANK: 1k output isolation; MPN 0603WAF1001T5E; JLCPCB Part C21190
R_X_BI: 1k output isolation; MPN 0603WAF1001T5E; JLCPCB Part C21190
R_Y_BI: 1k output isolation; MPN 0603WAF1001T5E; JLCPCB Part C21190
R_Z_BI: 1k output isolation; MPN 0603WAF1001T5E; JLCPCB Part C21190

Connections:
+5V_ANALOG: DCL_SPANK.2 (K); also elsewhere on the board
+8V_ANALOG: DCL_X_BI.2 (K), DCL_Y_BI.2 (K), DCL_Z_BI.2 (K); also elsewhere on the board
-8V_ANALOG: DCL_X_BI.1 (A), DCL_Y_BI.1 (A), DCL_Z_BI.1 (A); also elsewhere on the board
DAC_OUT_SPANK_STUB: DCL_SPANK.3 (COM), R_SPANK.1; also elsewhere on the board
DAC_OUT_X_BI_STUB: DCL_X_BI.3 (COM), R_X_BI.1; also elsewhere on the board
DAC_OUT_Y_BI_STUB: DCL_Y_BI.3 (COM), R_Y_BI.1; also elsewhere on the board
DAC_OUT_Z_BI_STUB: DCL_Z_BI.3 (COM), R_Z_BI.1; also elsewhere on the board
GND: DCL_SPANK.1 (A), D_SPANK.2, D_X_BI.2, D_Y_BI.2, D_Z_BI.2, J_SPANK.S, J_X_BI.S, J_Y_BI.S, J_Z_BI.S, R_PD_SPANK.2, R_PD_X_BI.2, R_PD_Y_BI.2, R_PD_Z_BI.2; also elsewhere on the board
SPANK_HOLD_JACK: D_SPANK.1, J_SPANK.T, R_PD_SPANK.1, R_SPANK.2
X_BI_JACK: D_X_BI.1, J_X_BI.T, R_PD_X_BI.1, R_X_BI.2
Y_BI_JACK: D_Y_BI.1, J_Y_BI.T, R_PD_Y_BI.1, R_Y_BI.2
Z_BI_JACK: D_Z_BI.1, J_Z_BI.T, R_PD_Z_BI.1, R_Z_BI.2

Notes on the sheet:
Bipolar jacks spank / RevC as-designed logical connections
Named global labels join sheets. Spare/RDY nets are intentional. USER DNP cross = customer fitted, omitted by PCBA.
