actuallysparky/bearamin/bearamin-lite/hw/bearcv-10hp/bearcv-10hp-main_dualMCP4728_routed_DRC_pinremap_revc.kicad_pcb

## KiCad design bearamin-lite/hw/bearcv-10hp/bearcv-10hp-main_dualMCP4728_routed_DRC_pinremap_revc.kicad_pcb (continued)

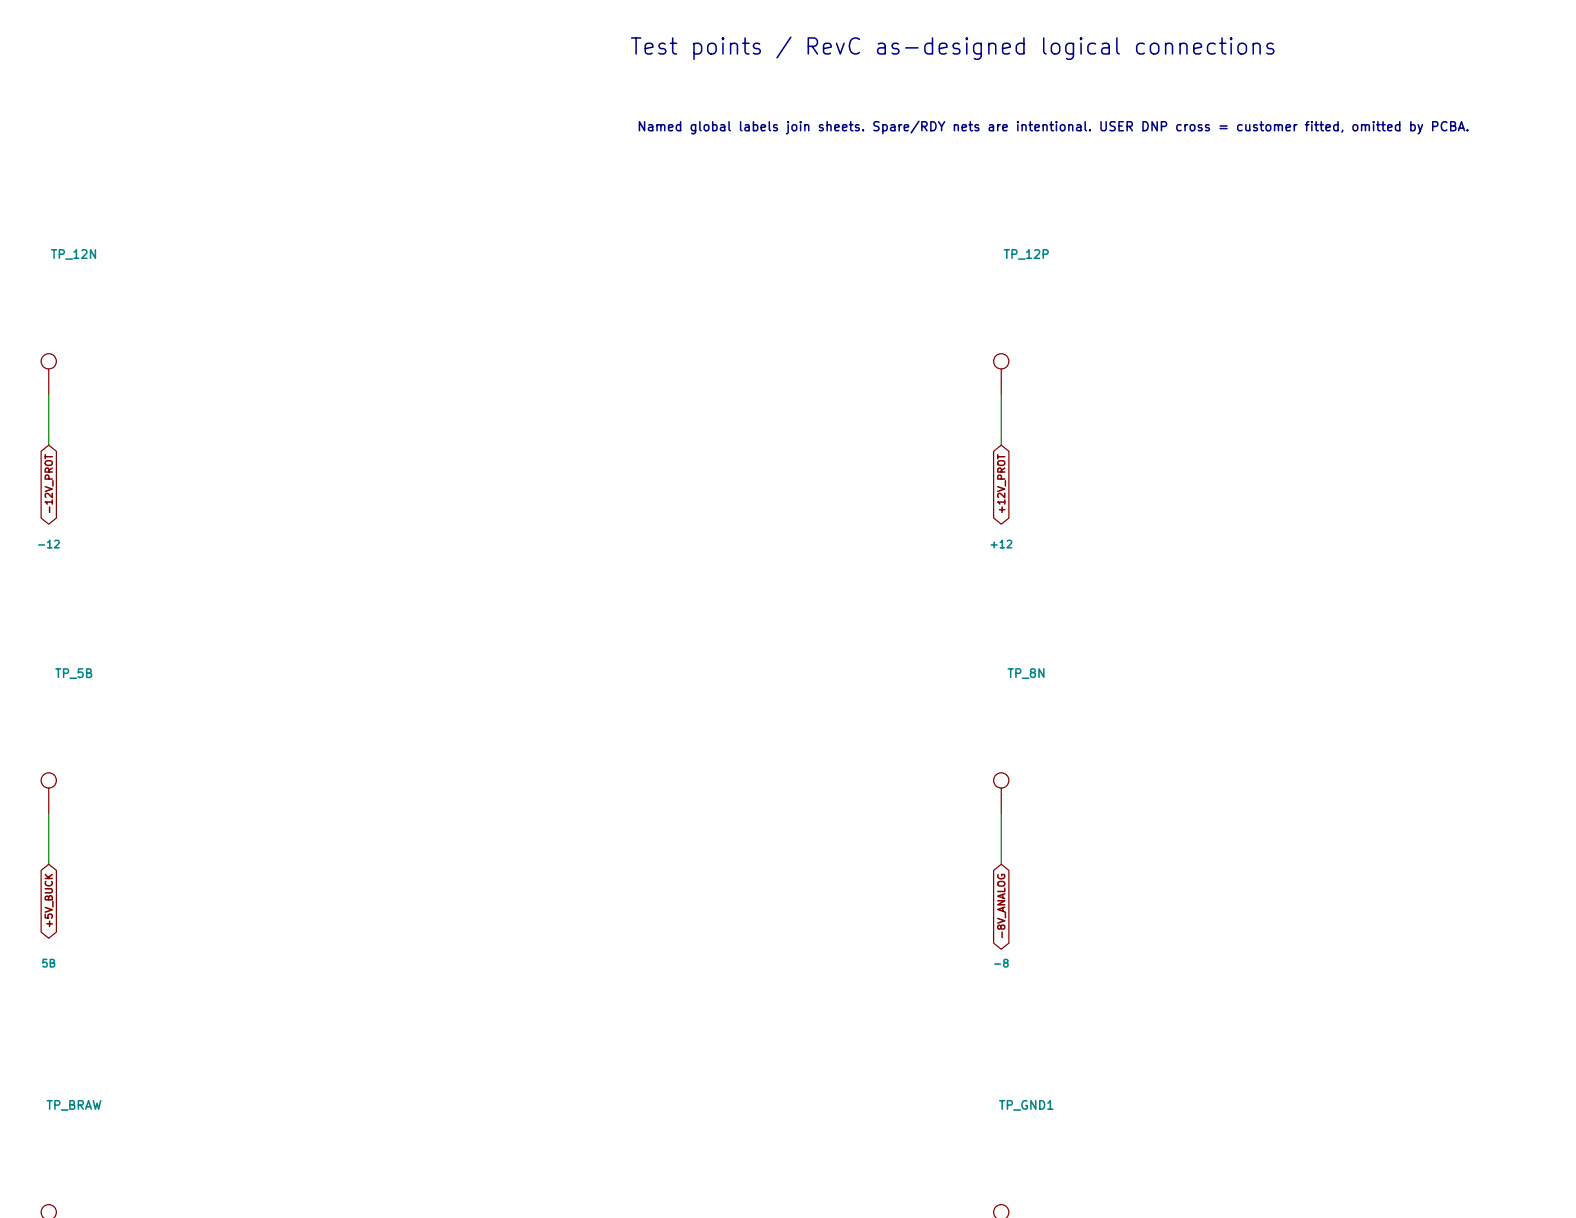
[picture p31: schematic bearcv-10hp-main_dualMCP4728_routed_DRC_pinremap_revc_Test_points.kicad_sch, part in row 1, column 1]

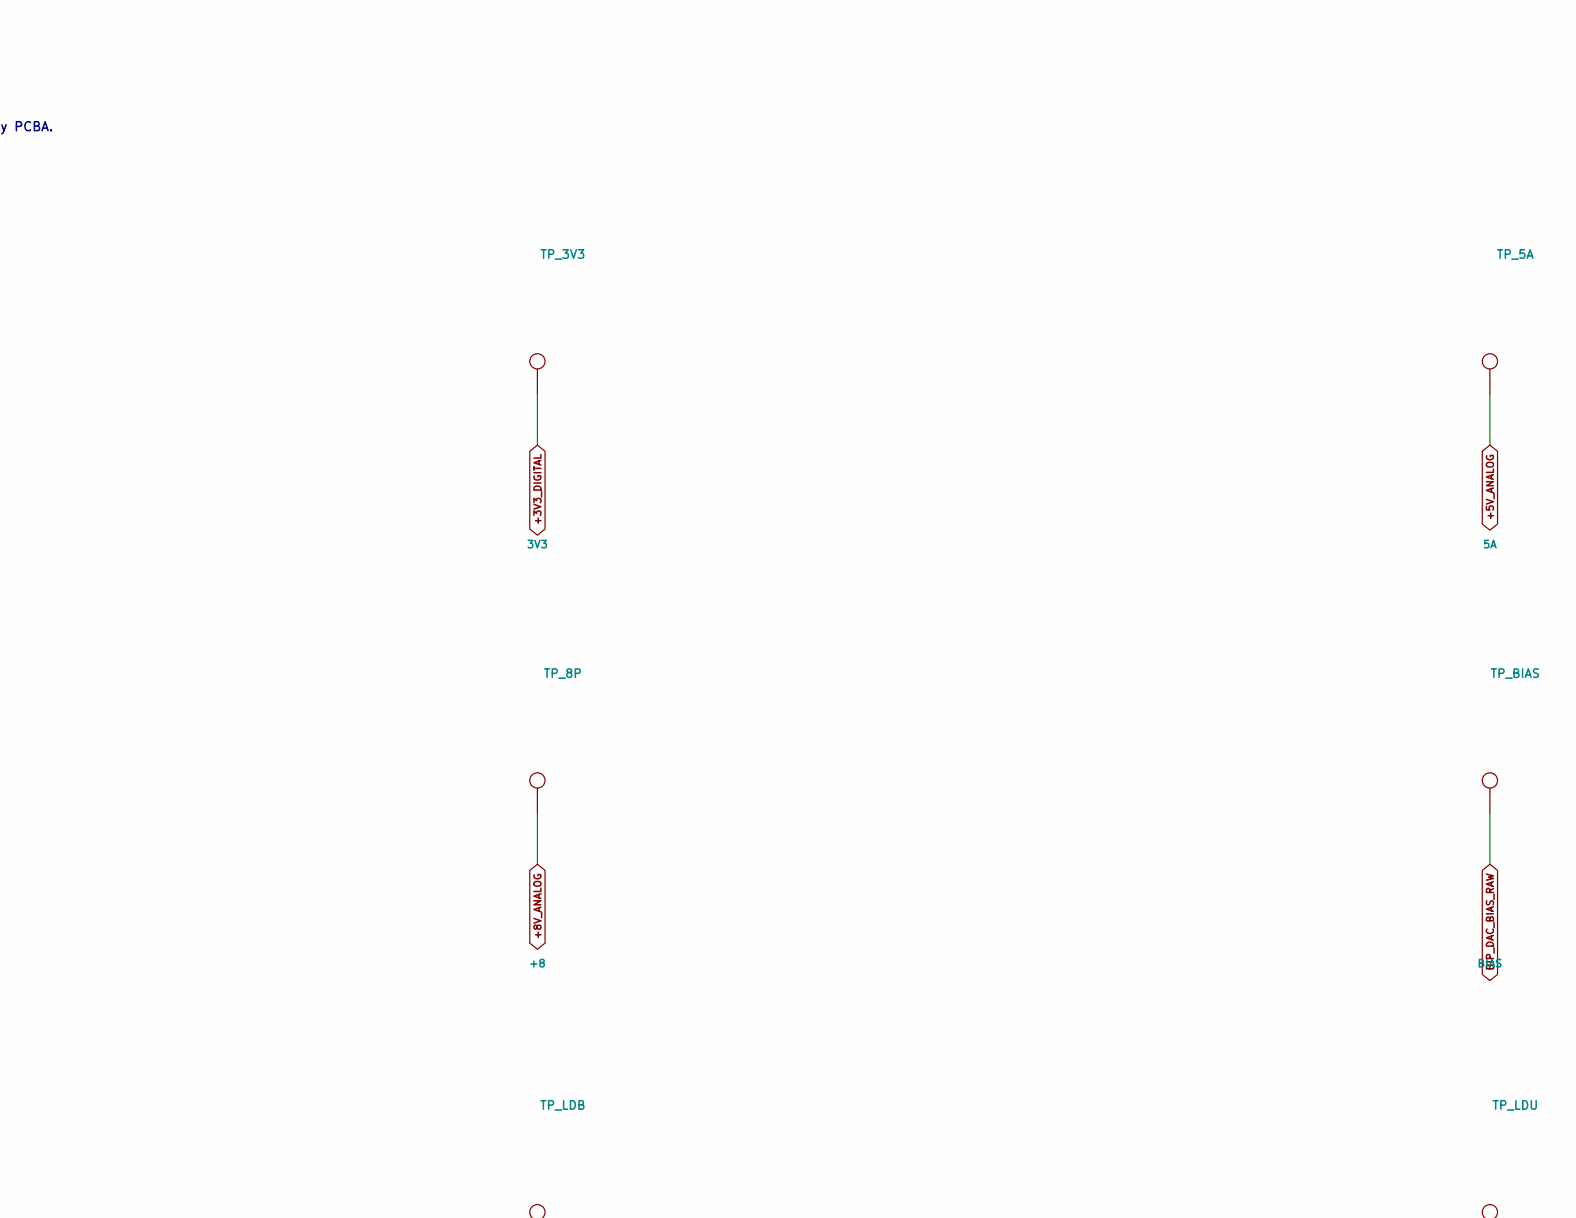
[picture p32: schematic bearcv-10hp-main_dualMCP4728_routed_DRC_pinremap_revc_Test_points.kicad_sch, part in row 1, column 2]

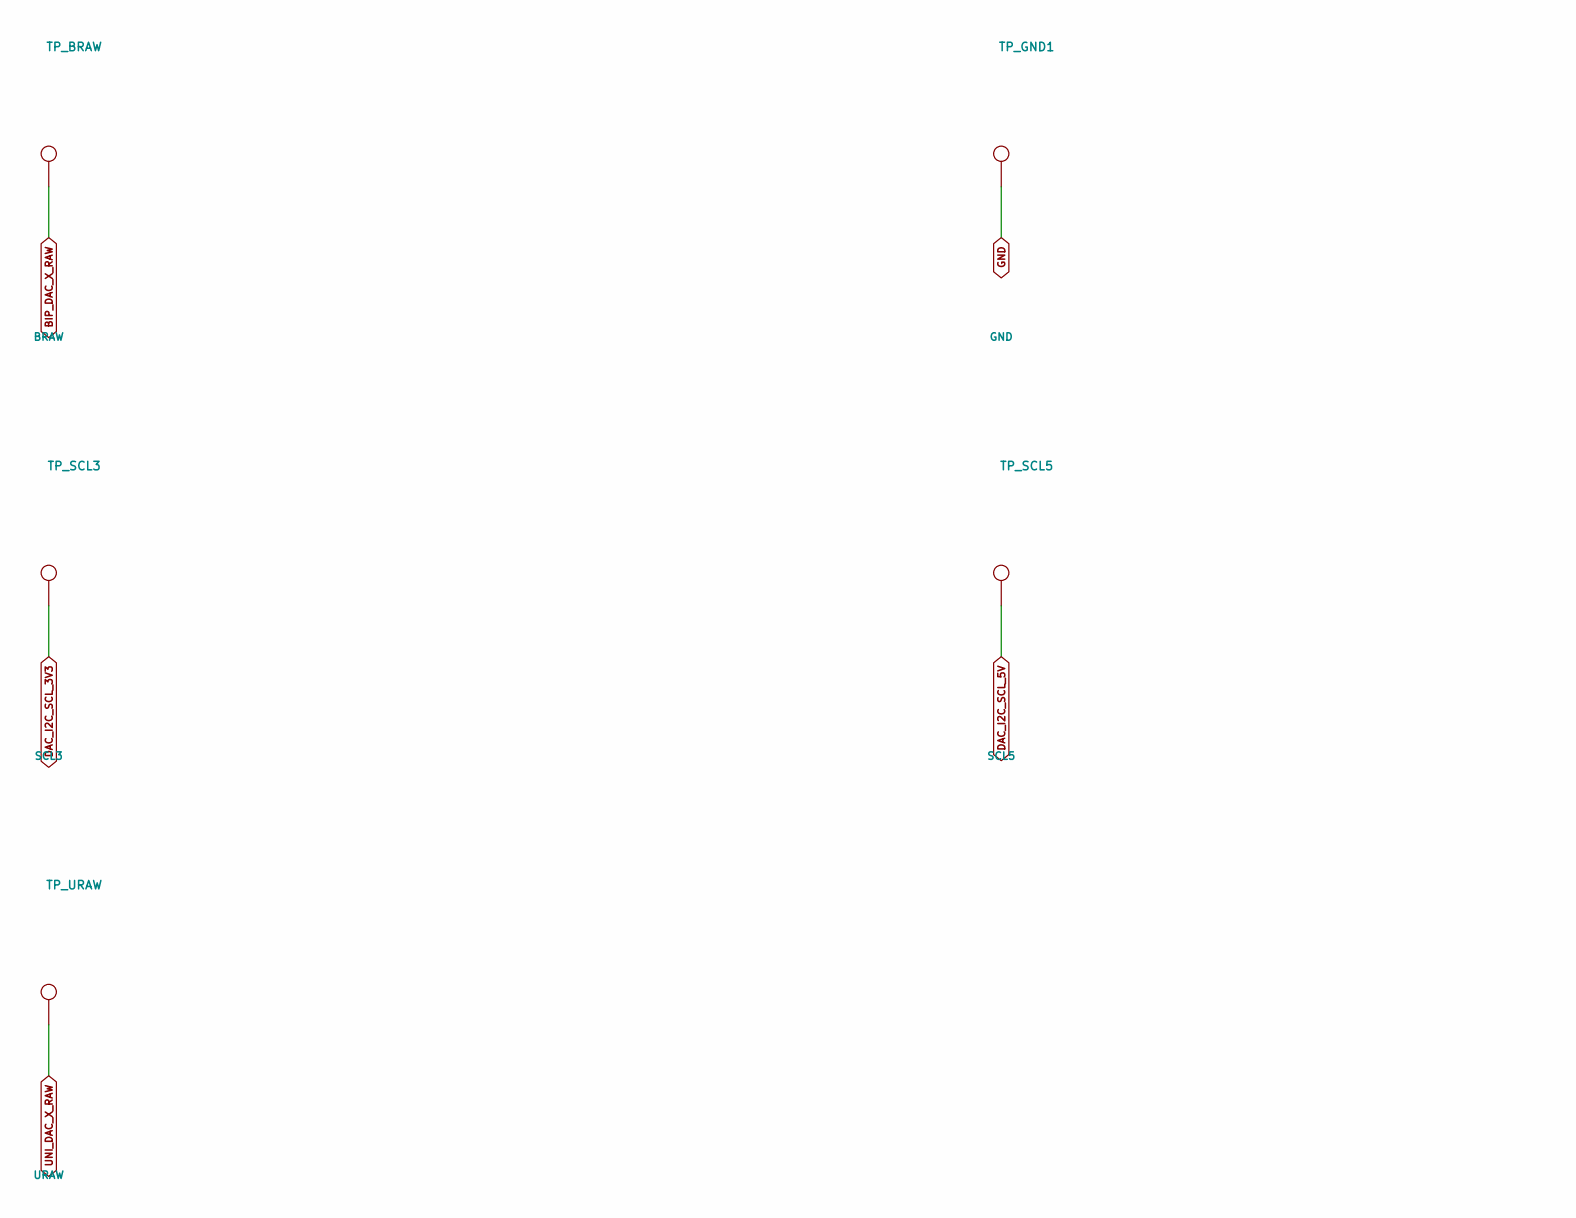
[picture p33: schematic bearcv-10hp-main_dualMCP4728_routed_DRC_pinremap_revc_Test_points.kicad_sch, part in row 2, column 1]

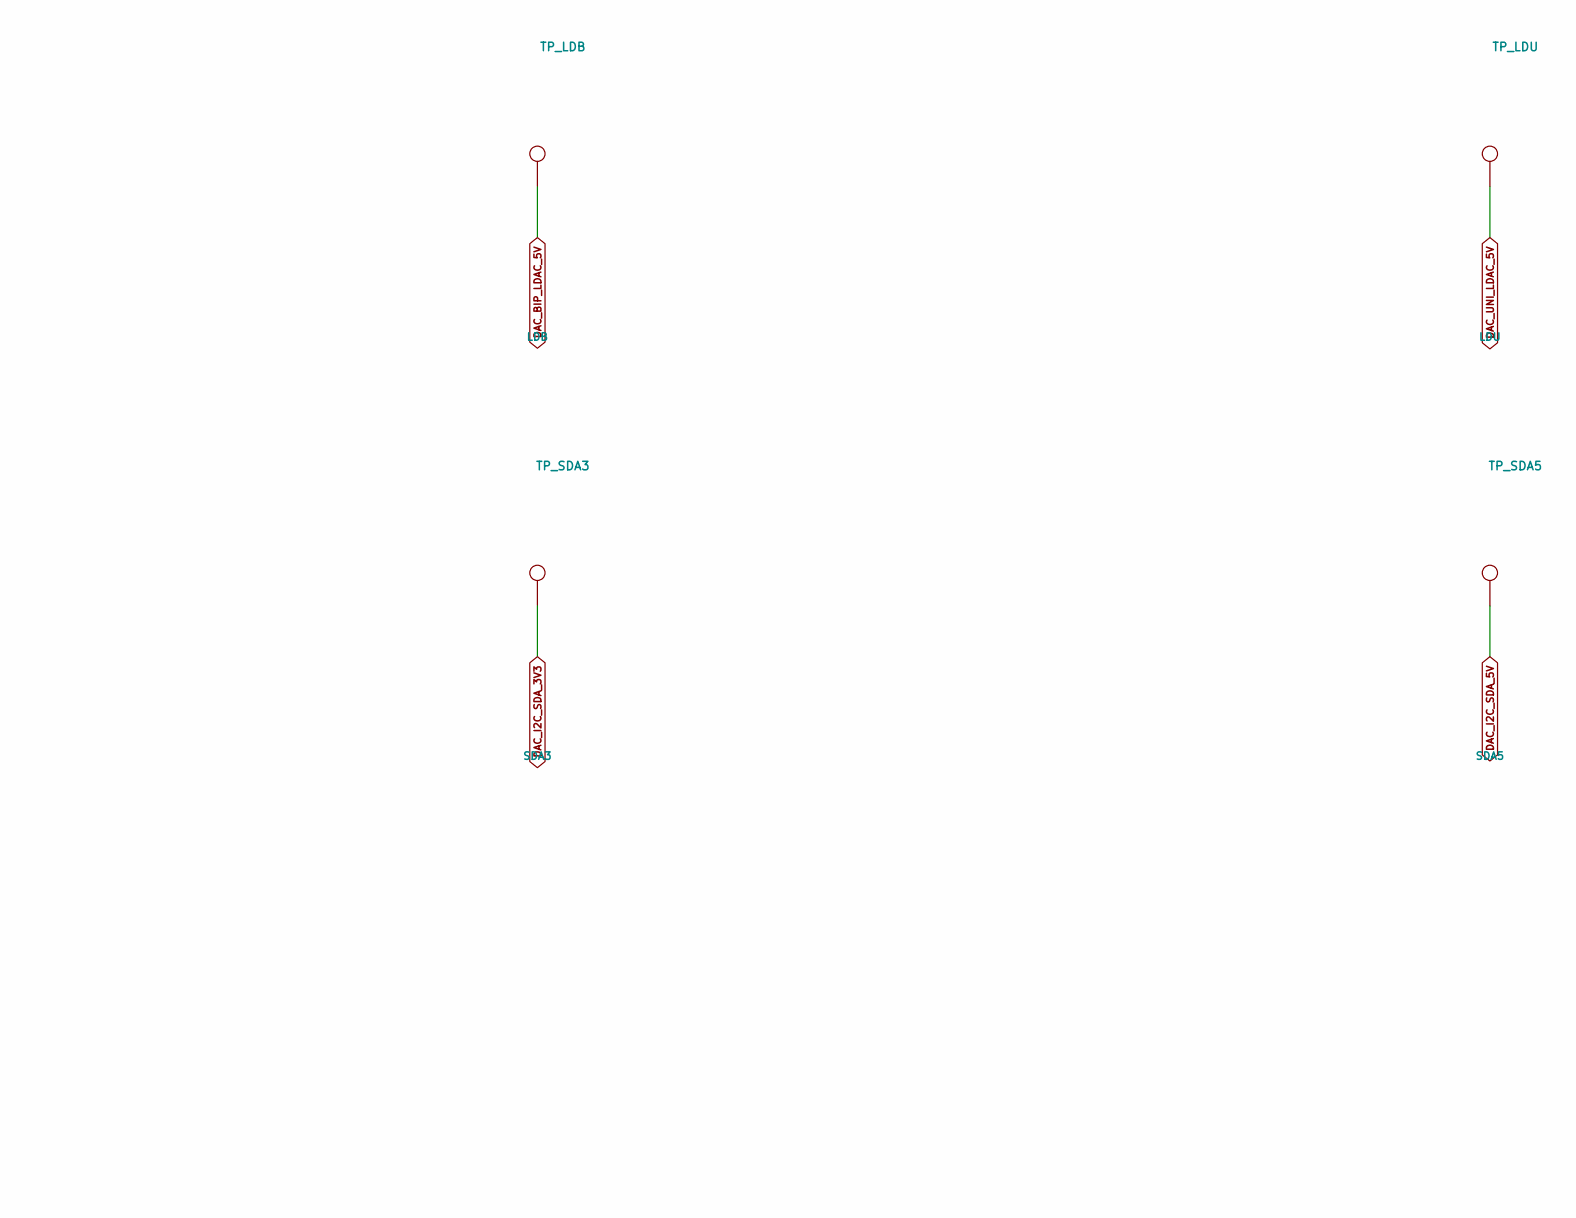
[picture p34: schematic bearcv-10hp-main_dualMCP4728_routed_DRC_pinremap_revc_Test_points.kicad_sch, part in row 2, column 2]

Parts:
TP_3V3: 3V3; MPN N/A
TP_5A: 5A; MPN N/A
TP_5B: 5B; MPN N/A
TP_8N: -8; MPN N/A
TP_8P: +8; MPN N/A
TP_12N: -12; MPN N/A
TP_12P: +12; MPN N/A
TP_BIAS: BIAS; MPN N/A
TP_BRAW: BRAW; MPN N/A
TP_GND1: GND; MPN N/A
TP_LDB: LDB; MPN N/A
TP_LDU: LDU; MPN N/A
TP_SCL3: SCL3; MPN N/A
TP_SCL5: SCL5; MPN N/A
TP_SDA3: SDA3; MPN N/A
TP_SDA5: SDA5; MPN N/A
TP_URAW: URAW; MPN N/A

Connections:
+3V3_DIGITAL: TP_3V3.1; also elsewhere on the board
+5V_ANALOG: TP_5A.1; also elsewhere on the board
+5V_BUCK: TP_5B.1; also elsewhere on the board
+8V_ANALOG: TP_8P.1; also elsewhere on the board
+12V_PROT: TP_12P.1; also elsewhere on the board
-8V_ANALOG: TP_8N.1; also elsewhere on the board
-12V_PROT: TP_12N.1; also elsewhere on the board
BIP_DAC_BIAS_RAW: TP_BIAS.1; also elsewhere on the board
BIP_DAC_X_RAW: TP_BRAW.1; also elsewhere on the board
DAC_BIP_LDAC_5V: TP_LDB.1; also elsewhere on the board
DAC_I2C_SCL_3V3: TP_SCL3.1; also elsewhere on the board
DAC_I2C_SCL_5V: TP_SCL5.1; also elsewhere on the board
DAC_I2C_SDA_3V3: TP_SDA3.1; also elsewhere on the board
DAC_I2C_SDA_5V: TP_SDA5.1; also elsewhere on the board
DAC_UNI_LDAC_5V: TP_LDU.1; also elsewhere on the board
GND: TP_GND1.1; also elsewhere on the board
UNI_DAC_X_RAW: TP_URAW.1; also elsewhere on the board

Notes on the sheet:
Test points / RevC as-designed logical connections
Named global labels join sheets. Spare/RDY nets are intentional. USER DNP cross = customer fitted, omitted by PCBA.

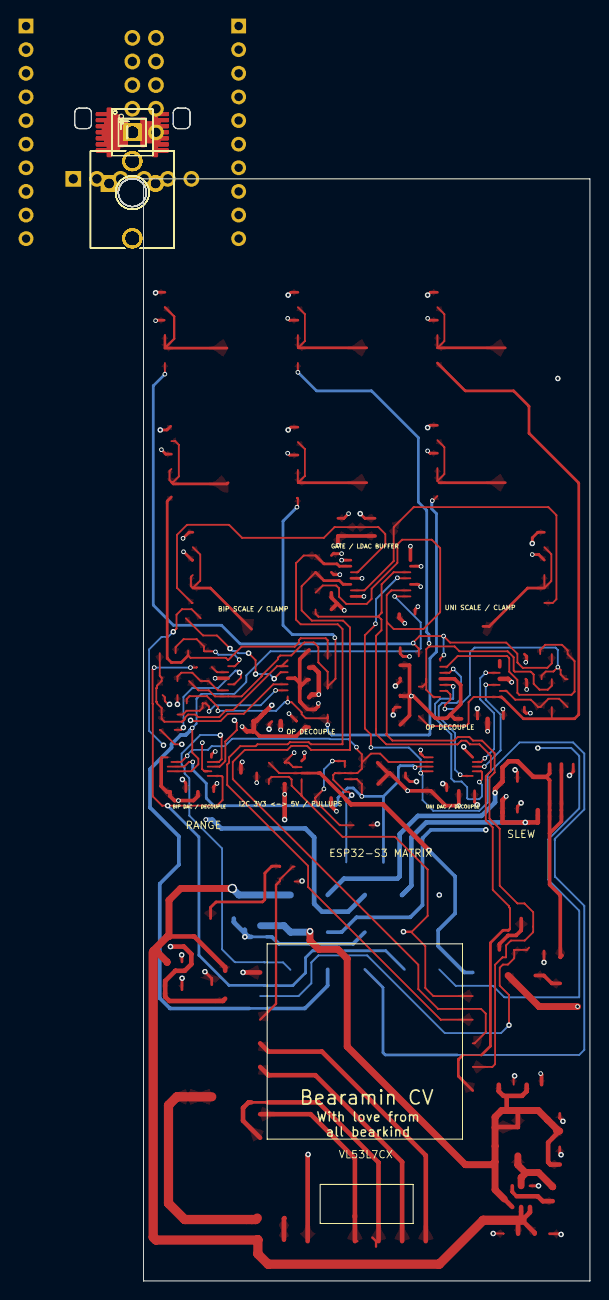
[picture p35: board bearcv-10hp-main_dualMCP4728_routed_DRC_pinremap_revc.kicad_pcb from above]

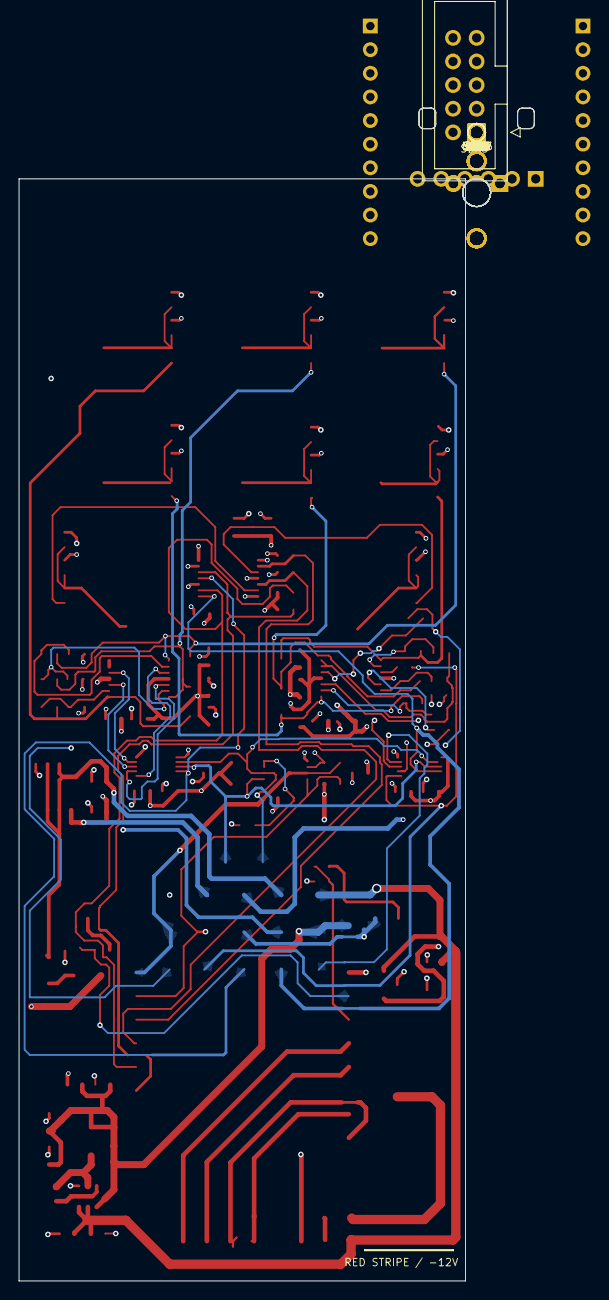
[picture p36: board bearcv-10hp-main_dualMCP4728_routed_DRC_pinremap_revc.kicad_pcb from below]

Board: 4 copper layers, 55.4 x 126.1 mm, 128 parts (18 on the bottom side), 69 nets.
