actuallysparky/bearamin/bearamin/hw/Sidecar-2.0/bearamin-dpt-sensor-RevE.kicad_pcb

## KiCad design bearamin/hw/Sidecar-2.0/bearamin-dpt-sensor-RevE.kicad_pcb (2026-10-14)

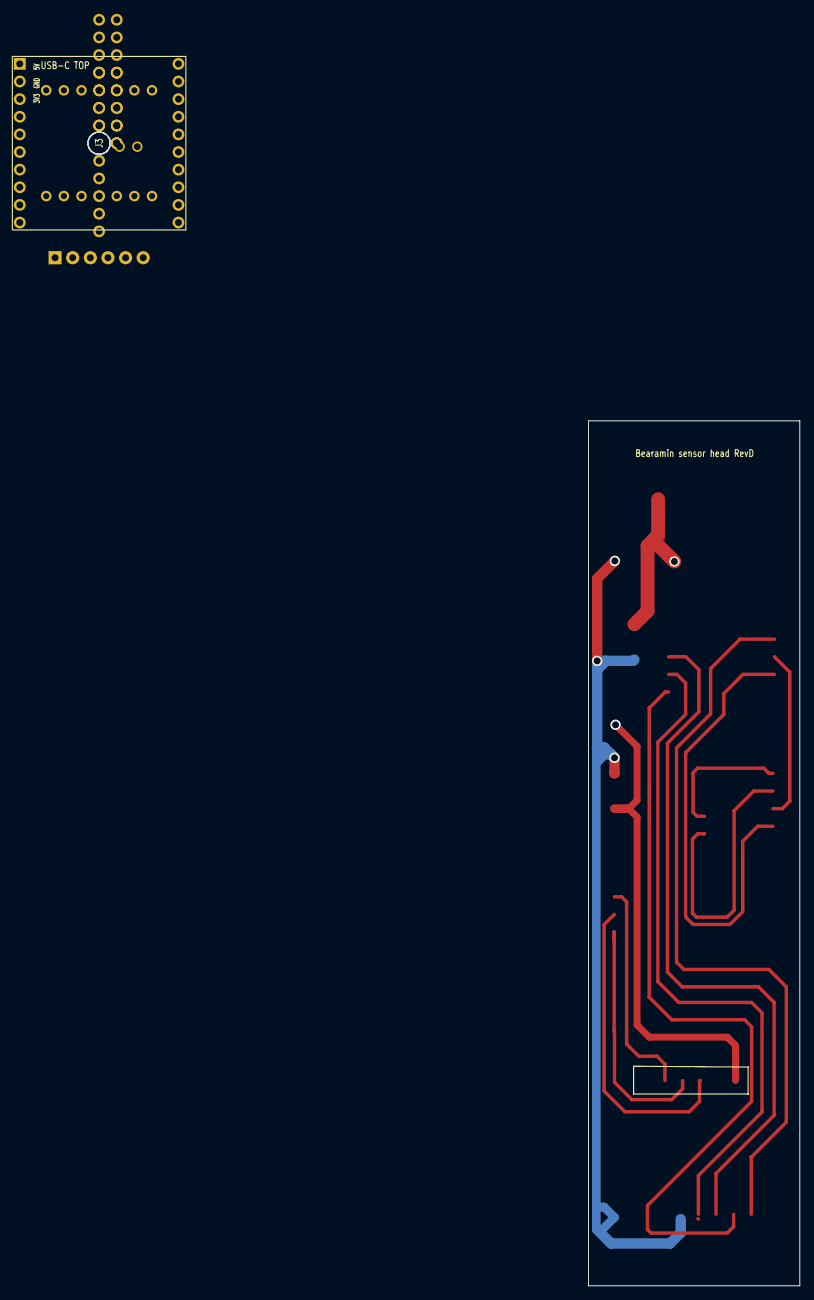
[picture p37: board bearamin-dpt-sensor-RevE.kicad_pcb from above]

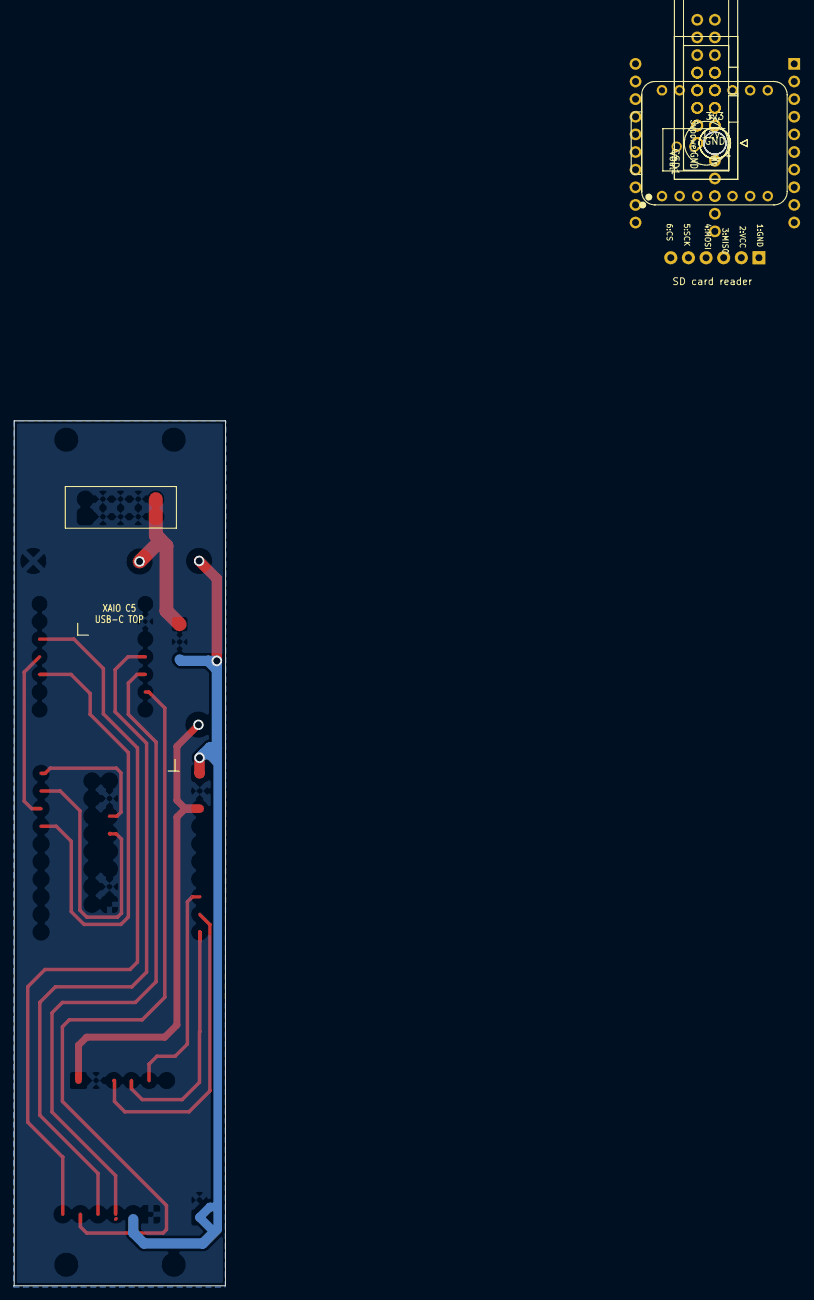
[picture p38: board bearamin-dpt-sensor-RevE.kicad_pcb from below]

Board: 2 copper layers, 30.4 x 124.6 mm, 16 parts (10 on the bottom side), 15 nets.

Parts:
3v3 test: 3v3; TestPoint_Pad_D4.0mm
5v test: 5v; TestPoint_Pad_D4.0mm
5vpower: SIP3_11.6x8.5mm
12v test: 12v; TestPoint_Pad_D4.0mm
CSD1: 47uF 10V; CP_Radial_D6.3mm_P2.50mm
DPTConnector: IDC-Header_2x08_P2.54mm_Vertical
Europlug: Eurorack power; IDC-Header_2x05_P2.54mm_Vertical
H1, H2, H3, H4: MountingHole_3.2mm_M3
J3: VL53L7CX_8x8_Header
JSD1: Micro SD Card Adapter (user-supplied); MicroSD_SPI_Module_6Pin_24x42mm
TND test: GND; TestPoint_Pad_D4.0mm
U1: Seeed XIAO ESP32-S3; XIAO-ESP32-S3-DIP
U3: Waveshare ESP32-S3-Matrix; Waveshare_ESP32-S3-Matrix

Connections:
+3V3: 3v3 test.3v3, J3.1, U3.3V3
+5V: 5v test.5v, 5vpower.3, CSD1.1, JSD1.2, U1.14, U3.5V
+12V_RACK: 5vpower.1, 12v test.12v, Europlug.9, Europlug.10
BEARAMIN_TX_D6_GPIO43_TO_DPT_RX: DPTConnector.11, U3.GP33
DPT_TX_TO_BEARAMIN_RX_D7_GPIO44: DPTConnector.9, U3.GP34
GND: 5vpower.2, CSD1.2, DPTConnector.1, DPTConnector.3, DPTConnector.13, Europlug.3, Europlug.4, Europlug.5, Europlug.6, Europlug.7, Europlug.8, J3.2, JSD1.1, TND test.GND, U1.13, U3.GND
MATRIX_SCL_D1_GPIO2: J3.3, U3.GP2
MATRIX_SDA_D0_GPIO1: J3.4, U3.GP1
MATRIX_TX_GPIO35_TO_XIAO_RX_D3_GPIO4: U1.4, U3.GP35
SD_CS_D2_GPIO3: JSD1.6, U1.3
SD_MISO_D9_GPIO8: JSD1.3, U1.10
SD_MOSI_D10_GPIO9: JSD1.4, U1.11
SD_SCK_D8_GPIO7: JSD1.5, U1.9
VL53L7CX_LPR_GPIO3: J3.5, U3.GP3
XIAO_TX_D4_GPIO5_TO_MATRIX_RX_GPIO36: U1.5, U3.GP36
