actuallysparky/bearamin/bearamin/hw/Sensor-expander/bearamin-dpt-sensor-v6.kicad_pcb

## KiCad design bearamin/hw/Sensor-expander/bearamin-dpt-sensor-v6.kicad_pcb (2026-08-10)

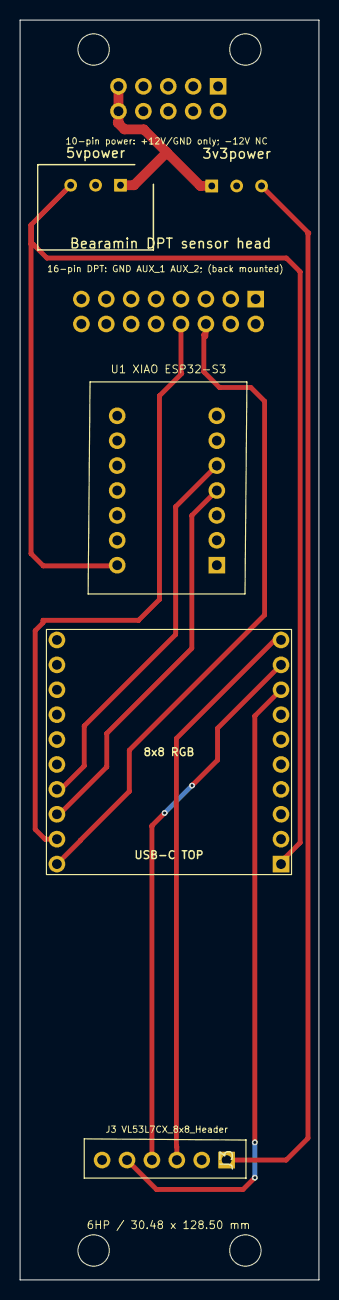
[picture p39: board bearamin-dpt-sensor-v6.kicad_pcb from above]

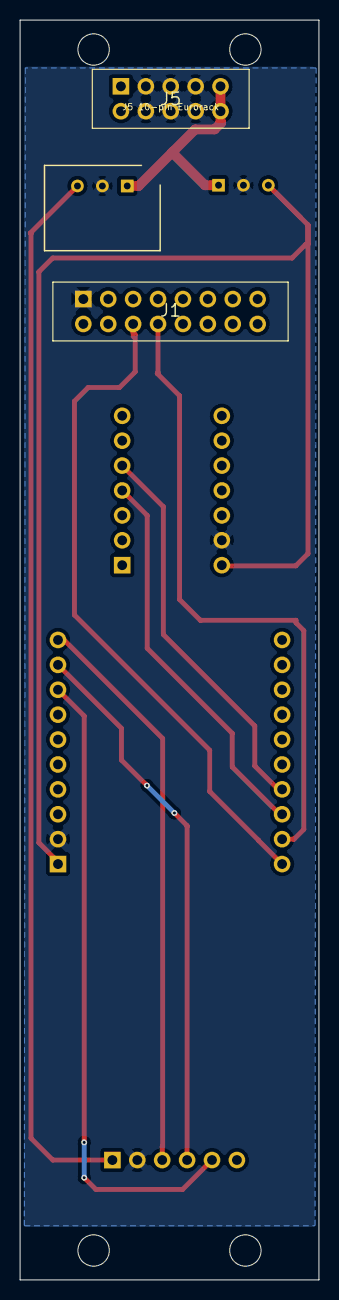
[picture p40: board bearamin-dpt-sensor-v6.kicad_pcb from below]

Board: 2 copper layers, 30.5 x 128.5 mm, 11 parts (3 on the bottom side), 11 nets.

Parts:
3v3power, 5vpower: SIP3_11.6x8.5mm
H1, H2, H3, H4: MountingHole_3.2mm_M3
J1: 16-pin DPT EXP link; DPT_Link_2x8_IDC
J3: VL53L7CX_8x8_Header
J5: 10-pin Eurorack power; Eurorack_Power_2x5_IDC
U1: Seeed XIAO ESP32-S3; Seeed_XIAO_ESP32S3_Header
U3: Waveshare ESP32-S3-Matrix; Waveshare_ESP32-S3-Matrix

Connections:
+3V3: 3v3power.3, J3.1
+5V: 5vpower.3, U1.14, U3.5V
+12V_RACK: 3v3power.1, 5vpower.1, J5.9, J5.10
BEARAMIN_TX_D6_GPIO43_TO_DPT_RX: J1.6, U3.GP33
DPT_TX_TO_BEARAMIN_RX_D7_GPIO44: J1.8, U3.GP34
GND: 3v3power.2, 5vpower.2, J1.1, J3.2, J5.3, J5.4, J5.5, J5.6, J5.7, J5.8, U1.13, U3.GND
MATRIX_SCL_D1_GPIO2: J3.4, U3.GP2
MATRIX_SDA_D0_GPIO1: J3.3, U3.GP1
MATRIX_TX_GPIO35_TO_XIAO_RX_D3_GPIO4: U1.4, U3.GP35
VL53L7CX_LPR_GPIO3: J3.5, U3.GP3
XIAO_TX_D4_GPIO5_TO_MATRIX_RX_GPIO36: U1.5, U3.GP36
