actuallysparky/bearamin/bearamin-lite/firmware/targets/bearamin_virtual_c3.h

#pragma once

namespace bearamin_virtual {
constexpr int kSda = 4;
constexpr int kScl = 5;
constexpr int kLpn = 6;
constexpr int kInt = 7;
constexpr int kSensorHz = 15;
constexpr unsigned kRetryMs = 2000;
constexpr unsigned kStatusMs = 1000;
constexpr unsigned kFrameLineMax = 1024;
}
