actuallysparky/bearamin/bearamin-virtual/vcv/BearaminVirtual/src/plugin.hpp

// SPDX-License-Identifier: GPL-3.0-or-later
// Copyright (c) 2026 Bearamin contributors

#pragma once
#include <rack.hpp>
using namespace rack;
extern Plugin* pluginInstance;
extern Model* modelBearaminVirtual;
