actuallysparky/bearamin/bearamin-virtual/firmware/BearaminVirtual2040/tusb_config.h

#pragma once
#define CFG_TUSB_MCU OPT_MCU_RP2040
#define CFG_TUSB_RHPORT0_MODE (OPT_MODE_DEVICE | OPT_MODE_FULL_SPEED)
#define CFG_TUD_ENABLED 1
#define CFG_TUD_ENDPOINT0_SIZE 64
#define CFG_TUD_CDC 1
#define CFG_TUD_MIDI 1
#define CFG_TUD_CDC_TX_BUFSIZE 2048
#define CFG_TUD_CDC_RX_BUFSIZE 64
#define CFG_TUD_MIDI_TX_BUFSIZE 64
#define CFG_TUD_MIDI_RX_BUFSIZE 64
