actuallysparky/bearamin/bearamin-lite/firmware/BearaminLiteMidi/build_identity.h

#pragma once
// Build wrapper overrides both values with a unique timestamp for local builds.
#ifndef LITE_BUILD_ID
#define LITE_BUILD_ID 0
#endif
#ifndef LITE_VERSION
#define LITE_VERSION "0.2.0-prototype"
#endif
