actuallysparky/bearamin/bearamin/dpt/DPT.multimode/tests/multimode_engine_test.cpp

#include "../MultimodeEngine.h"
#include "../BearaminPredictor.h"
#include "../PresetProtocol.h"
#include "../RealtimeSnapshot.h"

#include <assert.h>
#include <math.h>
#include <stdio.h>
#include <string.h>

namespace mm = dpt_multimode;

void AssertClose(float actual, float expected, float tolerance)
{
    if(fabsf(actual - expected) > tolerance)
    {
        printf("expected %.6f, got %.6f\n", expected, actual);
        assert(false);
    }
}

void TestModeSelection()
{
    assert(mm::ModeIndexFromRaw(-1.0f) == 0);
    assert(mm::ModeIndexFromRaw(0.0f) == 0);
    assert(mm::ModeIndexFromRaw(0.199f) == 0);
    assert(mm::ModeIndexFromRaw(0.20f) == 1);
    assert(mm::ModeIndexFromRaw(0.50f) == 2);
    assert(mm::ModeIndexFromRaw(0.999f) == 4);
    assert(mm::ModeIndexFromRaw(1.0f) == 4);

    assert(mm::ModeIndexFromControl(-1.0f) == 0);
    assert(mm::ModeIndexFromControl(-0.1f) == 0);
    assert(mm::ModeIndexFromControl(0.0f) == 0);
    assert(mm::ModeIndexFromControl(0.19f) == 0);
    assert(mm::ModeIndexFromControl(0.21f) == 1);
    assert(mm::ModeIndexFromControl(0.41f) == 2);
    assert(mm::ModeIndexFromControl(0.61f) == 3);
    assert(mm::ModeIndexFromControl(0.81f) == 4);
    assert(mm::ModeIndexFromControl(1.0f) == 4);

    for(int index = 0; index < mm::kSelectableModeCount; ++index)
    {
        const float midpoint
            = (static_cast<float>(index) + 0.5f)
              / static_cast<float>(mm::kSelectableModeCount);
        assert(static_cast<int>(mm::SelectModeFromControl(midpoint)) == index);
    }

    assert(static_cast<int>(mm::Mode::RingsModal) == 0);
    assert(static_cast<int>(mm::Mode::RingsSympatheticStrings) == 1);
    assert(static_cast<int>(mm::Mode::RingsKarplusStrong) == 2);
    assert(static_cast<int>(mm::Mode::StackedFmDrone) == 3);
    assert(static_cast<int>(mm::Mode::BearaminBridge) == 4);
    assert(mm::RingsAlgorithmForMode(mm::Mode::RingsModal)
           == mm::RingsAlgorithm::Modal);
    assert(mm::RingsAlgorithmForMode(mm::Mode::RingsSympatheticStrings)
           == mm::RingsAlgorithm::SympatheticStrings);
    assert(mm::RingsAlgorithmForMode(mm::Mode::RingsKarplusStrong)
           == mm::RingsAlgorithm::KarplusStrong);
    assert(mm::RingsAlgorithmForMode(mm::Mode::StackedFmDrone)
           == mm::RingsAlgorithm::None);
}

void TestModeAnnouncementPaths()
{
    assert(strcmp(mm::ModeAnnouncementPath(mm::Mode::RingsModal),
                  "dpt-modes/modal.wav")
           == 0);
    assert(strcmp(mm::ModeAnnouncementPath(mm::Mode::RingsSympatheticStrings),
                  "dpt-modes/bearamin_resonator.wav")
           == 0);
    assert(strcmp(mm::ModeAnnouncementPath(mm::Mode::RingsKarplusStrong),
                  "dpt-modes/karplus_strong.wav")
           == 0);
    assert(strcmp(mm::ModeAnnouncementPath(mm::Mode::StackedFmDrone),
                  "dpt-modes/bearamin_fm_drone.wav")
           == 0);
    assert(strcmp(mm::ModeAnnouncementPath(mm::Mode::BearaminBridge),
                  "dpt-modes/bearamin.wav")
           == 0);
}

void TestUnityAudioBlend()
{
    AssertClose(mm::UnityAudioBlend(0.25f, 0.50f), 0.75f, 0.0001f);
    AssertClose(mm::UnityAudioBlend(-0.25f, 0.50f), 0.25f, 0.0001f);
    AssertClose(mm::UnityAudioBlend(0.75f, 0.75f), 1.0f, 0.0001f);
    AssertClose(mm::UnityAudioBlend(-0.75f, -0.75f), -1.0f, 0.0001f);
}

void TestDptStatusEncoding()
{
    assert(mm::QuantizeDptControl(-1.0f) == 0);
    assert(mm::QuantizeDptControl(0.0f) == 0);
    assert(mm::QuantizeDptControl(0.5f) == 128);
    assert(mm::QuantizeDptControl(1.0f) == 255);
    assert(mm::QuantizeDptPanelPosition(-1.0f) == 0);
    assert(mm::QuantizeDptPanelPosition(0.0f) == 0);
    assert(mm::QuantizeDptPanelPosition(0.5f) == 128);
    assert(mm::QuantizeDptPanelPosition(1.0f) == 255);

    const uint8_t controls[mm::kDptControlCount] = {
        0x00, 0x11, 0x22, 0x33, 0x80, 0xAA, 0xFE, 0xFF};
    char line[40] = {};
    const size_t length = mm::EncodeDptStatusLine(
        static_cast<uint8_t>(mm::Mode::BearaminBridge),
        controls,
        0x0003,
        0x2A,
        line,
        sizeof(line));
    assert(length == strlen("DPTS,3,04,0011223380AAFEFF,0003,2A\n"));
    assert(strcmp(line, "DPTS,3,04,0011223380AAFEFF,0003,2A\n") == 0);

    char too_small[8] = {};
    assert(mm::EncodeDptStatusLine(0, controls, 0, 0, too_small, sizeof(too_small))
           == 0);
}

void TestDptPerformanceEncoding()
{
    mm::DptPerformanceSnapshot snapshot = {};
    snapshot.callback_count   = 0x01234567;
    snapshot.max_callback_us  = 0x00000321;
    snapshot.deadline_misses  = 2;
    snapshot.late_starts      = 3;
    snapshot.missed_periods   = 4;
    snapshot.max_start_gap_us = 0x00000456;
    snapshot.tx_call_count    = 0x89ABCDEF;
    snapshot.max_irq_off_us   = 0x000000F0;
    snapshot.max_tx_call_us   = 0x00005208;
    char line[96] = {};
    const size_t length
        = mm::EncodeDptPerformanceLine(snapshot, line, sizeof(line));
    assert(length
           == strlen("DPTP,1,01234567,00000321,00000002,00000003,"
                     "00000004,00000456,89ABCDEF,000000F0,00005208\n"));
    assert(strcmp(line,
                  "DPTP,1,01234567,00000321,00000002,00000003,"
                  "00000004,00000456,89ABCDEF,000000F0,00005208\n")
           == 0);

    char too_small[88] = {};
    assert(mm::EncodeDptPerformanceLine(
               snapshot, too_small, sizeof(too_small))
           == 0);
}
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
