actuallysparky/bearamin/(commit log)

2026-08-10 Initial private review import
    [bearamin-dpt-sensor-v6.kicad_pcb, dpt-daisy-seed-qspi.cfg]
2026-10-14 Organize the full instrument as the Bearamin family subproject
    [bearamin-dpt-sensor-v6.kicad_pcb, dpt-daisy-seed-qspi.cfg]
2026-10-14 Refresh sidecar hardware and portable development tools
    [bearamin-dpt-sensor-RevD.kicad_sch, bearamin-dpt-sensor-RevE.kicad_pcb]
2026-10-14 Introduce Bearamin Lite with CV, USB MIDI and Bluetooth MIDI
    [bearcv-10hp-main_dualMCP4728_routed_DRC_pinremap_revc.kicad_pcb, bearcv-10hp-main_dualMCP4728_routed_DRC_pinremap_revc.kicad_sch, bearcv-10hp-main_dualMCP4728_routed_DRC_pinremap_revc_Bipolar_jacks_spank.kicad_sch, bearcv-10hp-main_dualMCP4728_routed_DRC_pinremap_revc_Bipolar_scaling.kicad_sch, bearcv-10hp-main_dualMCP4728_routed_DRC_pinremap_revc_Controller_sensor_controls.kicad_sch, bearcv-10hp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]
2026-10-14 Introduce Bearamin Virtual with RP2040 firmware, hardware and VCV Rack plugin
    [Bearamin-Virtual_2040.kicad_pcb, Bearamin-Virtual_2040.kicad_sch]
2026-10-14 Update Bearamin Lite requirements in README
    Updated the requirements for Bearamin Lite to include the Optical VL53L7CX sensor.
